Tellurnoid/25RoboCup/poster/138062.jpg

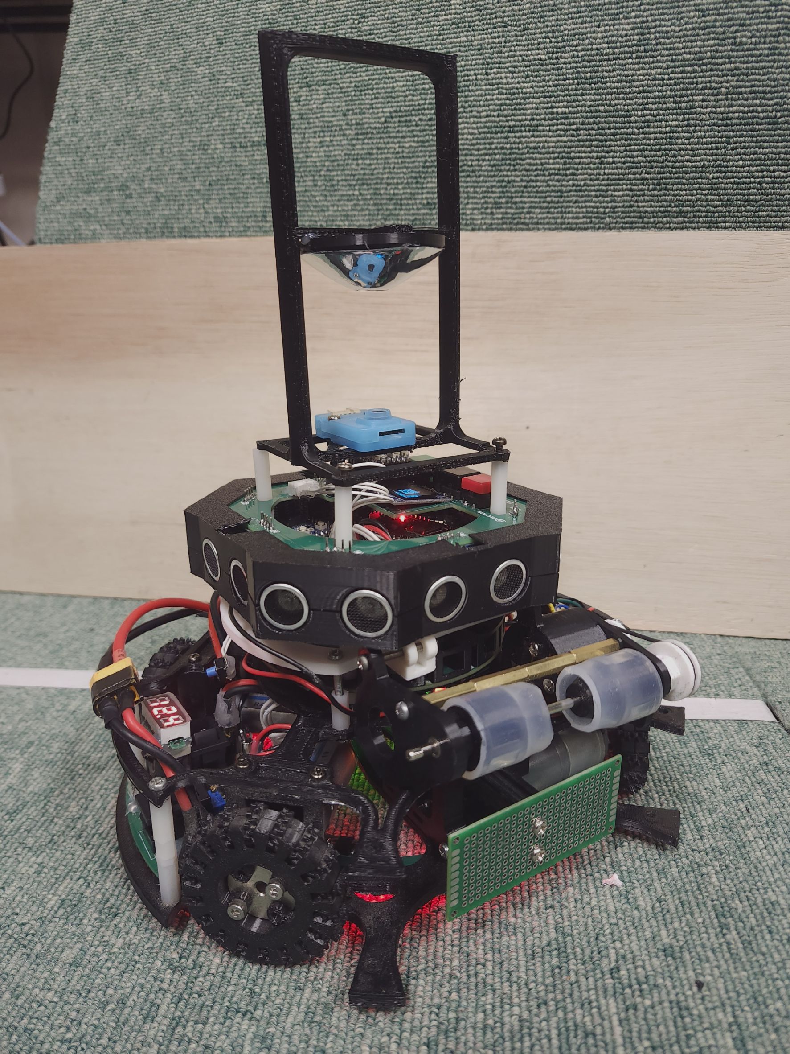
poster/138062.jpg
