Tellurnoid/25RoboCup/poster/56091_0.jpg

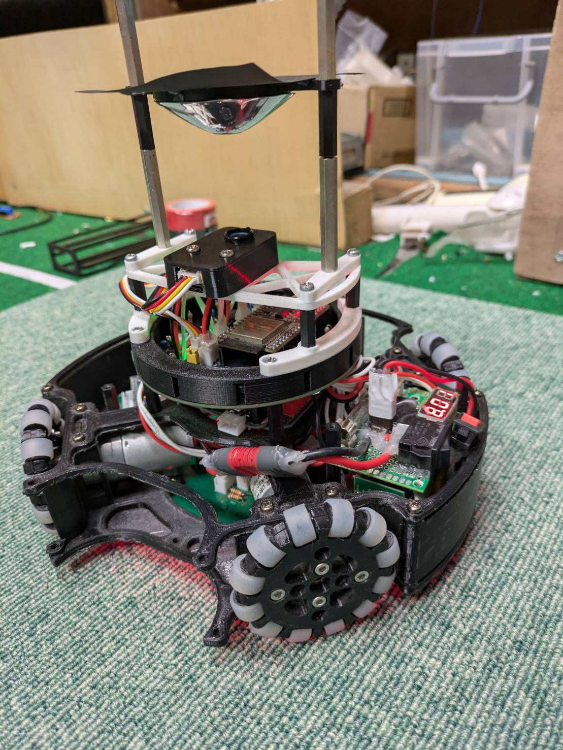
poster/56091_0.jpg
