Tellurnoid/25RoboCup/README.md

2025年度 ロボカップジュニア_ライトウェイト_サッカー競技に出場する、埼玉県立浦和高校物理部のチーム「URAWA BOLSAE(ボルセ)」の機体に関わる情報です。
