Tellurnoid/25RoboCup/北埼玉ノード/ポスターロボカップ/01.pdf

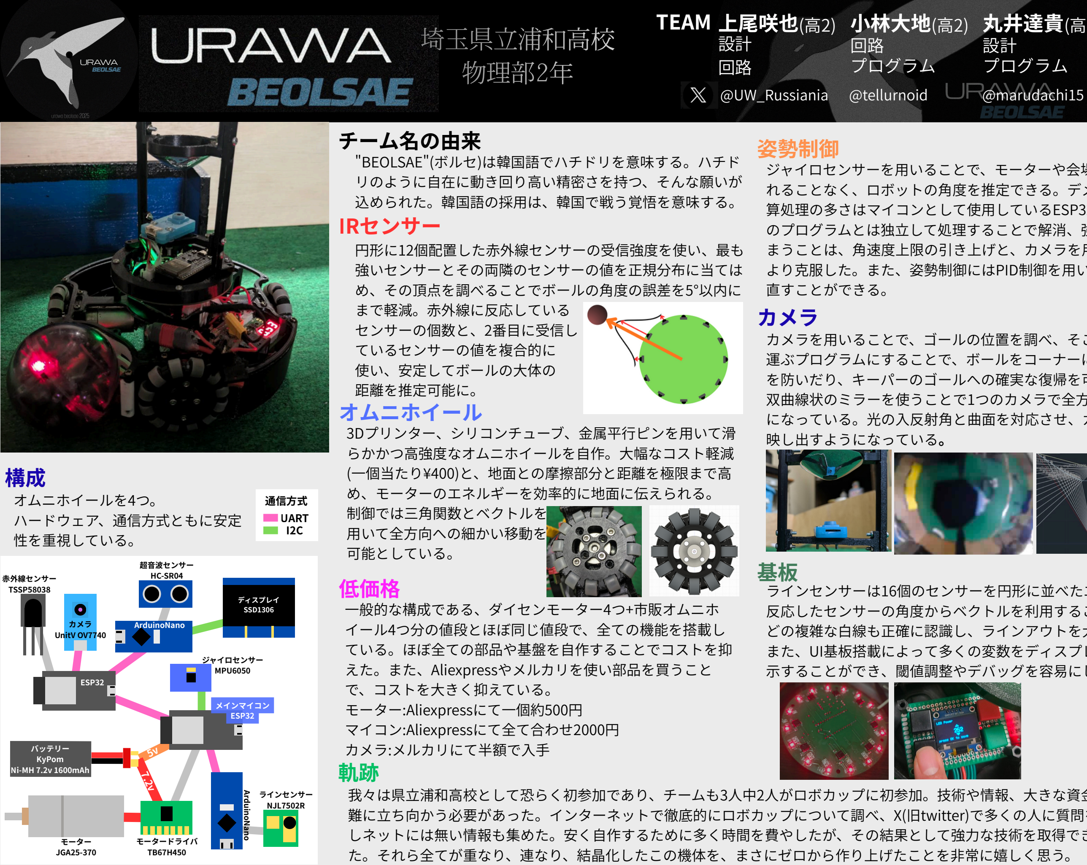
[picture p8: figure]
強いセンサーとその両隣のセンサーの値を正規分布に当ては; ているセンサーの値を複合的に; 距離を推定可能に。; IRセンサー; オムニホイール 3Dプリンター; 可能としている。; 姿勢制御; 直すことができる。 カメラ; 映し出すようになっている。; UART I2C; ディスプレイ SSD1306; カメラ UnitV OV7740; 赤外線センサー TSSP58038; ArduinoNano; ESP32; メインマイコン ESP32; 波センサー; モータードライバ TB67H450; モーター JGA25-370; ラインセンサー NJL7502R; バッテリー; KyPom Ni-MH 7.2v 1600mAh; ジャイロセンサー MPU6050; 通信方; 構成 オムニホイールを4つ。; 性を重視している。; 低価格; イール4つ分の値段とほぼ同じ値段で、全ての機能を搭載し; えた。また、Aliexpressやメルカリを使い部品を買うこと; マイコン:Aliexpressにて全て合わせ2000円; @UW_Russiania @tellurnoid; @marudachi15; チーム名の由来 "BEOLSAE"(ボルセ)は韓国語でハチドリを意味する。ハチド
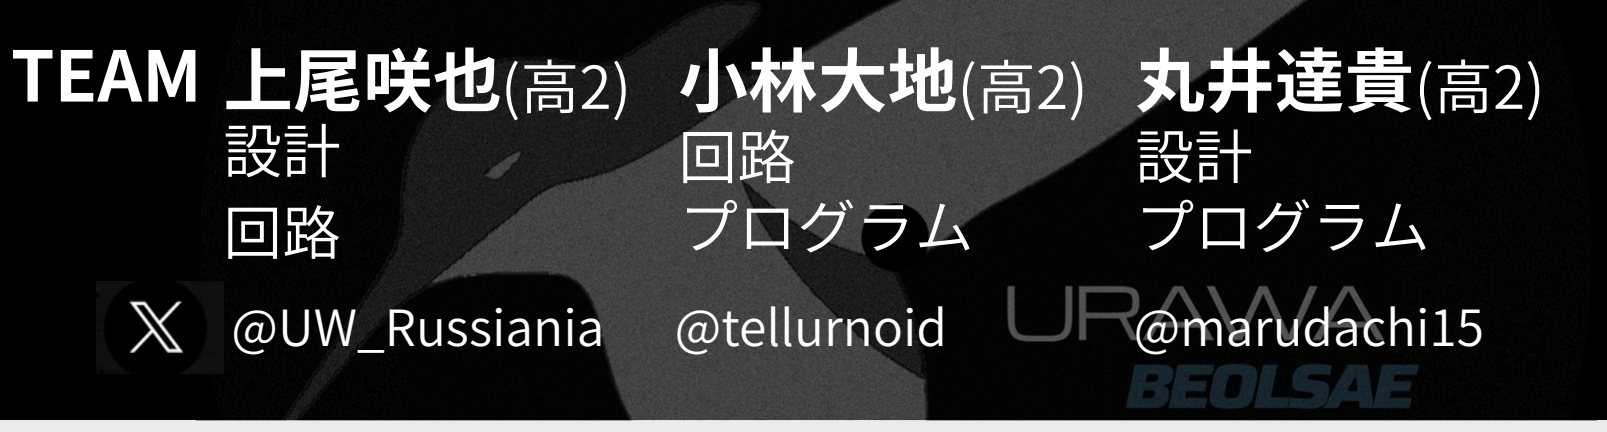
[picture p9: figure]
TEAM; 丸井達貴; 設計 プログラム; プログラム

小 | 林大 | 地 | (高 | 2) 回路
上尾咲也 | (高 | 2) 設計
円形に12個配置した | 赤外線センサーの受信強度を使い、最も
め、その頂点を調べることでボールの | 角度の誤差を5°以内に
まで軽減。 | 赤外線に反応している
センサーの個数と、2番 | 目に受信し
使い、安定してボールの | 大体の
、シリコンチューブ、 | 金属平 | 行ピンを | 用いて滑
らかかつ | 高強度なオムニホイールを | 自作。 | 大幅なコスト軽減
( | 一個当たり¥400)と、地 | 面との摩擦部分と距離を極限まで | 高
め、モーターのエネルギーを効率的に地 | 面に伝えられる。
制御では三 | 角関数とベクトルを
用いて全 | 方向への細かい移動を
ジャイロセンサーを | 用いることで、モーターや会場のノイズに影響さ
れることなく、ロボットの | 角度を推定できる。デメリットである、計
算処理の多さはマイコンとして使 | 用しているESP32の別コアでメイン
のプログラムとは独 | 立して処理することで解消、強い衝撃でズレてし
まうことは、 | 角速度上限の引き上げと、カメラを | 用いた | 角度の修正に
より克服した。また、姿勢制御にはPID制御を | 用いて、
一瞬で姿勢を
カメラを | 用いることで、ゴールの位置を調べ、そこに向けてボールを

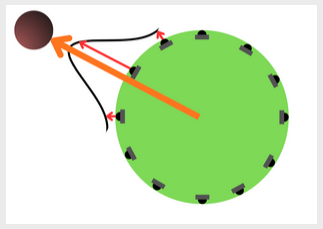
[picture p10: figure]

運ぶプログラムにすることで、ボールをコーナーに運んでしまうこと を防いだり、キーパーのゴールへの確実な復帰を可能にしている。

双曲線状のミラーを使うことで1つのカメラで全 | 方位が | 見渡せるよう
になっている。光の | 入反射 | 角と曲 | 面を対応させ、カメラに広い | 風景を
我々は県 | 立浦和 | 高校として恐らく初参加であり、チームも3 | 人中2 | 人がロボカップに初参加。技術や情報、 | 大きな資 | 金
難に | 立ち向かう必要があった。インターネットで徹底的にロボカップについて調べ、X(旧twitter)で多くの | 人に質問を
しネットには無い情報も集めた。安く | 自作するために多く時間を費やしたが、その結果として強 | 力な技術を取得でき
た。それら全てが重なり、連なり、結晶化したこの機体を、まさにゼロから作り上げたことを | 非常に嬉しく思う。

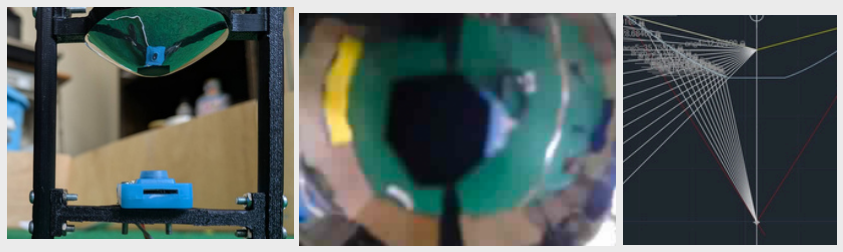
[picture p11: figure]
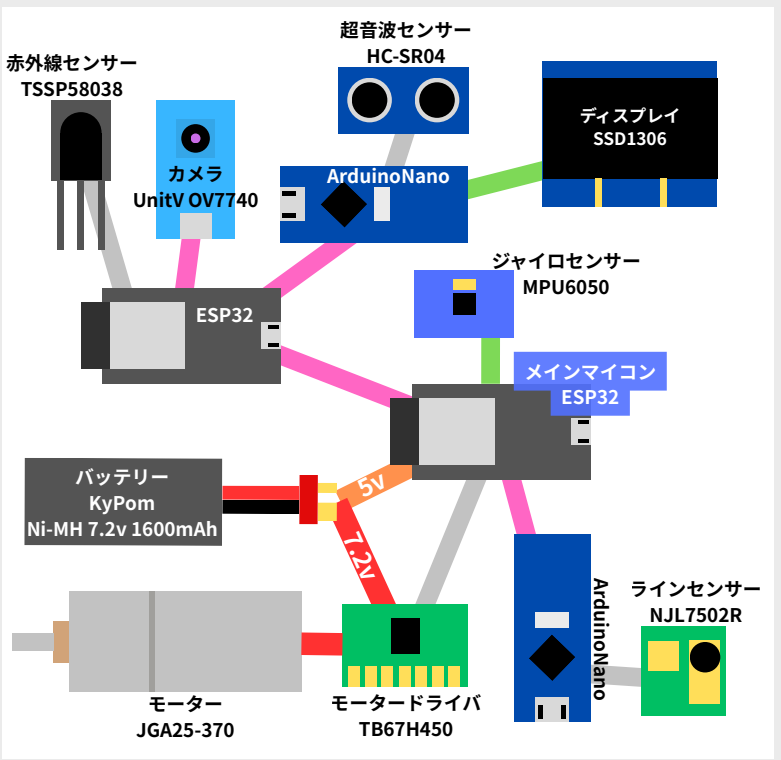
[picture p12: figure]

ラインセンサーは16個のセンサーを円形に並べたエンジェルリング。

反応したセンサーの | 角度からベクトルを利 | 用することで、コーナーな
どの複雑な | 白線も正確に認識し、ラインアウトを | 大きく減らした。

また、UI基板搭載によって多くの変数をディスプレイ(SSD1306)に表

示することができ、閾値調整やデバッグを容易にしている。

# ハードウェア、通信 方式ともに安定

# 一般的な構成である、ダイセンモーター4つ+市販オムニホ

ている。ほぼ全ての部品や基盤を | 自作することでコストを抑
で、コストを | 大きく抑えている。
モーター:Aliexpressにて | 一個約500円
カメラ:メルカリにて半額で | 入手

# WSLN-01

リのように | 自在に動き回り | 高い精密さを持つ、そんな願いが
込められた。韓国語の採 | 用は、韓国で戦う覚悟を意味する。
