Tellurnoid/25RoboCup/埼玉ブロック/名称未設定.pdf

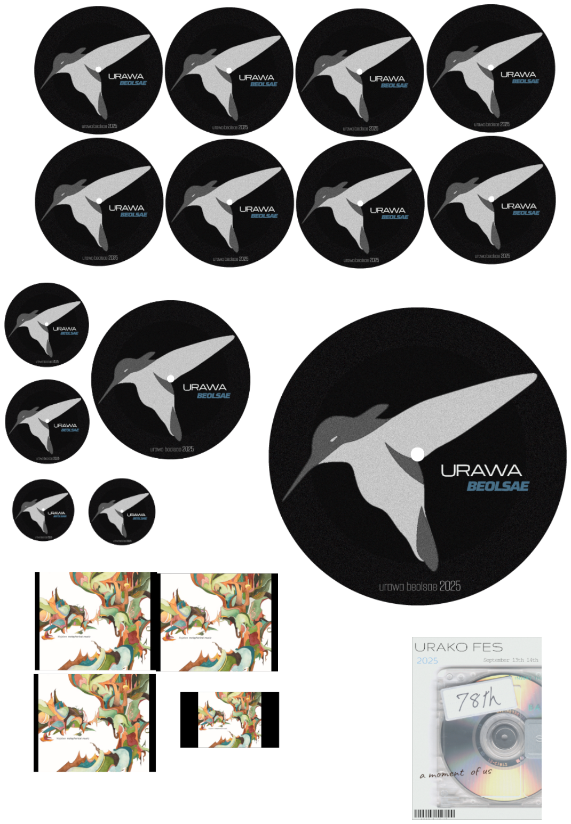
[picture p13: page 1]
