Tellurnoid/25RoboCup/KiCad/Main_RCJ_Japan_prot2_with_kickBoard/pl9823.pdf

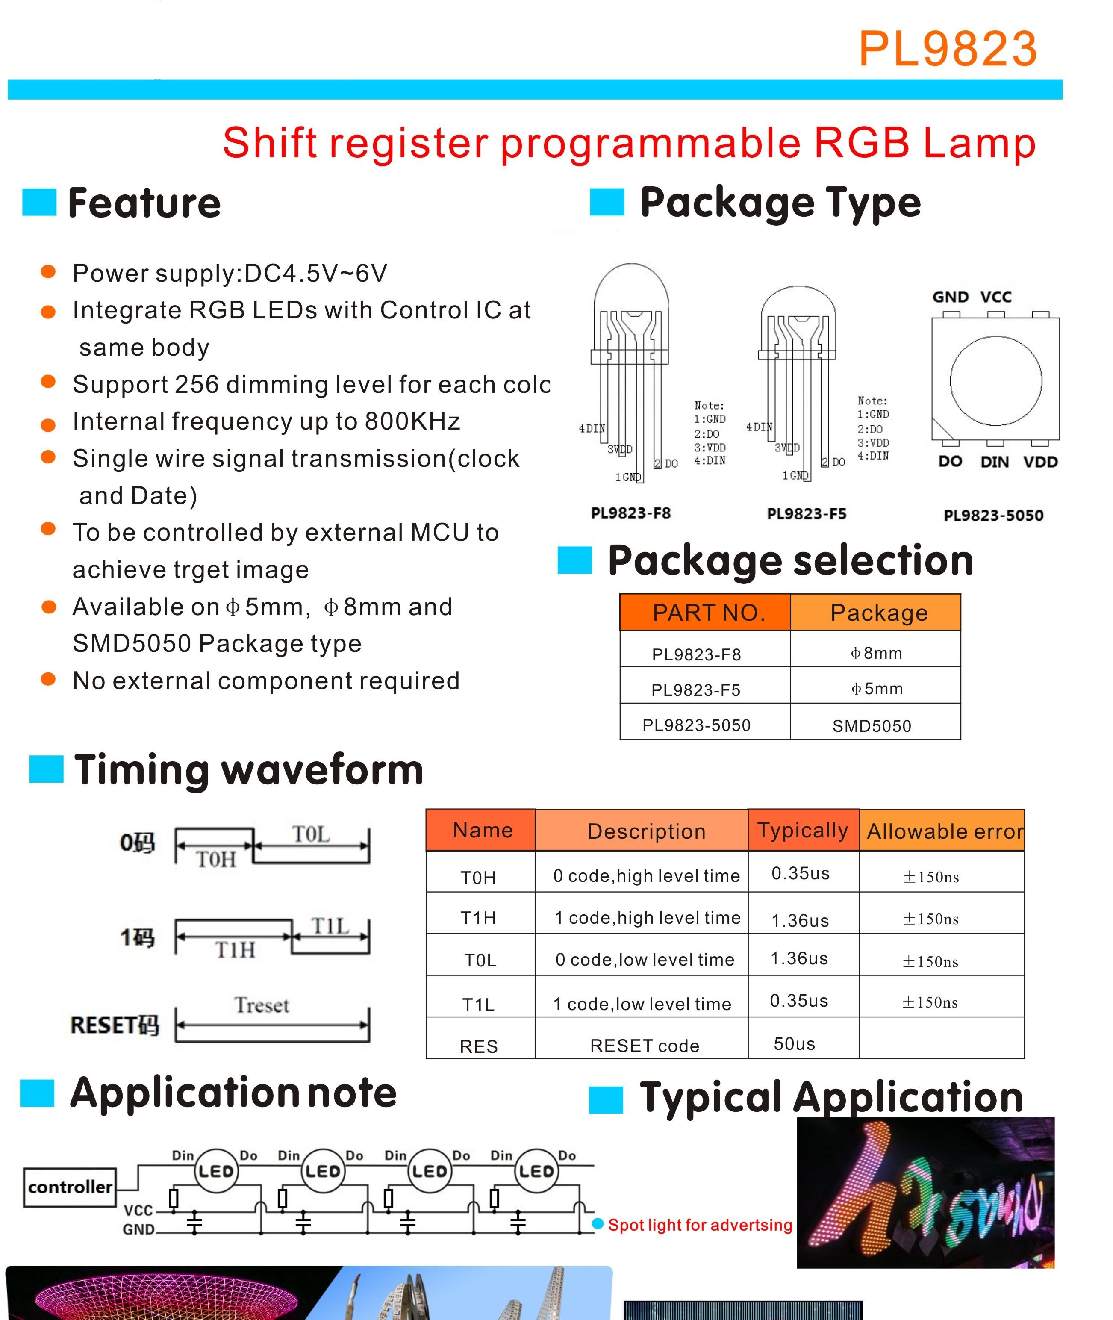
[picture p14: page 1]
