Tellurnoid/25RoboCup/北埼玉ノード/ポスターロボカップ/02.pdf

# ぼたもち浦和

## 🍡オムニホイール

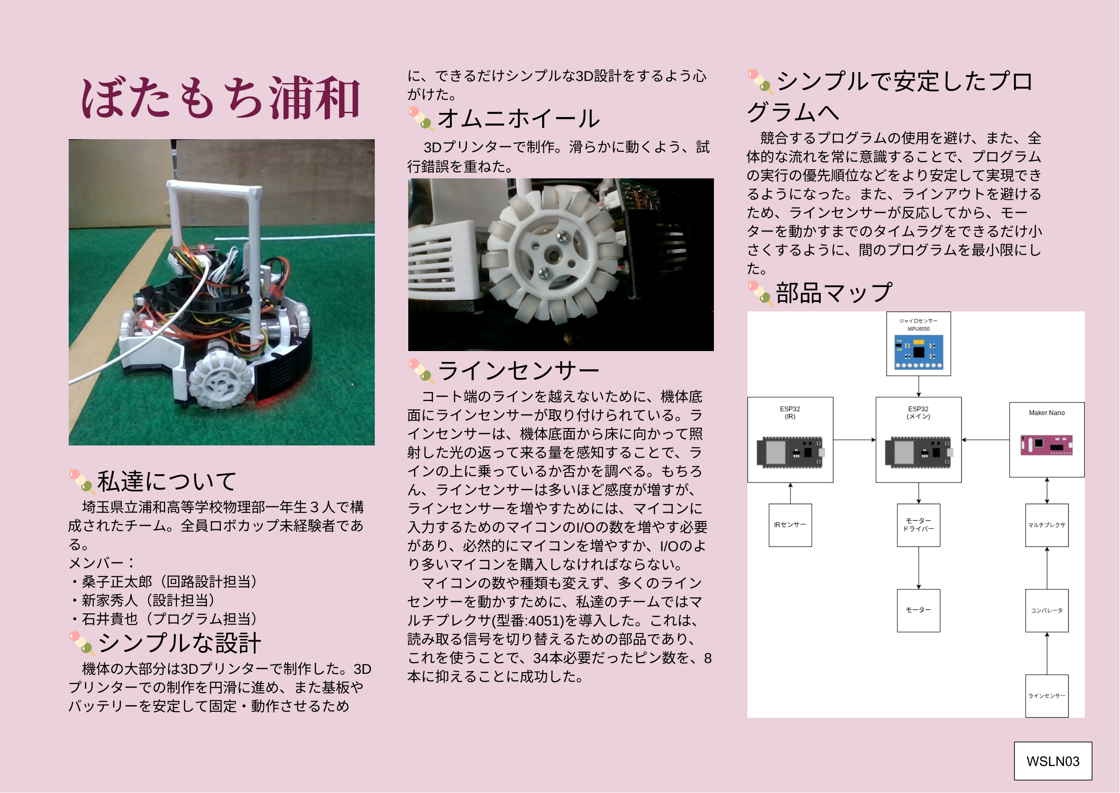
[picture p15: page 1]

## 🍡私達について

埼玉県立浦和高等学校物理部一年生３人で構
成されたチーム。全員ロボカップ未経験者であ
る。
メンバー：
・ | 桑子正太郎（回路設計担当）
・ | 新家秀人（設計担当）
・ | 石井貴也（プログラム担当）

## 🍡シンプルな設計

機体の大部分は3Dプリンターで制作した。3D
プリンターでの制作を円滑に進め、また基板や
バッテリーを安定して固定・ 動作させるため

に、できるだけシンプルな3D設計をするよう心
がけた。

3Dプリンターで制作。滑らかに動くよう、試
行錯誤を重ねた。

## 🍡ラインセンサー

コート端のラインを越えないために、機体底
面にラインセンサーが取り付けられている。ラ
インセンサーは、機体底面から床に向かって照
射した光の返って来る量を感知することで、ラ
インの上に乗っているか否かを調べる。もちろ
ん、ラインセンサーは多いほど感度が増すが、
ラインセンサーを増やすためには、マイコンに
入力するためのマイコンのI/Oの数を増やす必要
があり、必然的にマイコンを増やすか、I/Oのよ
り多いマイコンを購入しなければならない。
マイコンの数や種類も変えず、多くのライン
センサーを動かすために、私達のチームではマ
ルチプレクサ(型番:4051)を導入した。これは、
読み取る信号を切り替えるための部品であり、
これを使うことで、34本必要だったピン数を、8
本に抑えることに成功した。

## 🍡シンプルで安定したプロ グラムへ

競合するプログラムの使用を避け、また、全
体的な流れを常に意識することで、プログラム
の実行の優先順位などをより安定して実現でき
るようになった。また、ラインアウトを避ける
ため、ラインセンサーが反応してから、モー
ターを動かすまでのタイムラグをできるだけ小
さくするように、間のプログラムを最小限にし
た。

## 🍡部品マップ
