Tellurnoid/25RoboCup/北埼玉ノード/ポスターロボカップ/03.pdf

浦和Biginners | 機体について
～私たちが作りました～ | ～機体の特徴～
・齋藤也生海 | 機体名：第弐号機（仮）
今年の夏、物理部に入部した。 | ・四輪駆動 | ・ラインセンサー
何かと仕事に追われている。 | これにすることによって多方向に | 白線を検知して避ける仕組み。
つまり社畜。 | 動くことができる。オムニホイールを | ラインを検知するとちゃんと音が
担当：本体とプログラミング | 追加することにより、これを増強できる。なるようにプログラミングしている。
・外裏晴也 | ・赤外線センサー | ・本体
彼がこのチームの神である。 | もちろんこれなしにはボールが追えない。 ３Dプリンターを使って作った。
仕事がとても速い。彼の基板設計 | センサーには今夏に入手した、 | 強度と重さを調整するのが大変だった。
には毎度助けられている... | ３Dプリンタで作ったカバーが被されて | 密度なども考えた。
担当：基板など | 誤作動が低減されている。
・住田真明 | 機体名：第参号機（仮）
英語部と兼部しているため、 | ・二輪駆動 | ・キーパー
そんなに作業ができてないが、 | 比較的制御しやすい。そして速い。 白線の上を上手く動くようにそして、ボールの
いざというときに頼りになる。 | 位置を補足し、動くようになっている。
担当：臨機応変

## ～意気込み～

私はまだ始めたばかりですが真心と気合と気合と気合をこめて作りました。私たちの作品を
製作場所 | ぜひご覧ください! 齋藤 也生海

## 埼玉県立浦和高校 文化棟2階物理部室
