Tellurnoid/25RoboCup/IR基板/40487.png

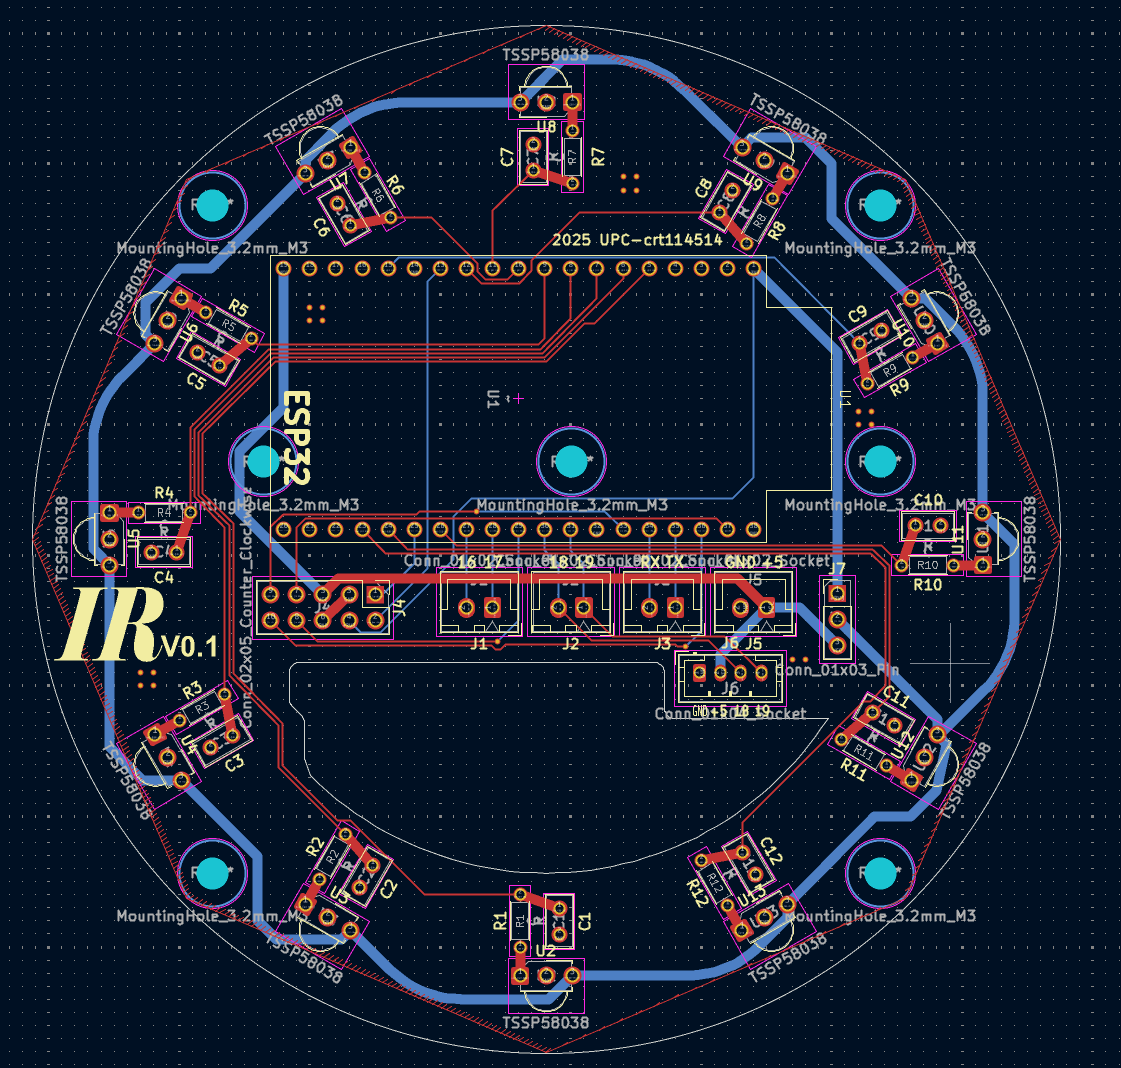
IR基板/40487.png
