Tellurnoid/25RoboCup/KiCad/fet104-300wri.png

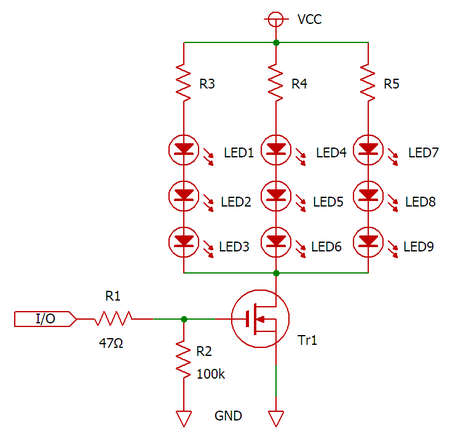
KiCad/fet104-300wri.png
