Tellurnoid/25RoboCup/KiCad/IR_Japan_prot3/40488.png

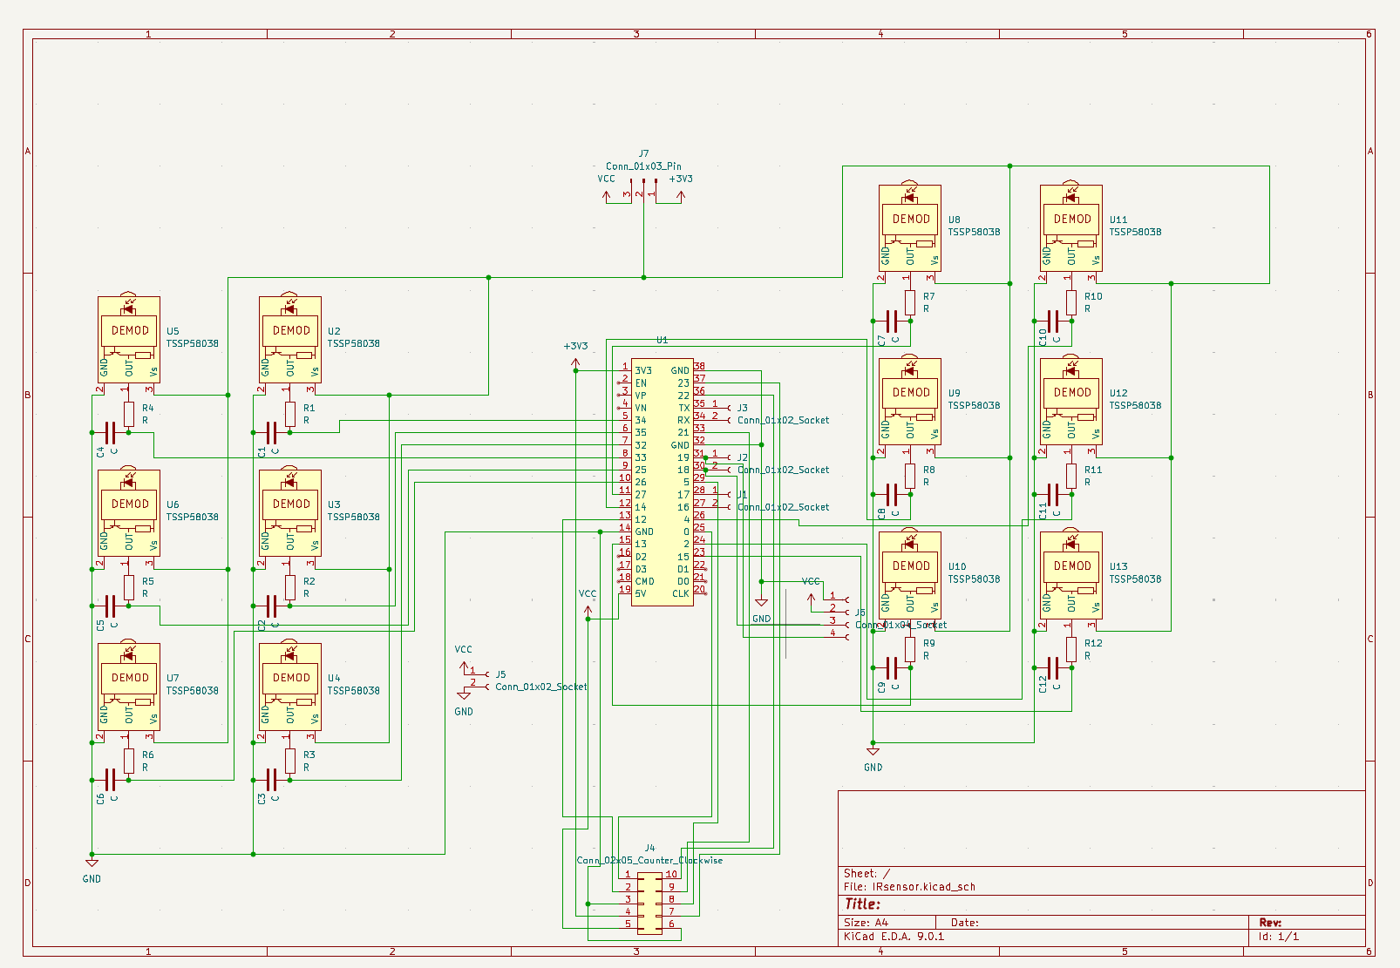
KiCad/IR_Japan_prot3/40488.png
