Tellurnoid/25RoboCup/KiCad/KickBoard/urawa_beolsae1_背景黒あり.png

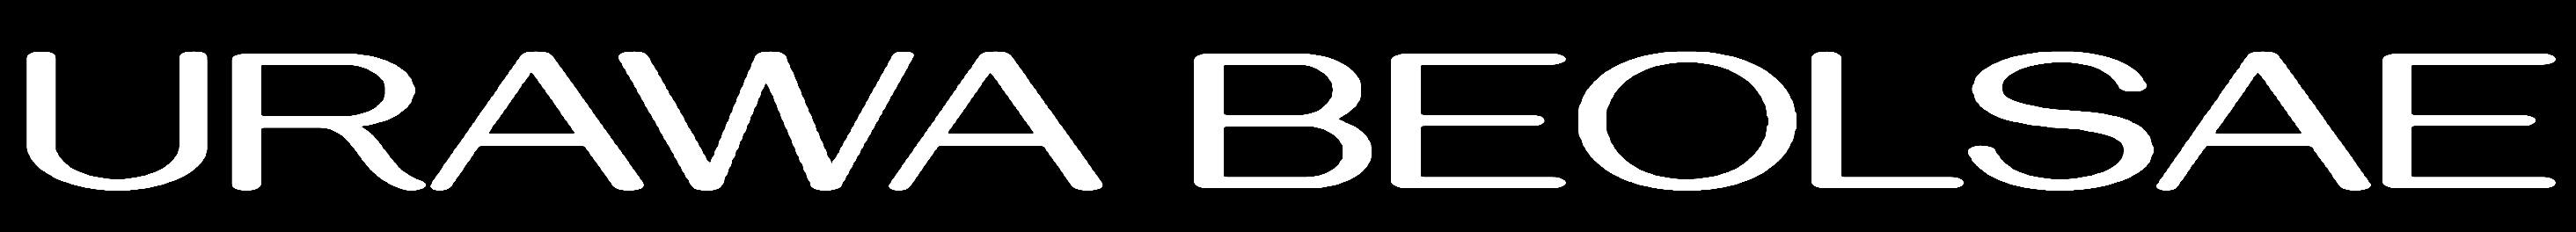
KiCad/KickBoard/urawa_beolsae1_背景黒あり.png
