Tellurnoid/25RoboCup/KiCad/Main_RCJ_Japan_prot2_with_kickBoard/58697.jpg

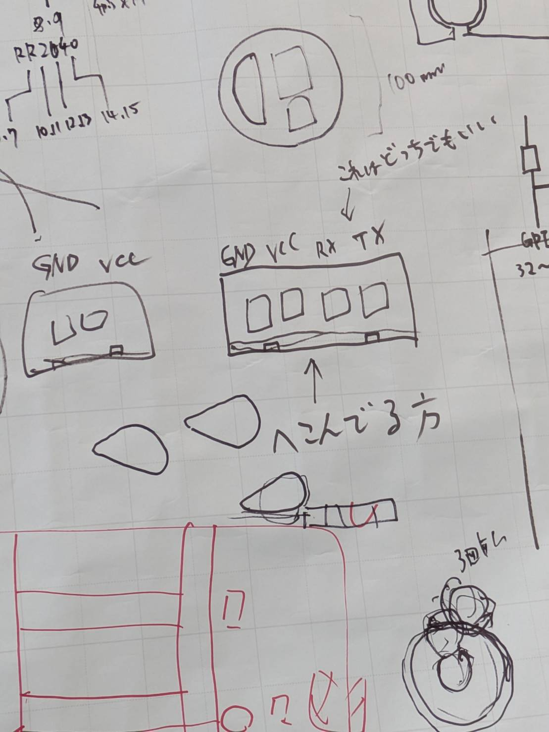
KiCad/Main_RCJ_Japan_prot2_with_kickBoard/58697.jpg
