Tellurnoid/25RoboCup/KiCad/Screenshot from 2026-02-24 19-36-52.png

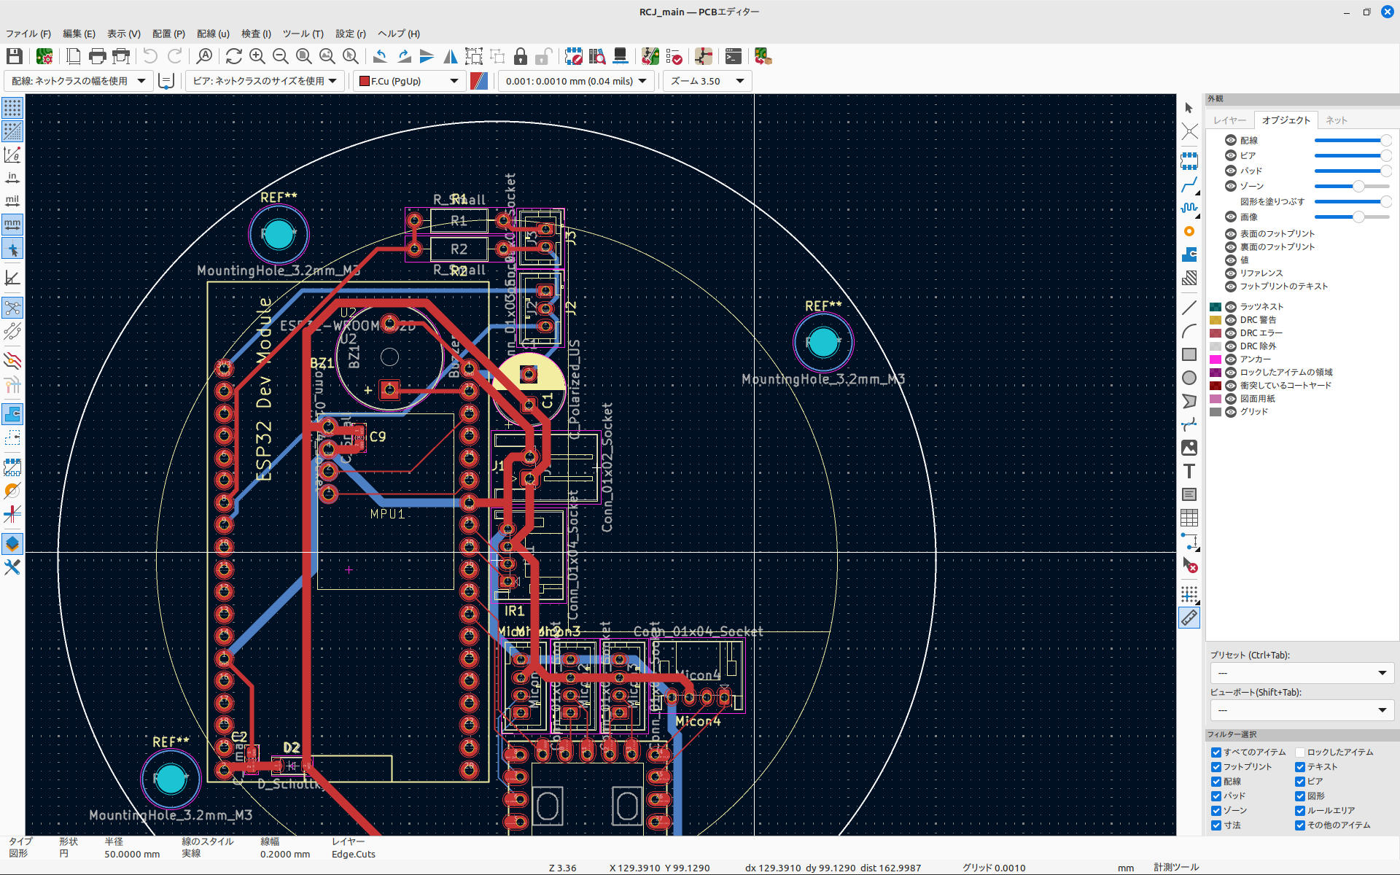
KiCad/Screenshot from 2026-02-24 19-36-52.png
