Tellurnoid/25RoboCup/KiCad/Screenshot from 2026-02-24 19-39-12.png

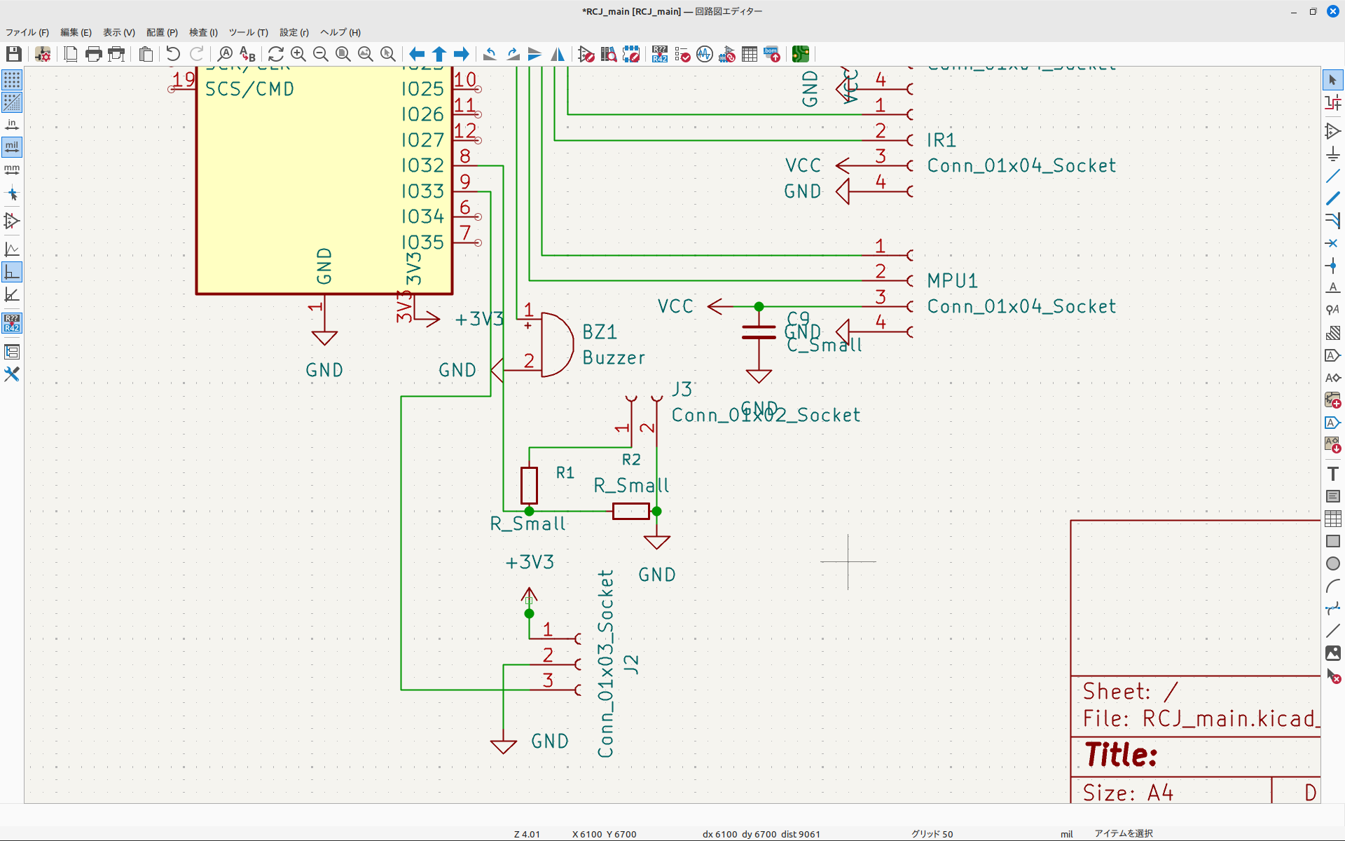
KiCad/Screenshot from 2026-02-24 19-39-12.png
