Tellurnoid/25RoboCup/poster/138026.jpg

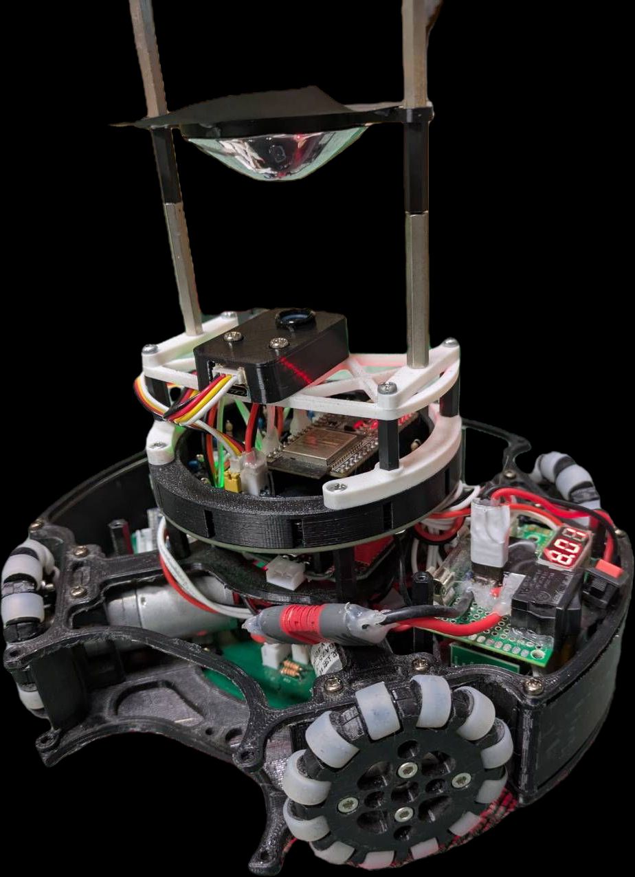
poster/138026.jpg
