Tellurnoid/25RoboCup/poster/jlcpcb.png

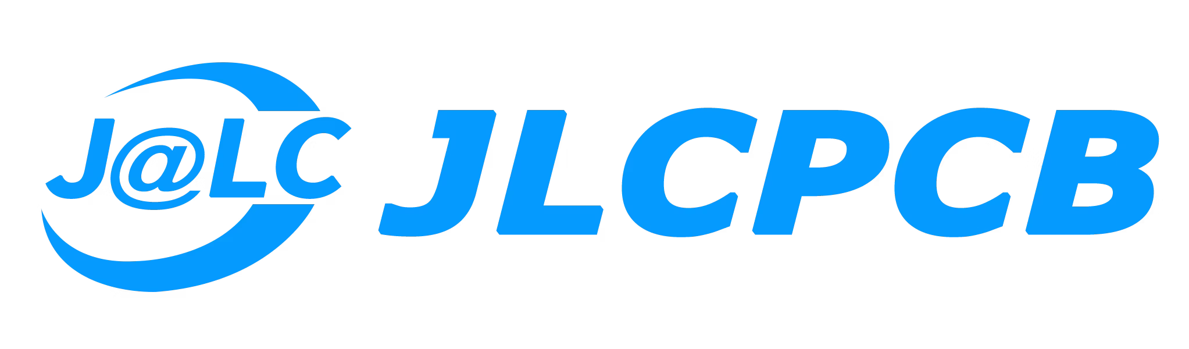
poster/jlcpcb.png
