Tellurnoid/25RoboCup/poster/QR_421440.png

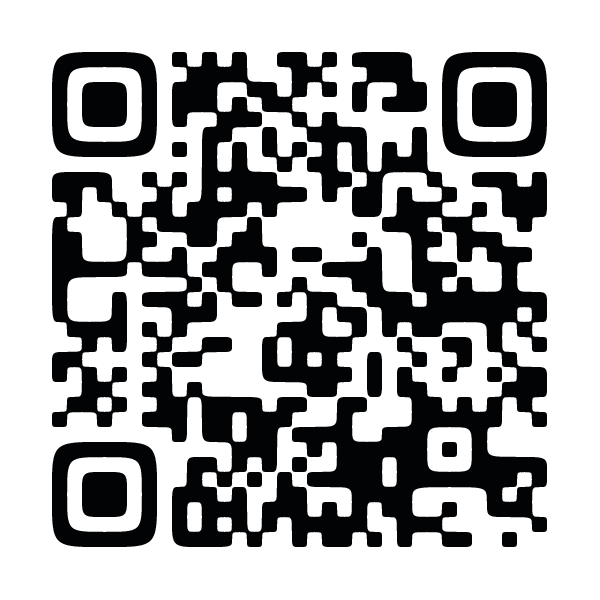
poster/QR_421440.png
