Tellurnoid/25RoboCup/poster/Screenshot from 2026-03-02 20-02-42.png

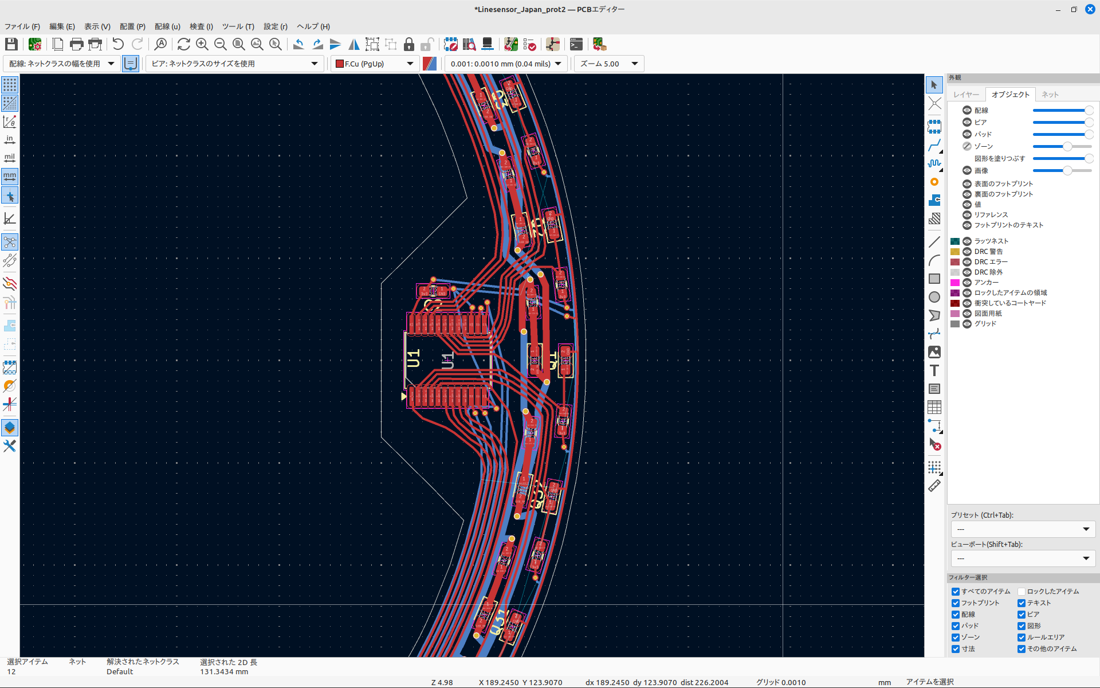
poster/Screenshot from 2026-03-02 20-02-42.png
