Tellurnoid/25RoboCup/poster/Screenshot from 2026-03-02 20-15-40.png

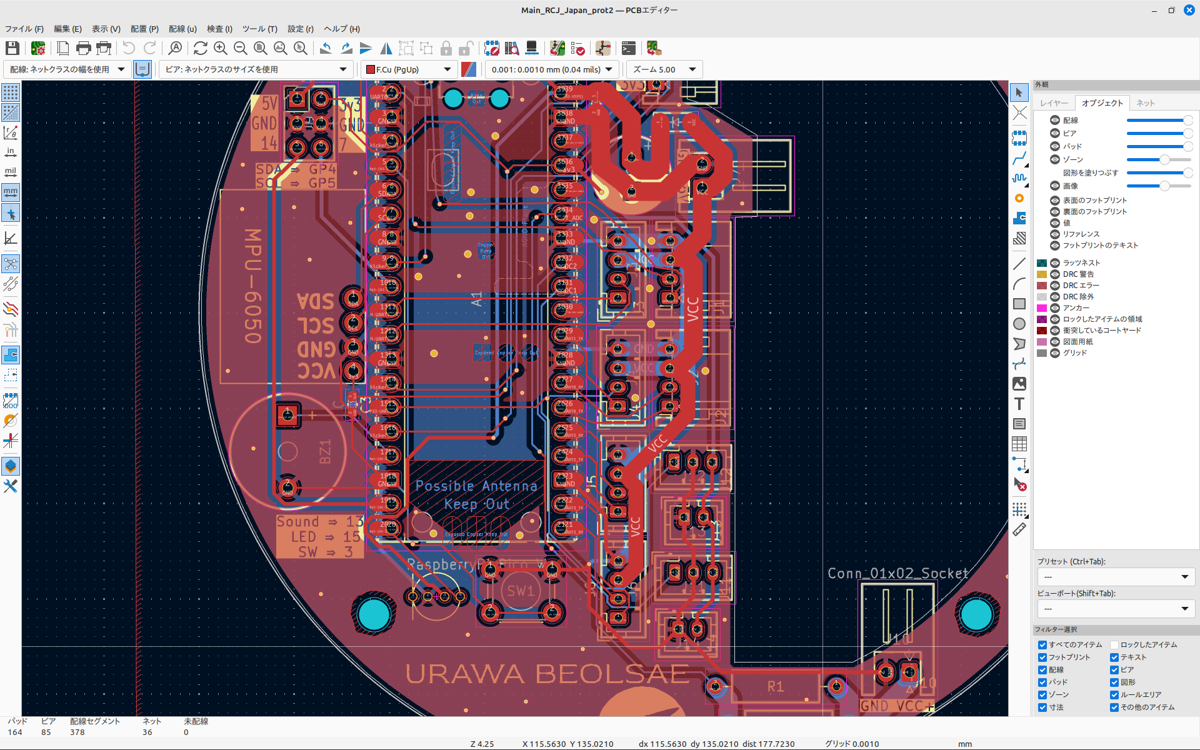
poster/Screenshot from 2026-03-02 20-15-40.png
