Tellurnoid/25RoboCup/poster/unnamed.jpg

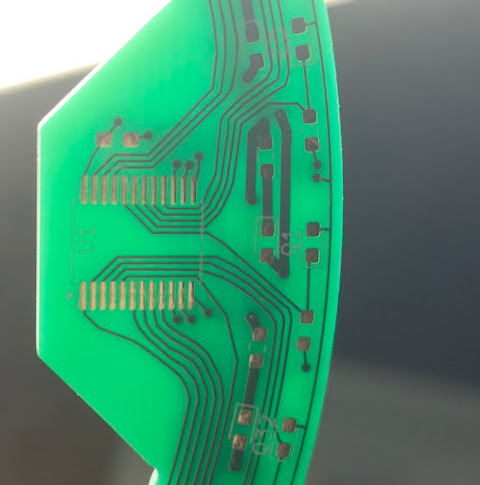
poster/unnamed.jpg
