Tellurnoid/25RoboCup/poster/urawa-300x295.jpg

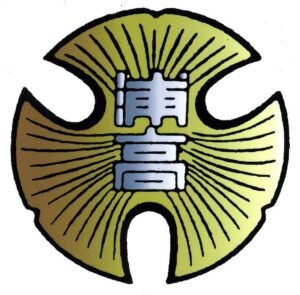
poster/urawa-300x295.jpg
