Tellurnoid/25RoboCup/poster/ロゴ透過 (コピー).png

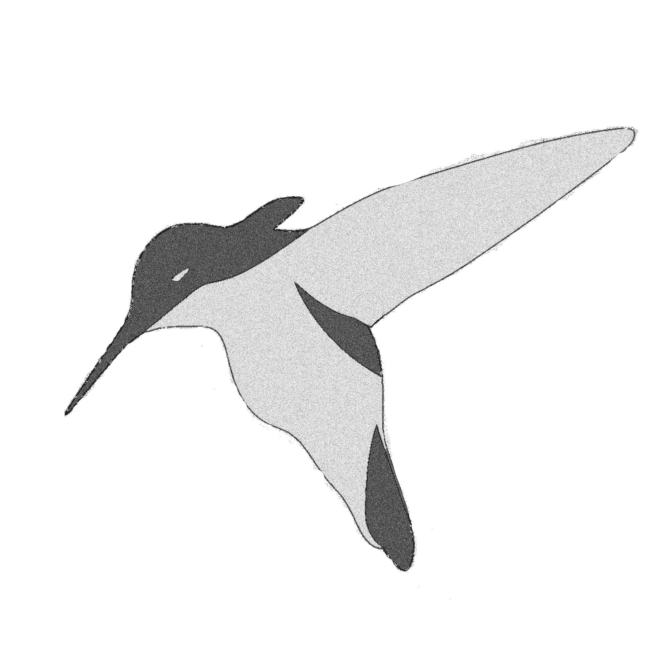
poster/ロゴ透過 (コピー).png
