Tellurnoid/25RoboCup/パーカー/prot3.png

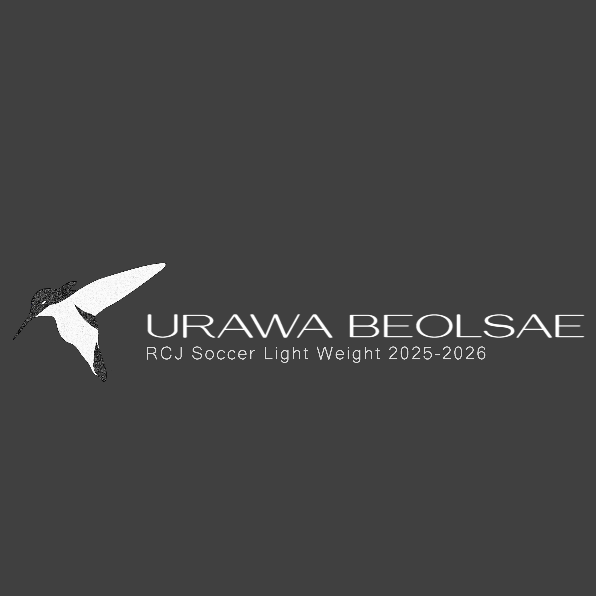
パーカー/prot3.png
