Tellurnoid/25RoboCup/写真とメモ/RaspberryPiPico_pwm.jpg

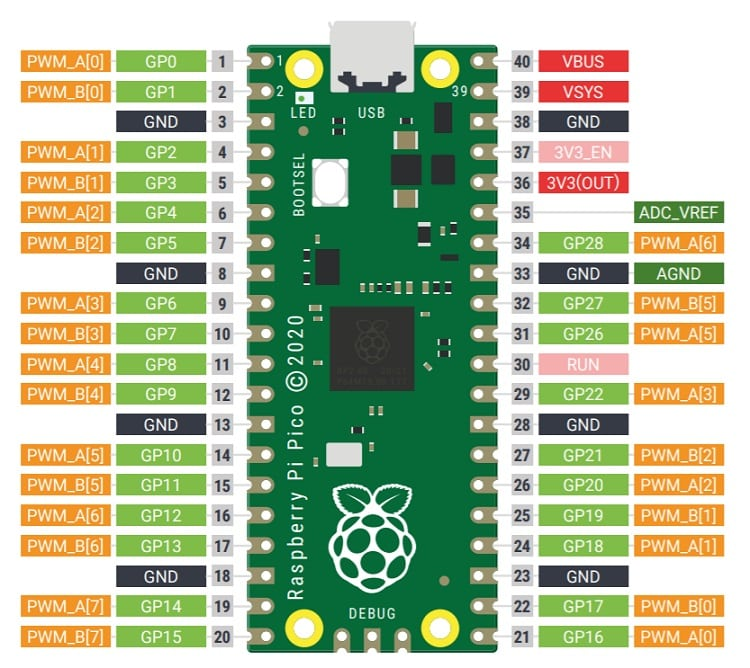
写真とメモ/RaspberryPiPico_pwm.jpg
