Tellurnoid/25RoboCup/写真とメモ/rp2040_PIO図.png

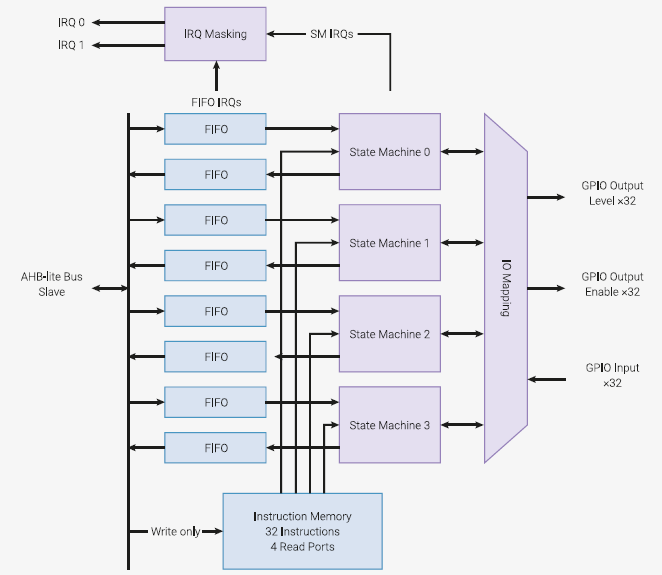
写真とメモ/rp2040_PIO図.png
