Tellurnoid/25RoboCup/写真とメモ/Screenshot from 2025-12-26 17-23-52.png

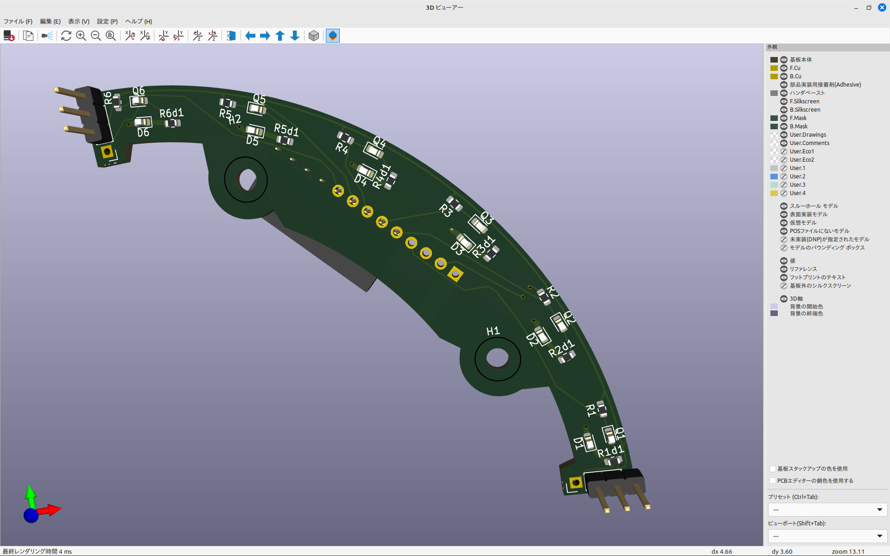
写真とメモ/Screenshot from 2025-12-26 17-23-52.png
