Tellurnoid/25RoboCup/写真とメモ/Screenshot from 2025-12-26 22-50-56.png

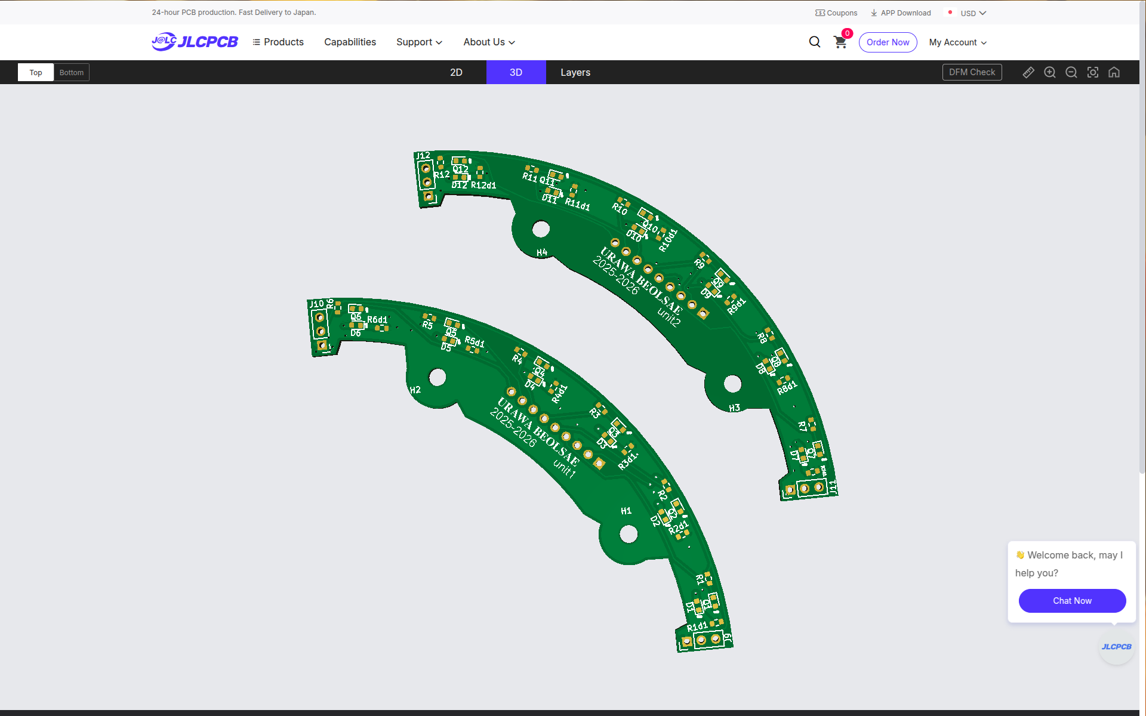
写真とメモ/Screenshot from 2025-12-26 22-50-56.png
