Tellurnoid/25RoboCup/写真とメモ/Screenshot from 2025-12-26 22-57-54.png

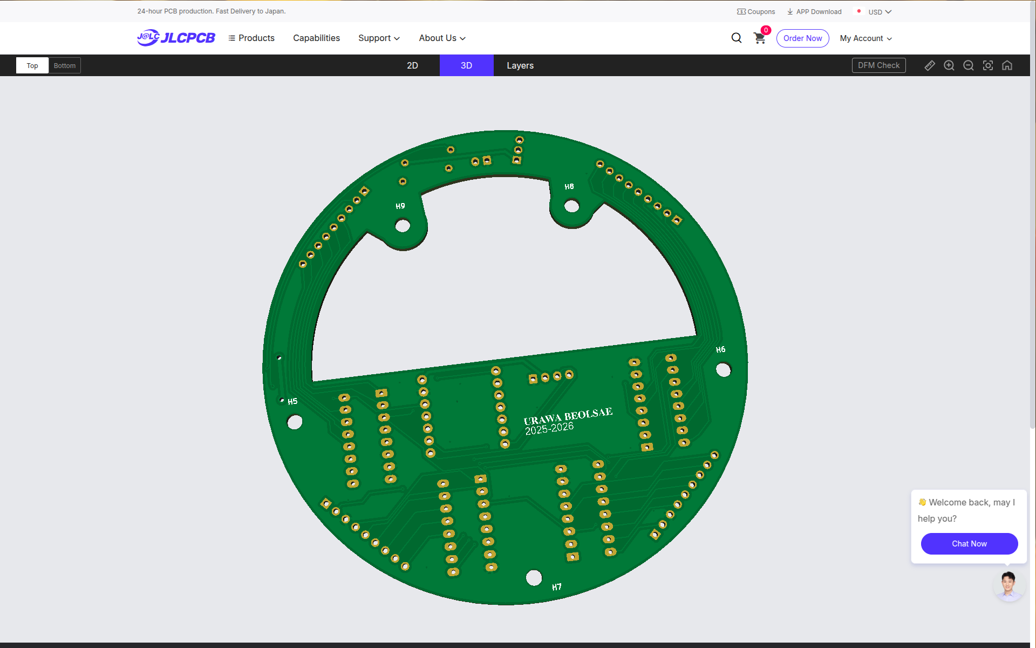
写真とメモ/Screenshot from 2025-12-26 22-57-54.png
