Tellurnoid/25RoboCup/写真とメモ/Screenshot from 2026-01-02 15-50-28.png

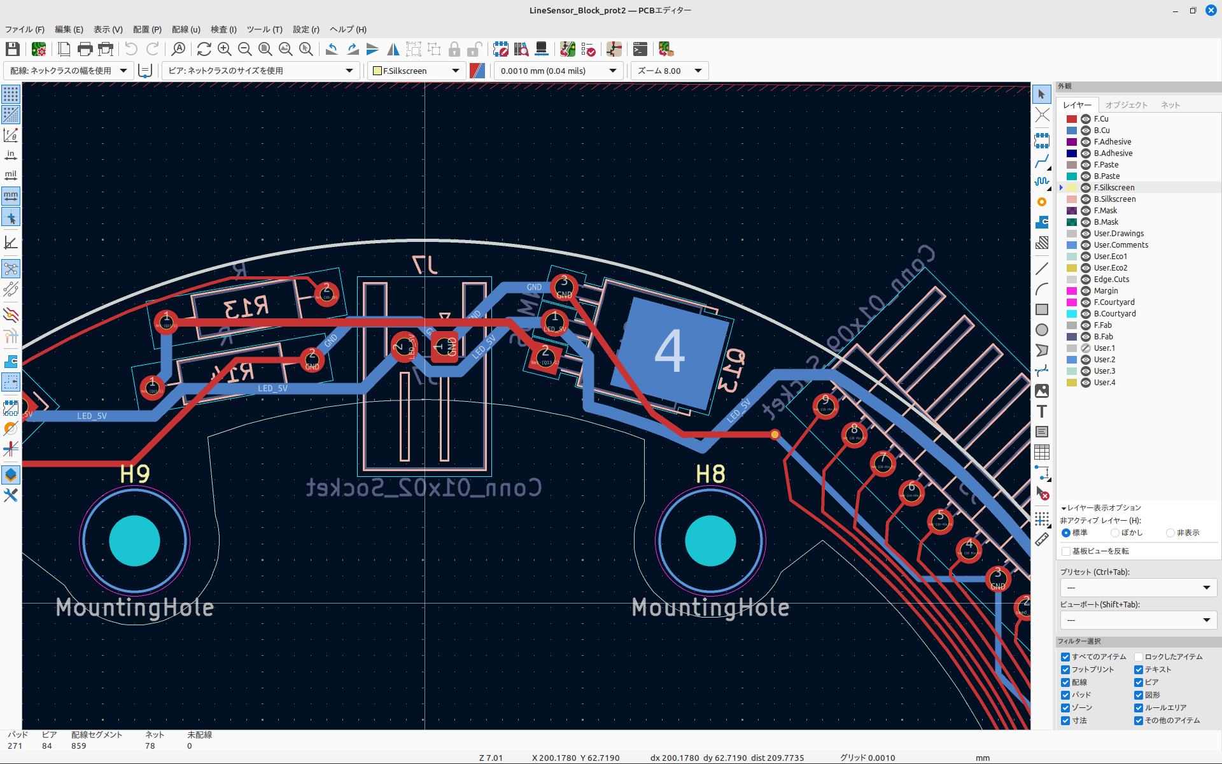
写真とメモ/Screenshot from 2026-01-02 15-50-28.png
