Tellurnoid/25RoboCup/写真とメモ/Screenshot from 2026-02-01 20-54-09.png

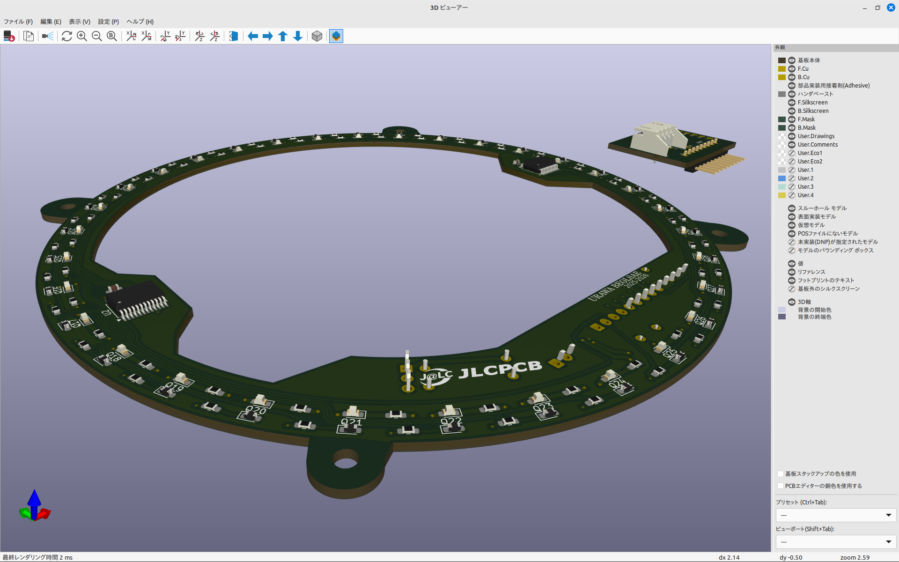
写真とメモ/Screenshot from 2026-02-01 20-54-09.png
