Tellurnoid/25RoboCup/写真とメモ/unnamed.jpg

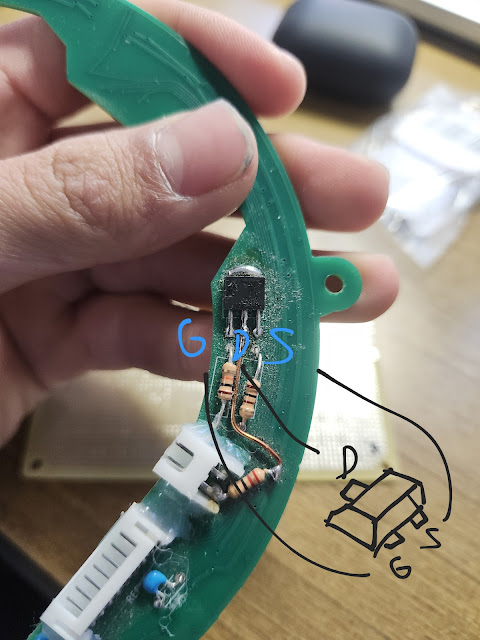
写真とメモ/unnamed.jpg
