Tellurnoid/25RoboCup/北埼玉ノード/kiCad/TBTMOTOR/Screenshot from 2025-11-28 18-42-37.png

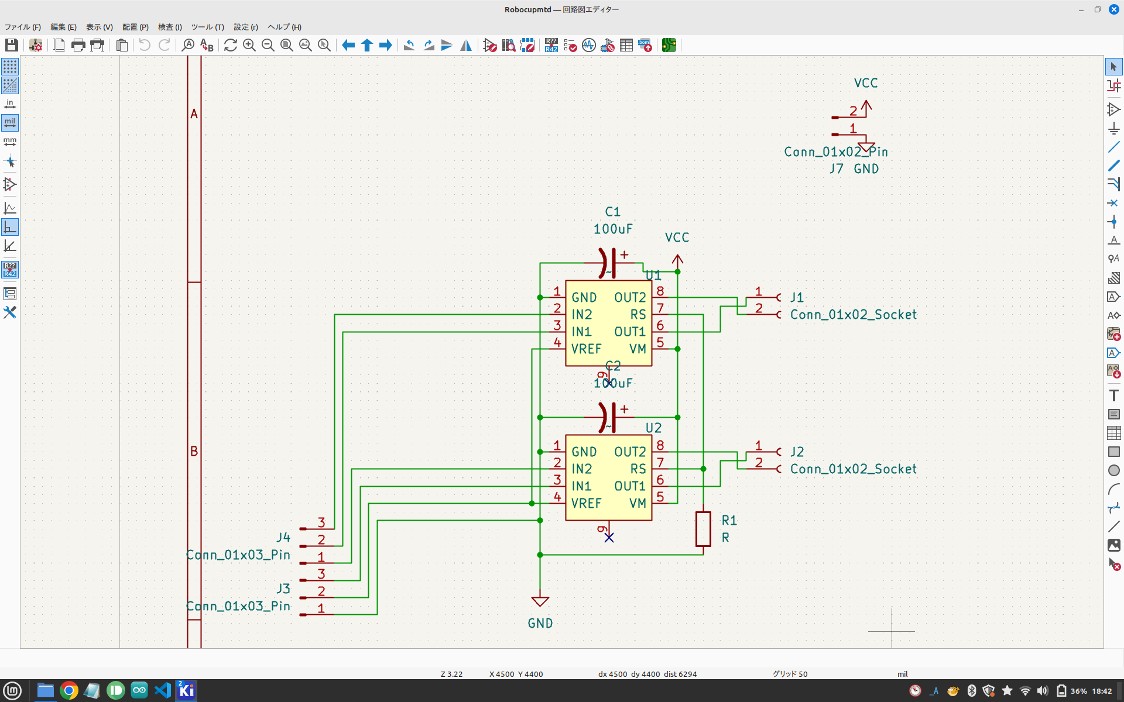
北埼玉ノード/kiCad/TBTMOTOR/Screenshot from 2025-11-28 18-42-37.png
