Tellurnoid/25RoboCup/北埼玉ノード/ssdUI/tests/フォント/lcds___displays_specimens.png

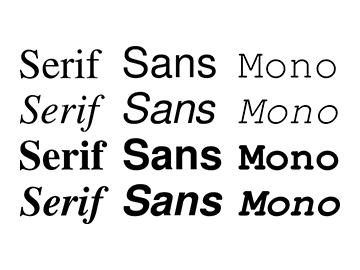
北埼玉ノード/ssdUI/tests/フォント/lcds___displays_specimens.png
