Tellurnoid/25RoboCup/北埼玉ノード/ポスターロボカップ/01.png

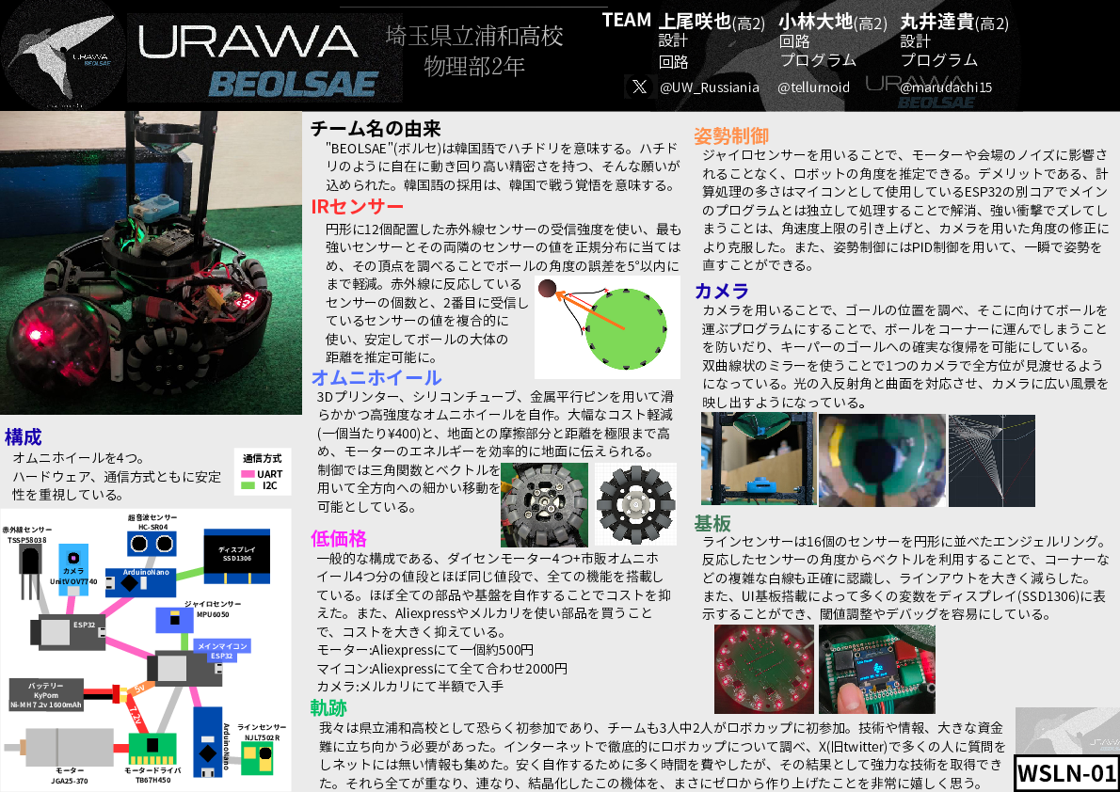
北埼玉ノード/ポスターロボカップ/01.png
