Tellurnoid/25RoboCup/北埼玉ノード/ポスターロボカップ/03.png

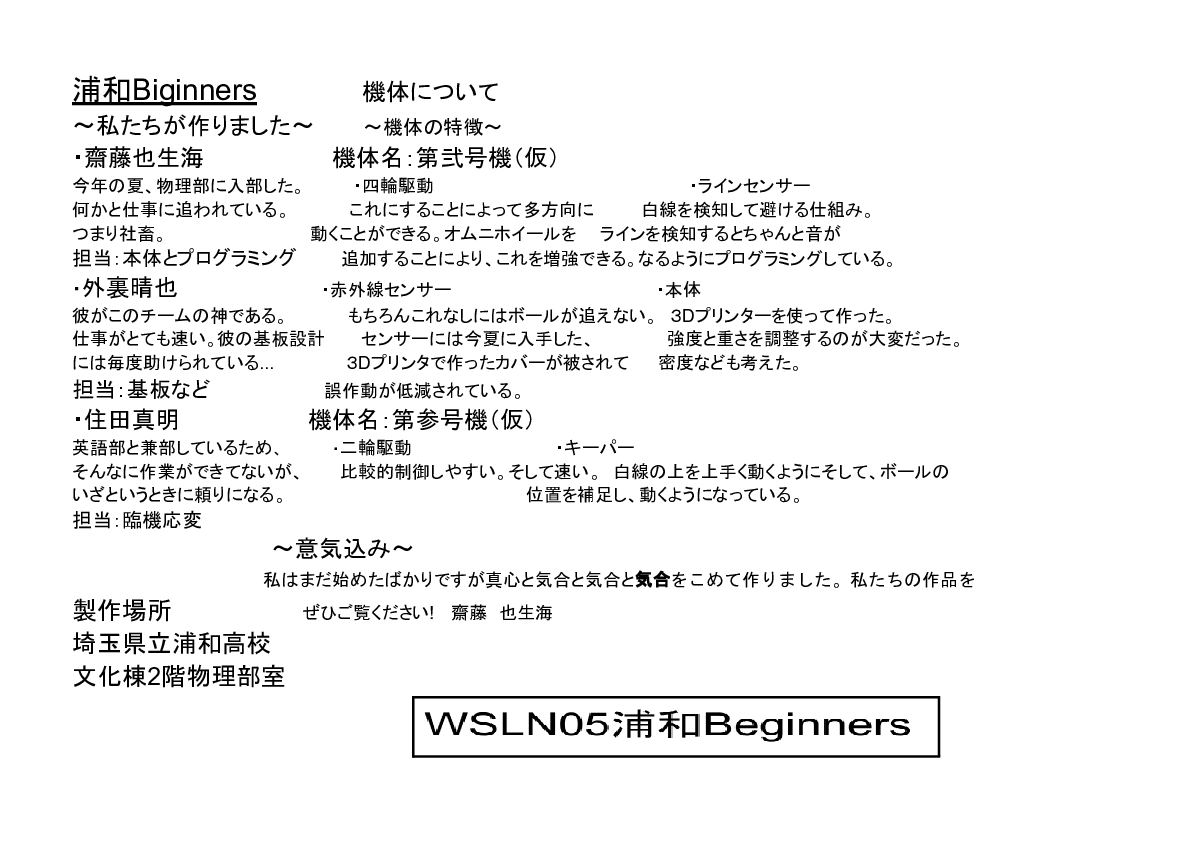
北埼玉ノード/ポスターロボカップ/03.png
