Tellurnoid/25RoboCup/埼玉ブロック/51494.jpg

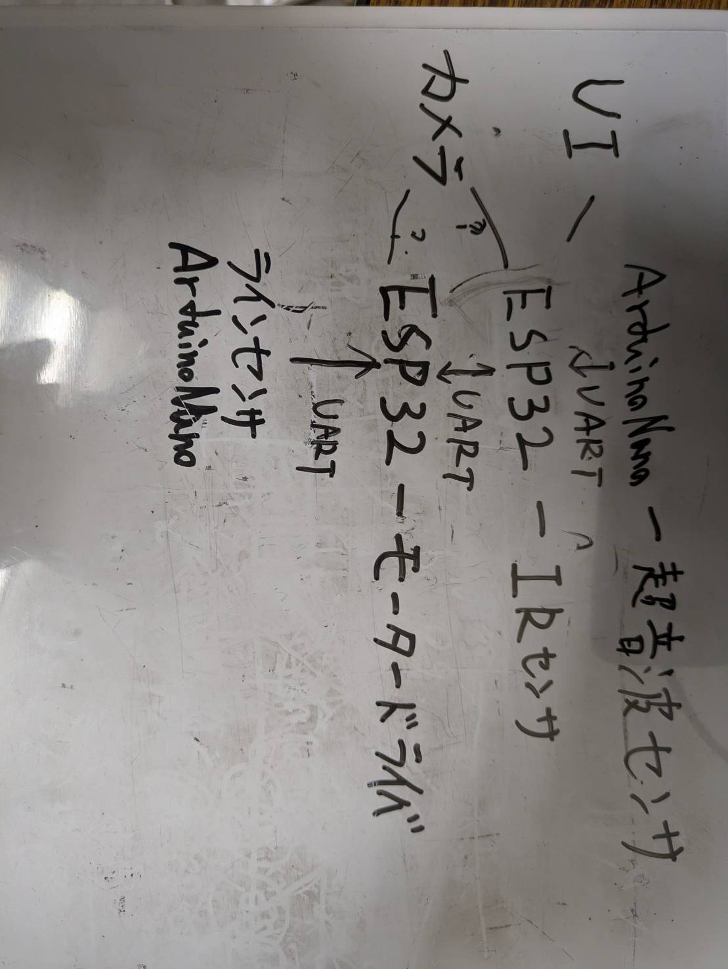
埼玉ブロック/51494.jpg
