Tellurnoid/25RoboCup/埼玉ブロック/51495.jpg

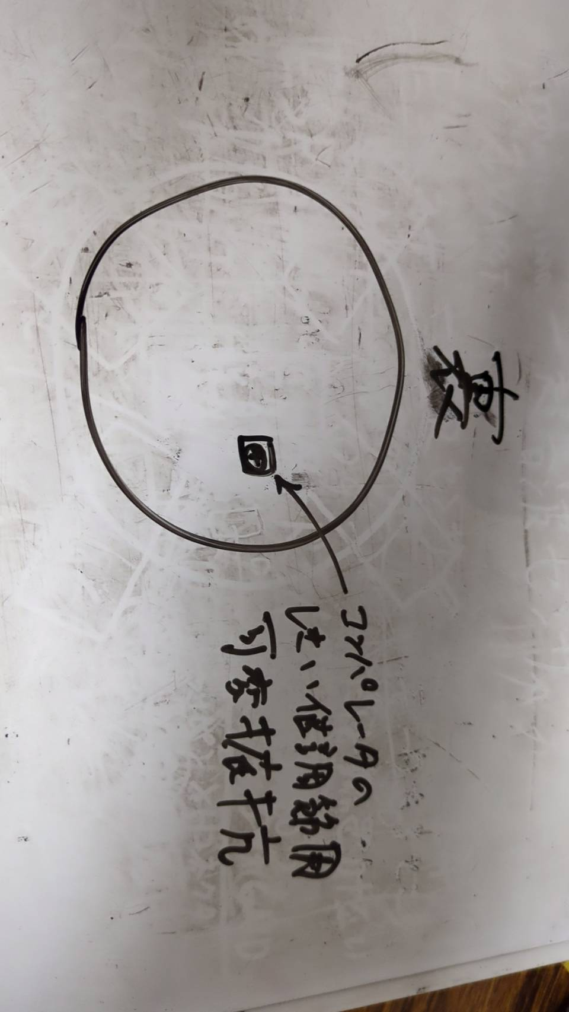
埼玉ブロック/51495.jpg
