Tellurnoid/25RoboCup/埼玉ブロック/51514 (1).jpg

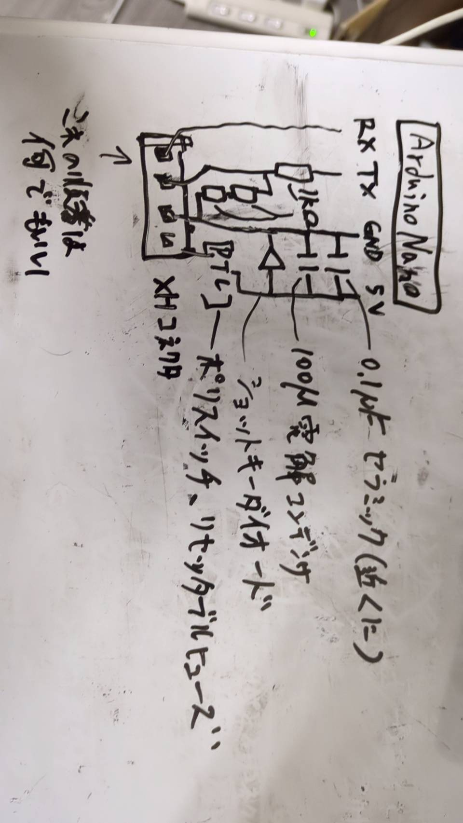
埼玉ブロック/51514 (1).jpg
