Tellurnoid/25RoboCup/埼玉ブロック/ssdUI/2018-10-22_001a.min_.png

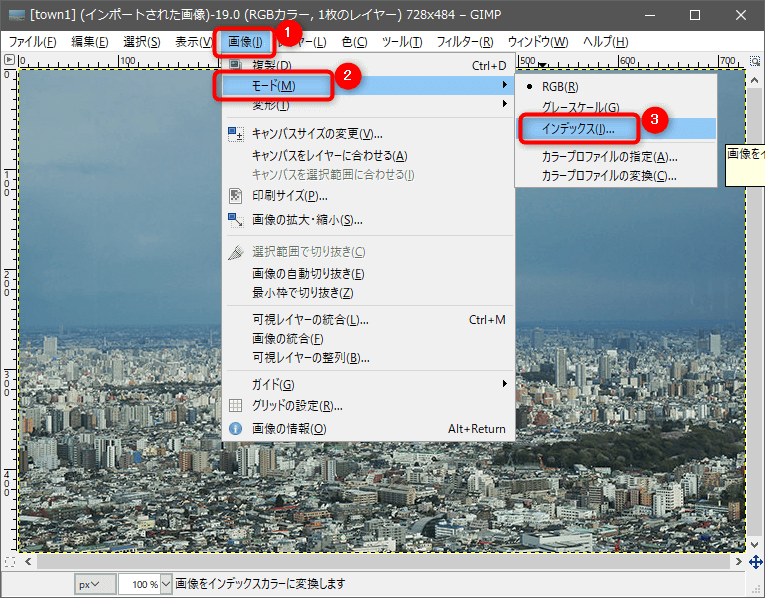
埼玉ブロック/ssdUI/2018-10-22_001a.min_.png
