Tellurnoid/25RoboCup/埼玉ブロック/TC4051制御/Screenshot from 2025-12-24 15-21-51.png

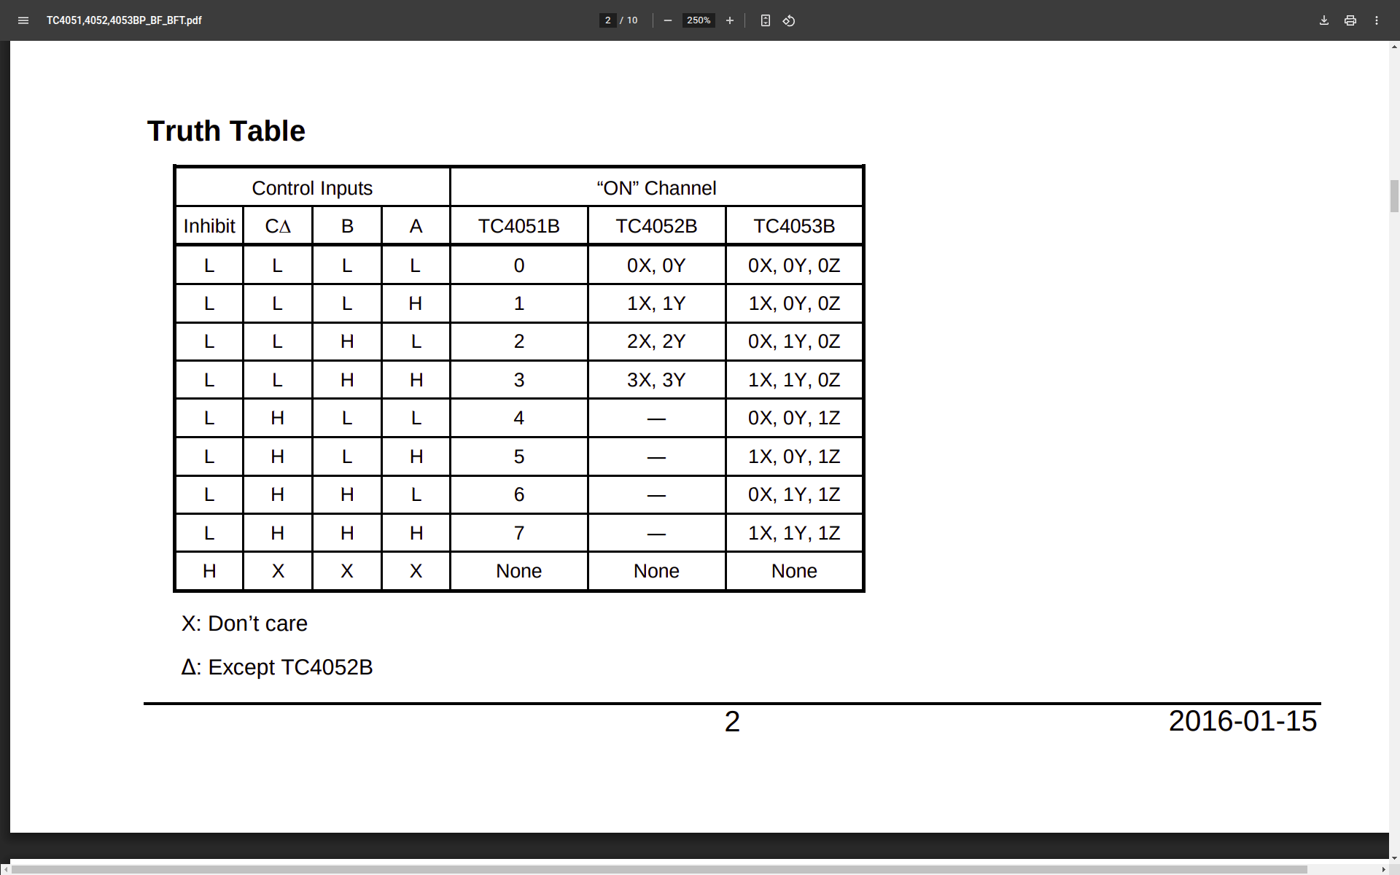
埼玉ブロック/TC4051制御/Screenshot from 2025-12-24 15-21-51.png
