Tellurnoid/25RoboCup/埼玉ブロック/キーパー/しおから氏の記事/Edgeのディフェンス機のソフト紹介｜しおから_files/1734176118-1iTkpXj6fzymtcW5qbYR7Mdu.png

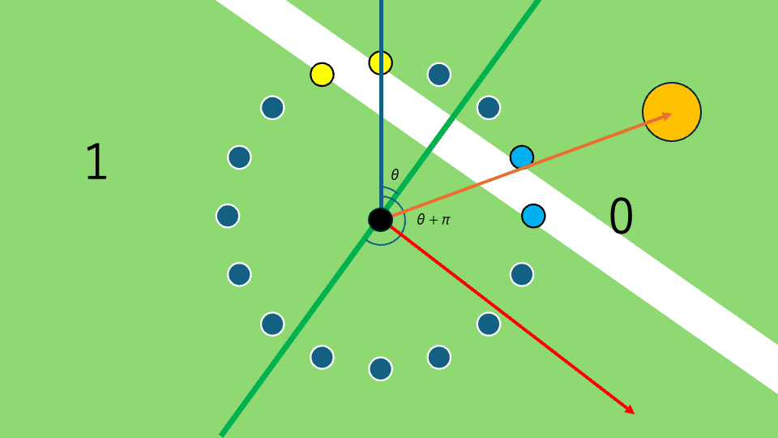
埼玉ブロック/キーパー/しおから氏の記事/Edgeのディフェンス機のソフト紹介｜しおから_files/1734176118-1iTkpXj6fzymtcW5qbYR7Mdu.png
