Tellurnoid/25RoboCup/埼玉ブロック/キーパー/しおから氏の記事/Edgeのディフェンス機のソフト紹介｜しおから_files/1734176568-2QbK7f3JnV8OCP05moUHDSvw.png

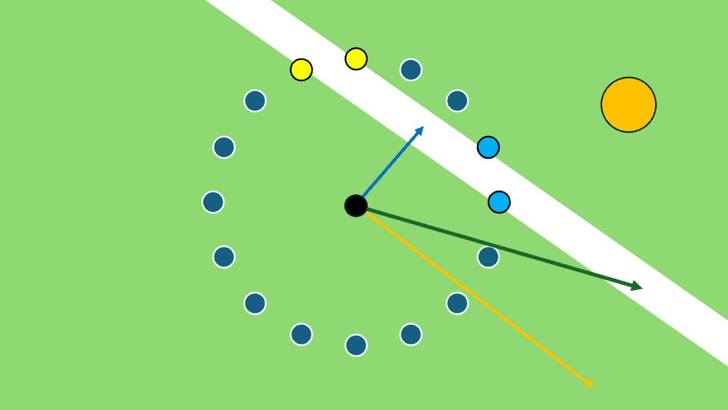
埼玉ブロック/キーパー/しおから氏の記事/Edgeのディフェンス機のソフト紹介｜しおから_files/1734176568-2QbK7f3JnV8OCP05moUHDSvw.png
