Tellurnoid/25RoboCup/埼玉ブロック/キーパー/しおから氏の記事/Edgeのディフェンス機のソフト紹介｜しおから_files/profile_7ff0f9a1336d27115153f0905f6051db(1).png

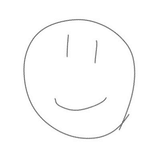
埼玉ブロック/キーパー/しおから氏の記事/Edgeのディフェンス機のソフト紹介｜しおから_files/profile_7ff0f9a1336d27115153f0905f6051db(1).png
