Tellurnoid/25RoboCup/埼玉ブロック/キーパー/しおから氏の記事/Edgeのディフェンス機のソフト紹介｜しおから_files/rectangle_large_type_2_fc4babe797c32c335dc2e4a10a33fd3a.jpeg

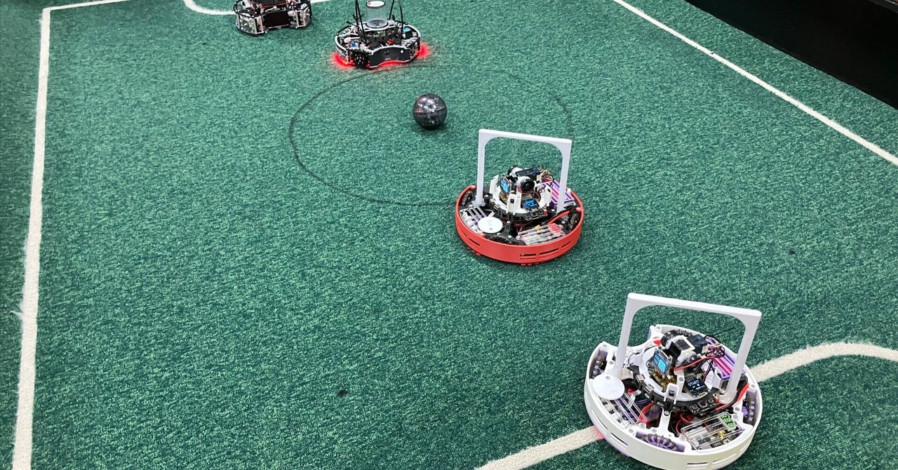
埼玉ブロック/キーパー/しおから氏の記事/Edgeのディフェンス機のソフト紹介｜しおから_files/rectangle_large_type_2_fc4babe797c32c335dc2e4a10a33fd3a.jpeg
