Tellurnoid/25RoboCup/埼玉ブロック/スクショ/Screenshot from 2025-12-18 15-38-29.png

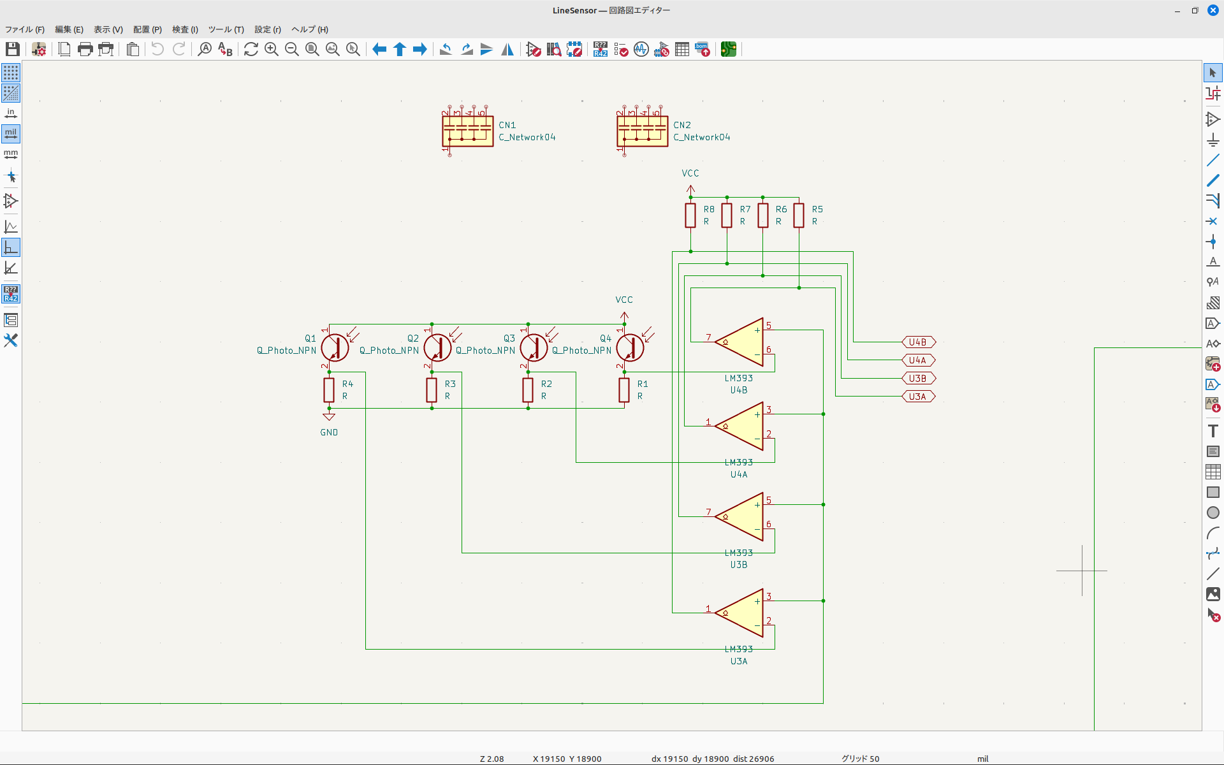
埼玉ブロック/スクショ/Screenshot from 2025-12-18 15-38-29.png
