Tellurnoid/25RoboCup/埼玉ブロック/スクショ/Screenshot from 2025-12-18 18-56-48.png

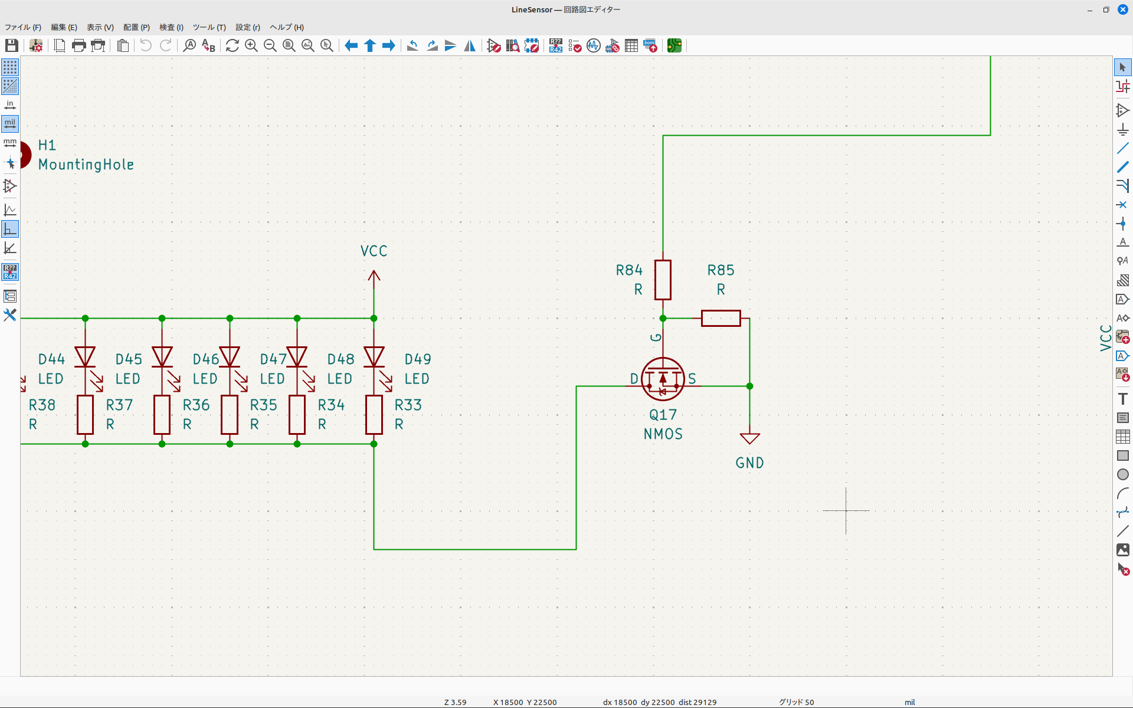
埼玉ブロック/スクショ/Screenshot from 2025-12-18 18-56-48.png
