Tellurnoid/25RoboCup/埼玉ブロック/スクショ/Screenshot from 2025-12-18 19-45-21.png

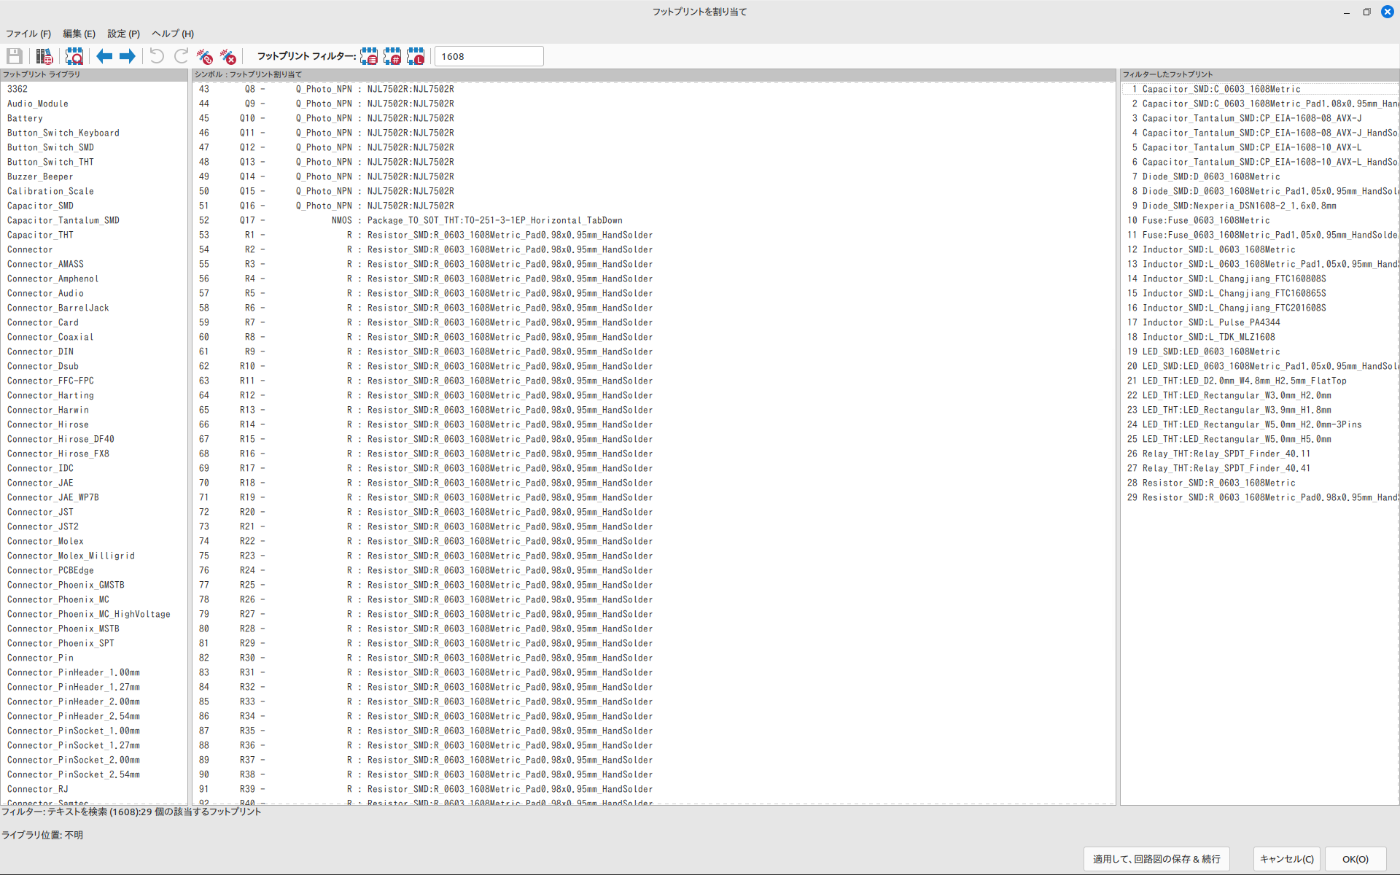
埼玉ブロック/スクショ/Screenshot from 2025-12-18 19-45-21.png
