Tellurnoid/25RoboCup/埼玉ブロック/スクショ/Screenshot from 2025-12-19 16-30-56.png

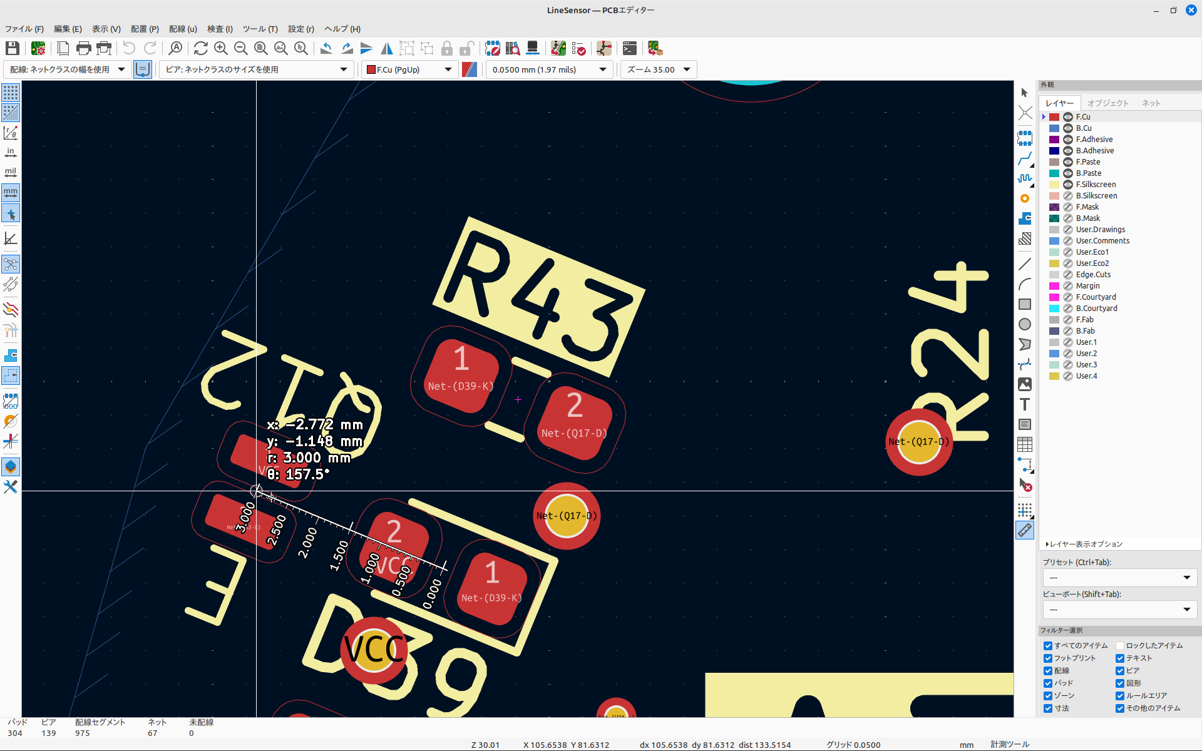
埼玉ブロック/スクショ/Screenshot from 2025-12-19 16-30-56.png
