Tellurnoid/25RoboCup/埼玉ブロック/スクショ/Screenshot from 2025-12-24 12-10-15.png

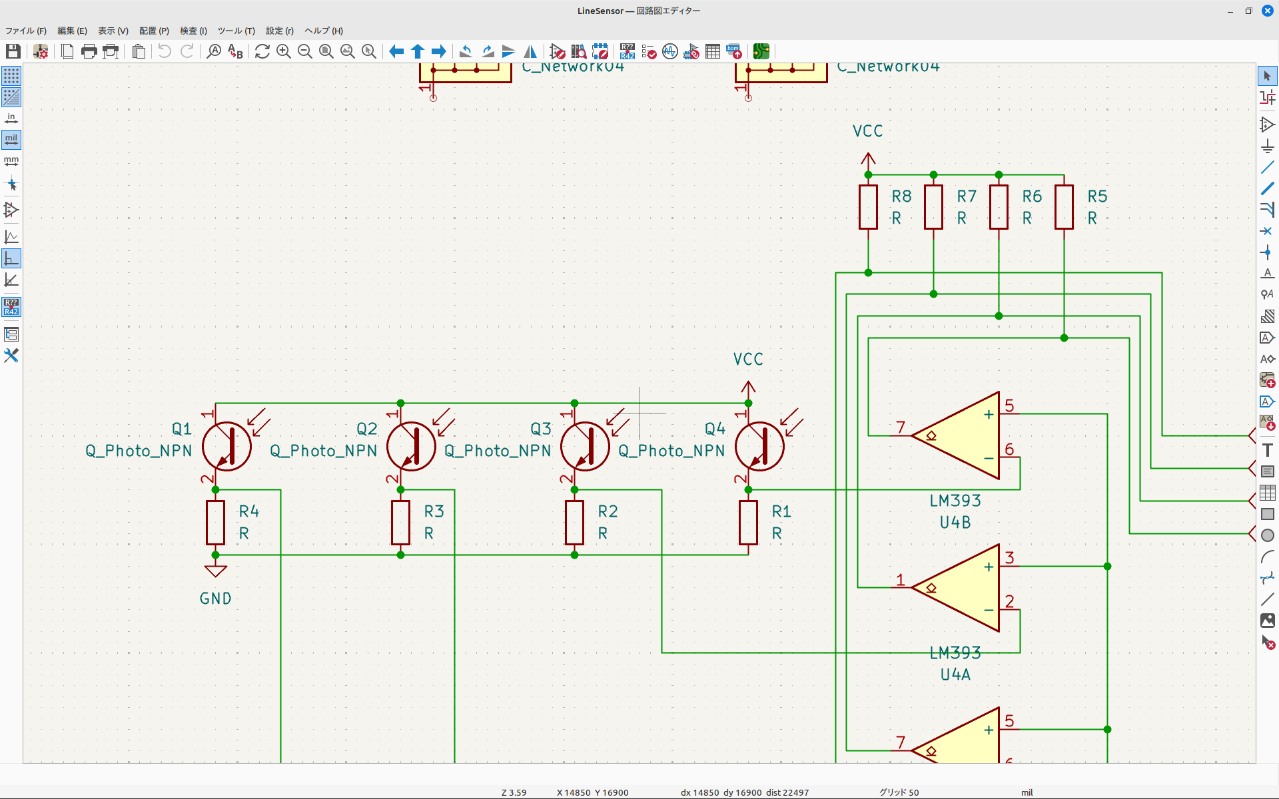
埼玉ブロック/スクショ/Screenshot from 2025-12-24 12-10-15.png
