Tellurnoid/25RoboCup/埼玉ブロック/スクショ/Screenshot from 2025-12-25 21-30-08.png

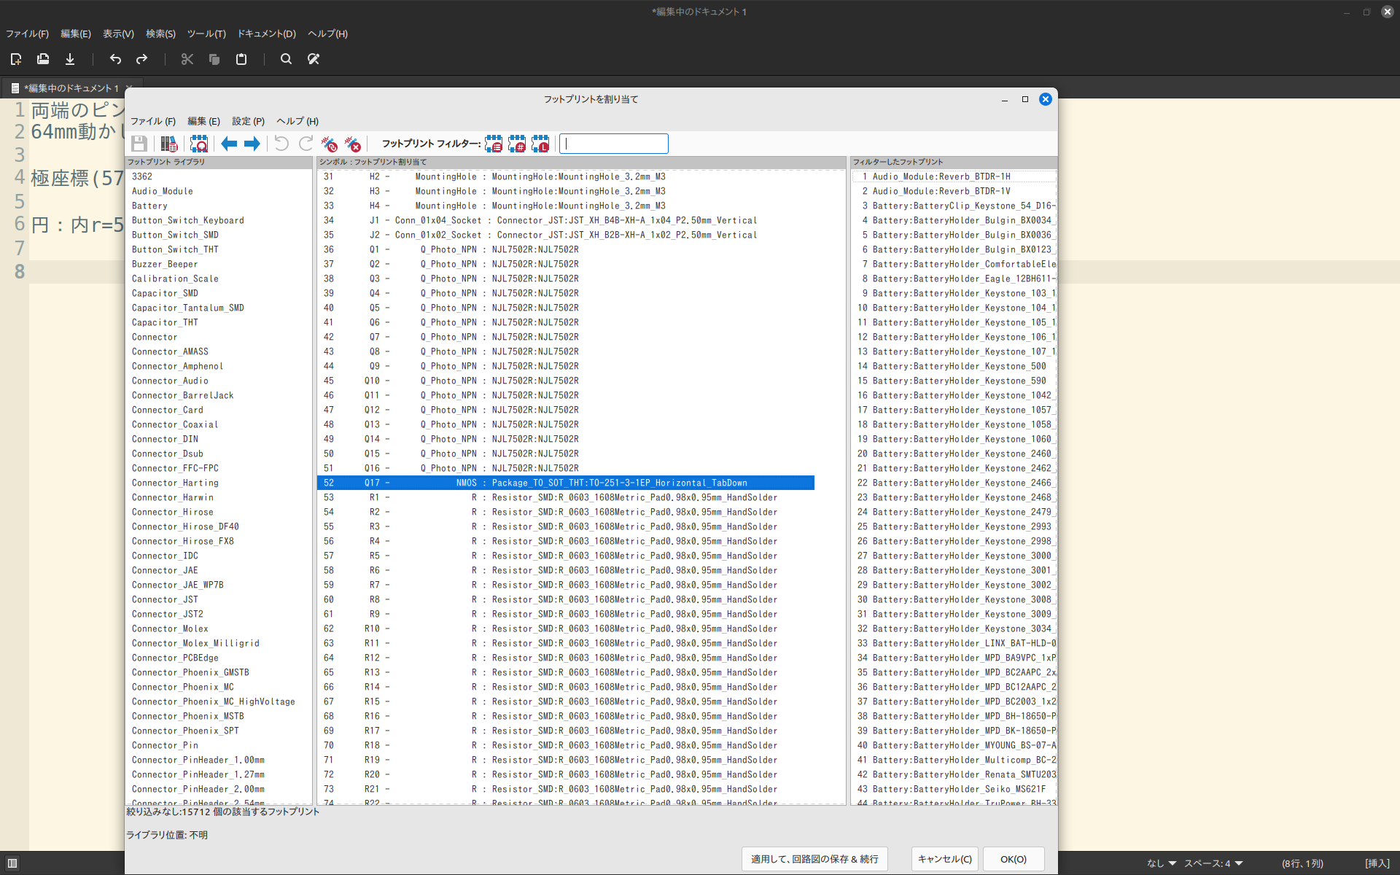
埼玉ブロック/スクショ/Screenshot from 2025-12-25 21-30-08.png
