Tellurnoid/25RoboCup/KiCad/Main_RCJ_Japan_prot2_with_kickBoard/KickBoard.dxf

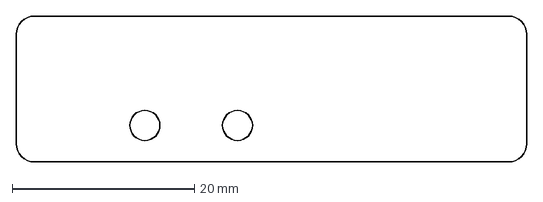
[picture p69: CAD file, 2026-03-05]
KiCad/Main_RCJ_Japan_prot2_with_kickBoard/KickBoard.dxf
56.0 x 16.0 mm
