Tellurnoid/25RoboCup/KiCad/NOT USED/matudachi_motor_prot1/v2_MotorDriver/v2_MotorDriver/Kiban_deka_right.dxf

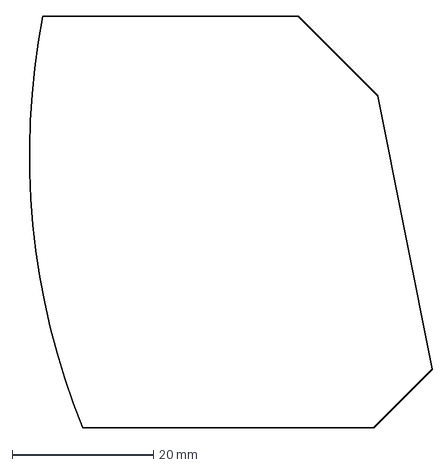
[picture p70: CAD file, 2026-01-30]
KiCad/NOT USED/matudachi_motor_prot1/v2_MotorDriver/v2_MotorDriver/Kiban_deka_right.dxf
59.0 x 58.3 mm
