Tellurnoid/25RoboCup/埼玉ブロック/kiCad/MotorDriver_Marudachi/MotorDriver/MotorDriver/MotorDriver.step

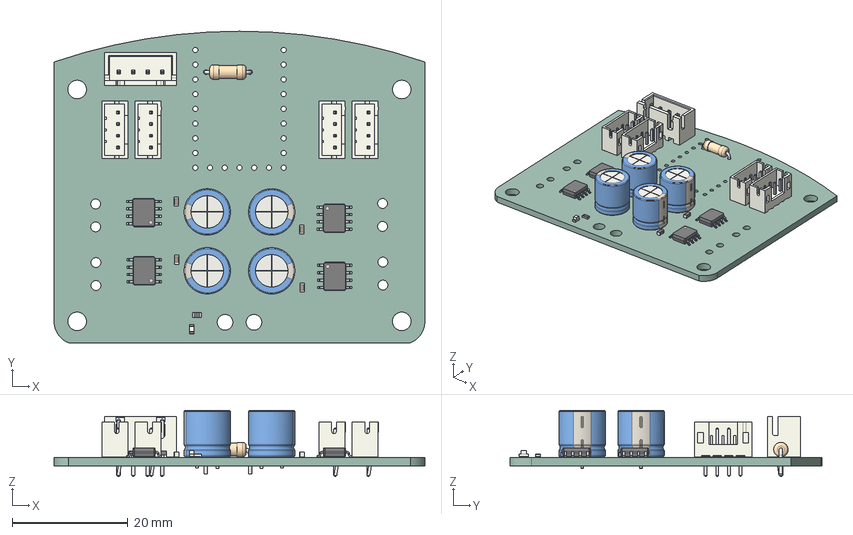
[picture p71: CAD file, 2025-12-26]
埼玉ブロック/kiCad/MotorDriver_Marudachi/MotorDriver/MotorDriver/MotorDriver.step
64.0 x 53.8 x 11.4 mm
CP_Radial_D8.0mm_P3.50mm x 4
C_0603_1608Metric x 4
JST_XH_B4B-XH-A_1x04_P2.50mm_Vertical
SOIC-8-1EP_3.9x4.9mm_P1.27mm_EP2.29x3mm x 4
R_0603_1608Metric
JST_PH_B4B-PH-K_1x04_P2.00mm_Vertical x 4
LED_0603_1608Metric
R_Axial_DIN0207_L6.3mm_D2.5mm_P7.62mm_Horizontal
MotorDriver_PCB
