Tellurnoid/25RoboCup/埼玉ブロック/RP2040_UART_TESTS/withPIO/UART_RP2040/build/picotool/tmp/picotoolBuild-cfgcmd.txt

cmd='/usr/bin/cmake;--no-warn-unused-cli;-DCMAKE_MAKE_PROGRAM:FILEPATH=/usr/bin/gmake;-DPICO_SDK_PATH:FILEPATH=/home/carbonoid/25RoboCup/RP2040_UART_TESTS/withPIO/pico-sdk/pico-sdk;-DPICOTOOL_NO_LIBUSB=1;-DPICOTOOL_FLAT_INSTALL=1;-DCMAKE_INSTALL_PREFIX=/home/carbonoid/25RoboCup/RP2040_UART_TESTS/withPIO/UART_RP2040/build/_deps;-DCMAKE_RULE_MESSAGES=OFF;-DCMAKE_INSTALL_MESSAGE=NEVER;-GUnix Makefiles;<SOURCE_DIR><SOURCE_SUBDIR>'
