Tellurnoid/25RoboCup/埼玉ブロック/RP2040_UART_TESTS/withPIO/UART_RP2040/build/picotool/src/picotoolBuild-stamp/picotoolBuild-source_dirinfo.txt

# This is a generated file and its contents are an internal implementation detail.
# The download step will be re-executed if anything in this file changes.
# No other meaning or use of this file is supported.

method=source_dir
command=
source_dir=/home/carbonoid/25RoboCup/RP2040_UART_TESTS/withPIO/UART_RP2040/build/_deps/picotool-src
work_dir=
