Tellurnoid/25RoboCup/埼玉ブロック/RP2040_UART_TESTS/withPIO/UART_RP2040/build/_deps/picotool-subbuild/picotool-populate-prefix/src/picotool-populate-stamp/picotool-populate-gitinfo.txt

# This is a generated file and its contents are an internal implementation detail.
# The download step will be re-executed if anything in this file changes.
# No other meaning or use of this file is supported.

method=git
command=/usr/bin/cmake;-P;/home/carbonoid/25RoboCup/RP2040_UART_TESTS/withPIO/UART_RP2040/build/_deps/picotool-subbuild/picotool-populate-prefix/tmp/picotool-populate-gitclone.cmake
source_dir=/home/carbonoid/25RoboCup/RP2040_UART_TESTS/withPIO/UART_RP2040/build/_deps/picotool-src
work_dir=/home/carbonoid/25RoboCup/RP2040_UART_TESTS/withPIO/UART_RP2040/build/_deps
repository=https://github.com/raspberrypi/picotool.git
remote=origin
init_submodules=TRUE
recurse_submodules=--recursive
submodules=
CMP0097=NEW
