Tellurnoid/25RoboCup/埼玉ブロック/RP2040_UART_TESTS/withPIO/UART_RP2040/build/pico-sdk/src/rp2_common/pico_cyw43_driver/pioasm/tmp/pioasmBuild-cfgcmd.txt

cmd='/usr/bin/cmake;--no-warn-unused-cli;-DCMAKE_MAKE_PROGRAM:FILEPATH=/usr/bin/gmake;-DPIOASM_FLAT_INSTALL=1;-DCMAKE_INSTALL_PREFIX=/home/carbonoid/25RoboCup/RP2040_UART_TESTS/withPIO/UART_RP2040/build/pioasm-install;-DCMAKE_RULE_MESSAGES=OFF;-DCMAKE_INSTALL_MESSAGE=NEVER;-GUnix Makefiles;-C<TMP_DIR>/pioasmBuild-cache-$<CONFIG>.cmake;<SOURCE_DIR><SOURCE_SUBDIR>'
