Tellurnoid/25RoboCup/北埼玉ノード/kiCad/回路9.28-1.pdf

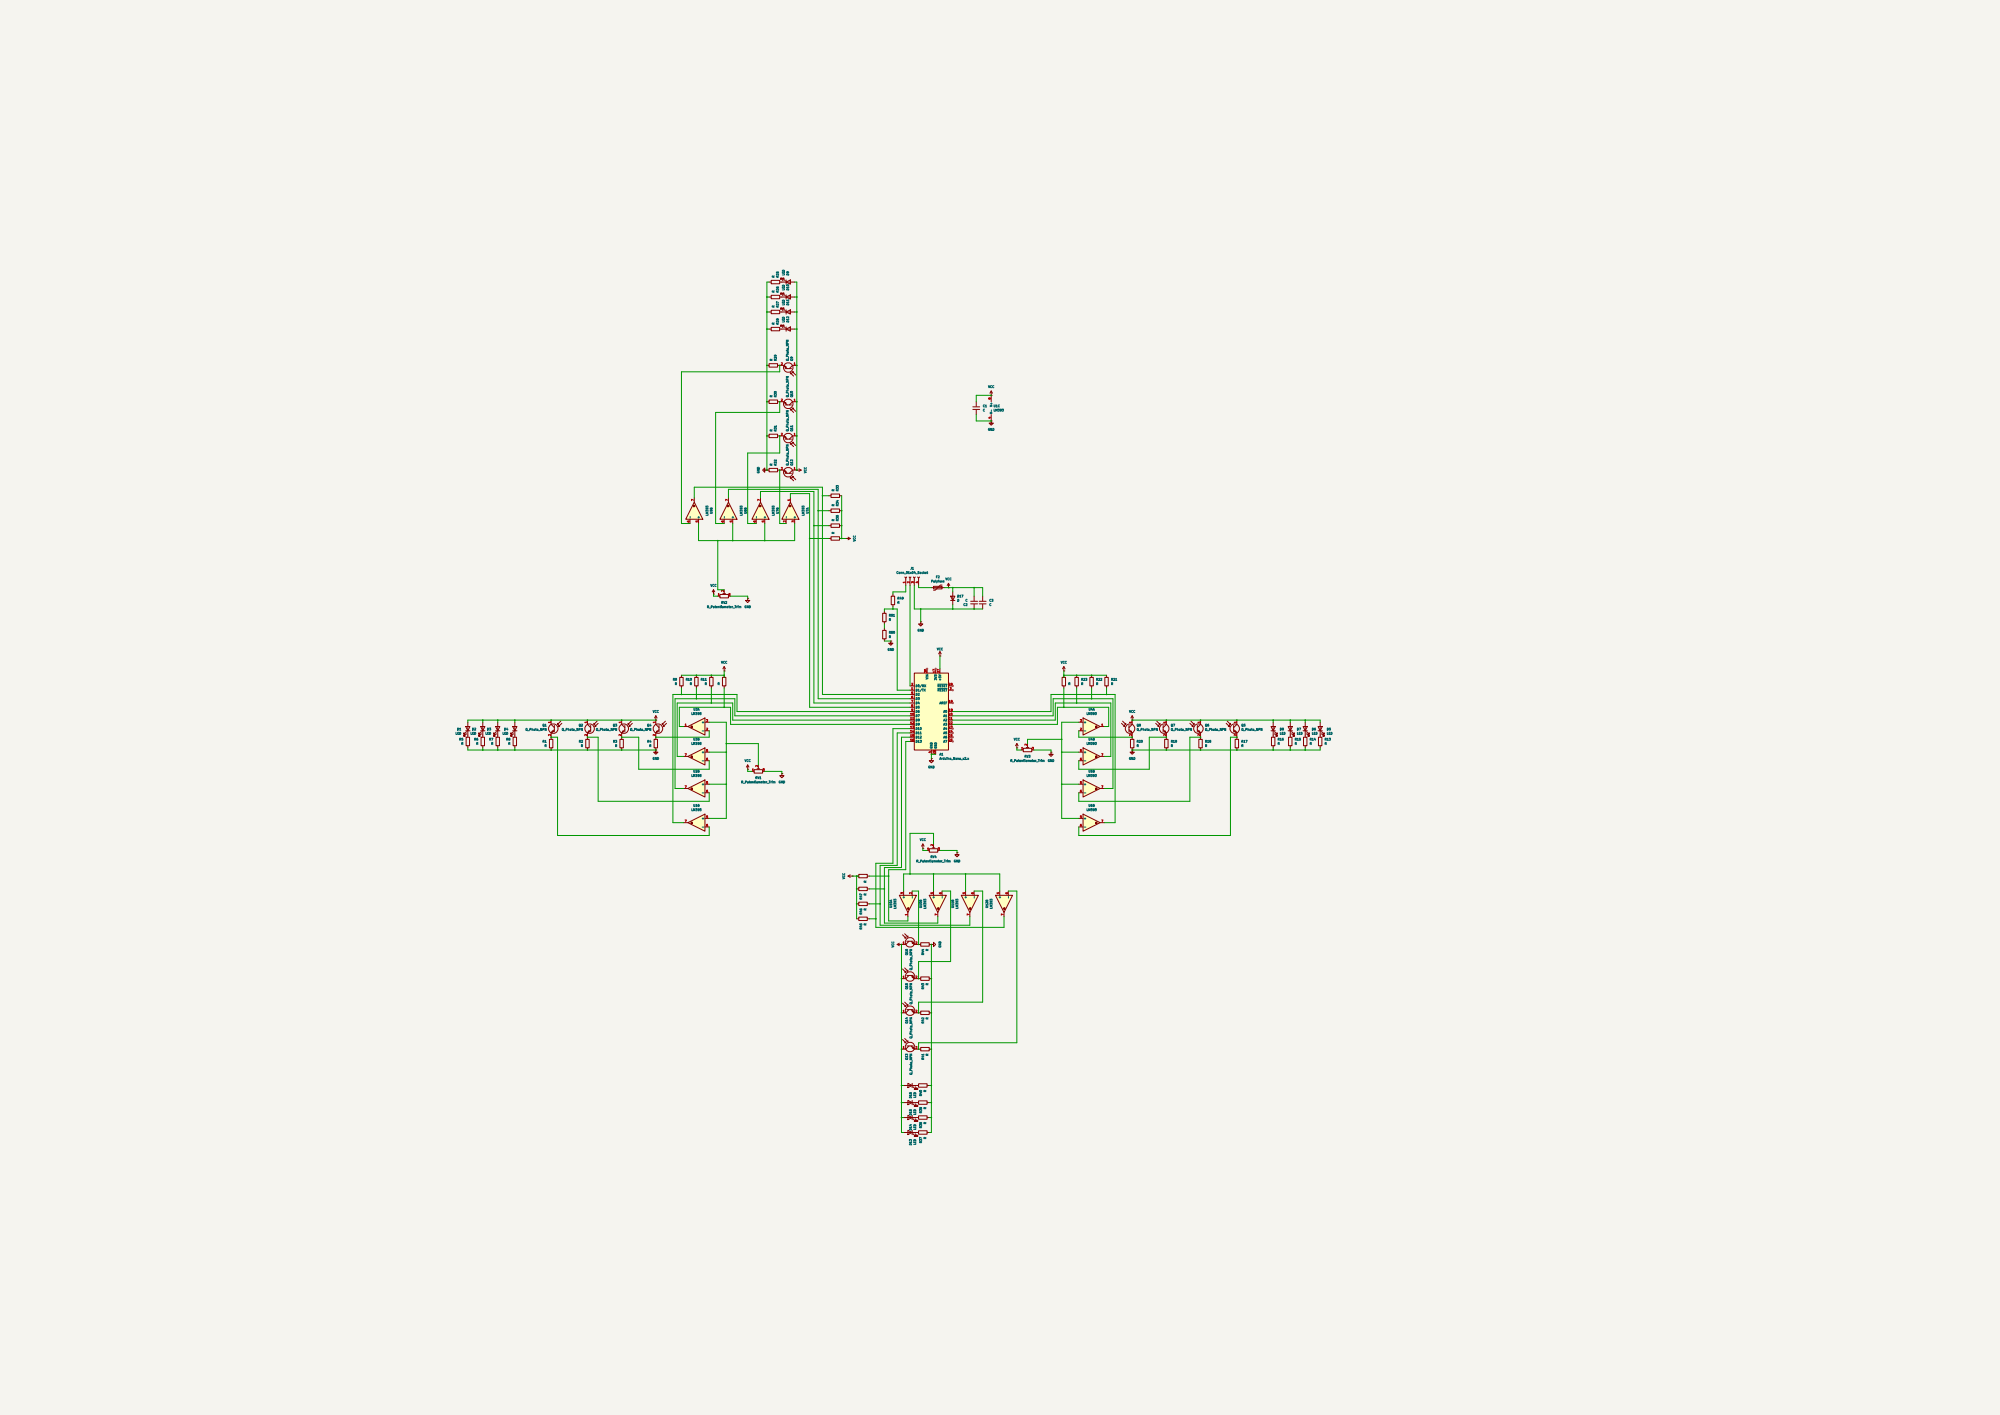
[picture p72: page 1]
