Tellurnoid/25RoboCup/KiCad/tachanka_Power_prot1/RCJ_Power_ai/RCJ_Power-B_Cu.pdf

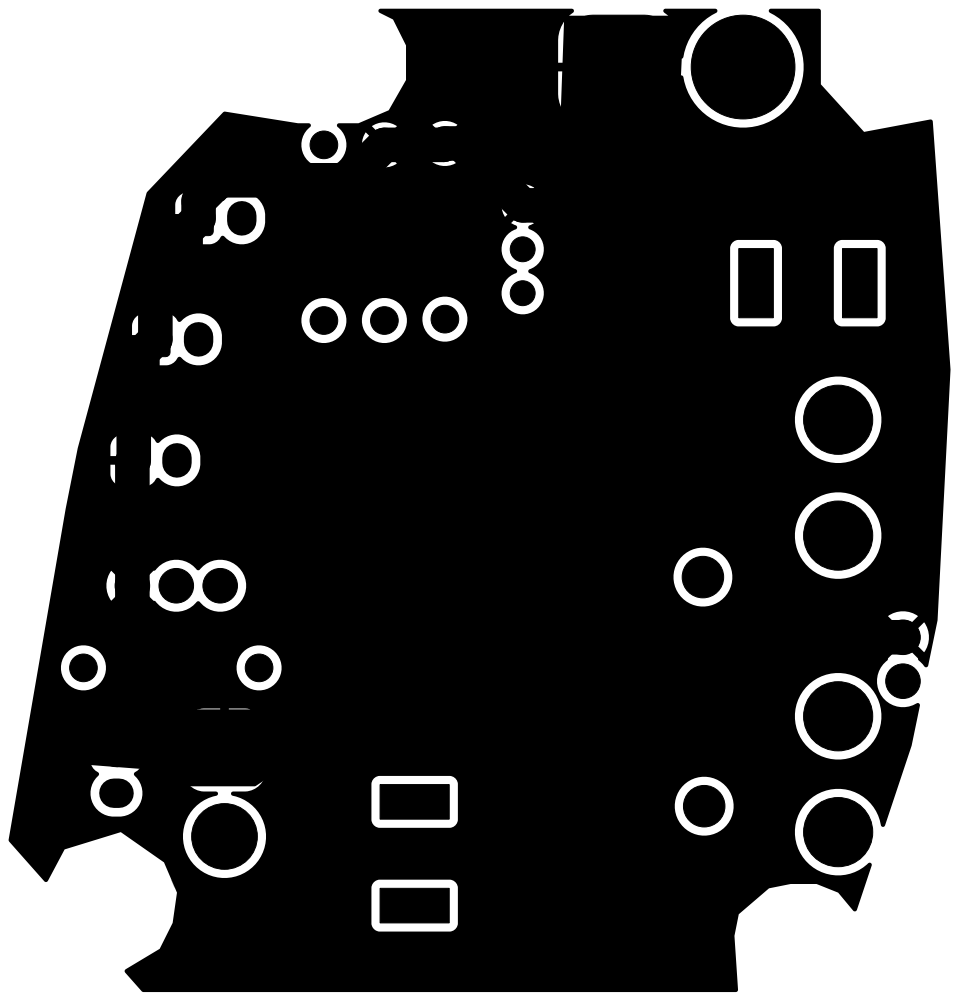
[picture p73: page 1]
