Tellurnoid/25RoboCup/KiCad/tachanka_Power_prot1/RCJ_Power_ai/RCJ_Power-B_Mask.pdf

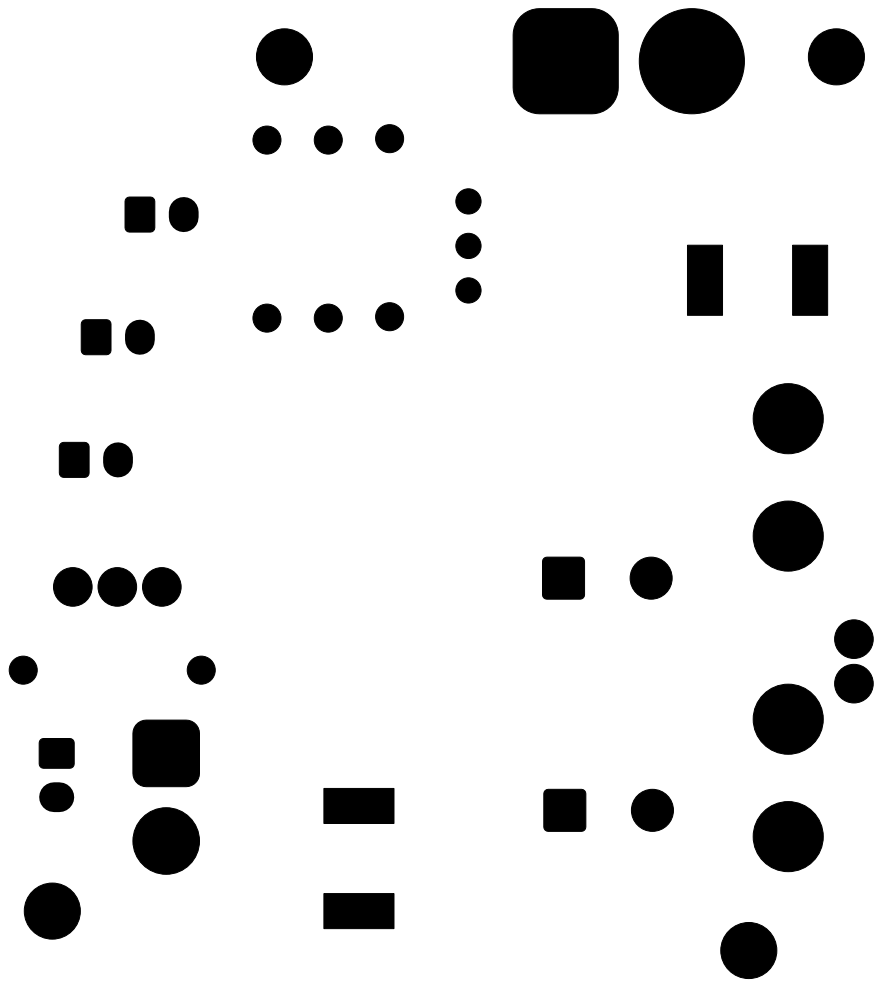
[picture p74: page 1]
