Tellurnoid/25RoboCup/KiCad/tachanka_Power_prot1/RCJ_Power_ai/RCJ_Power-F_Cu.pdf

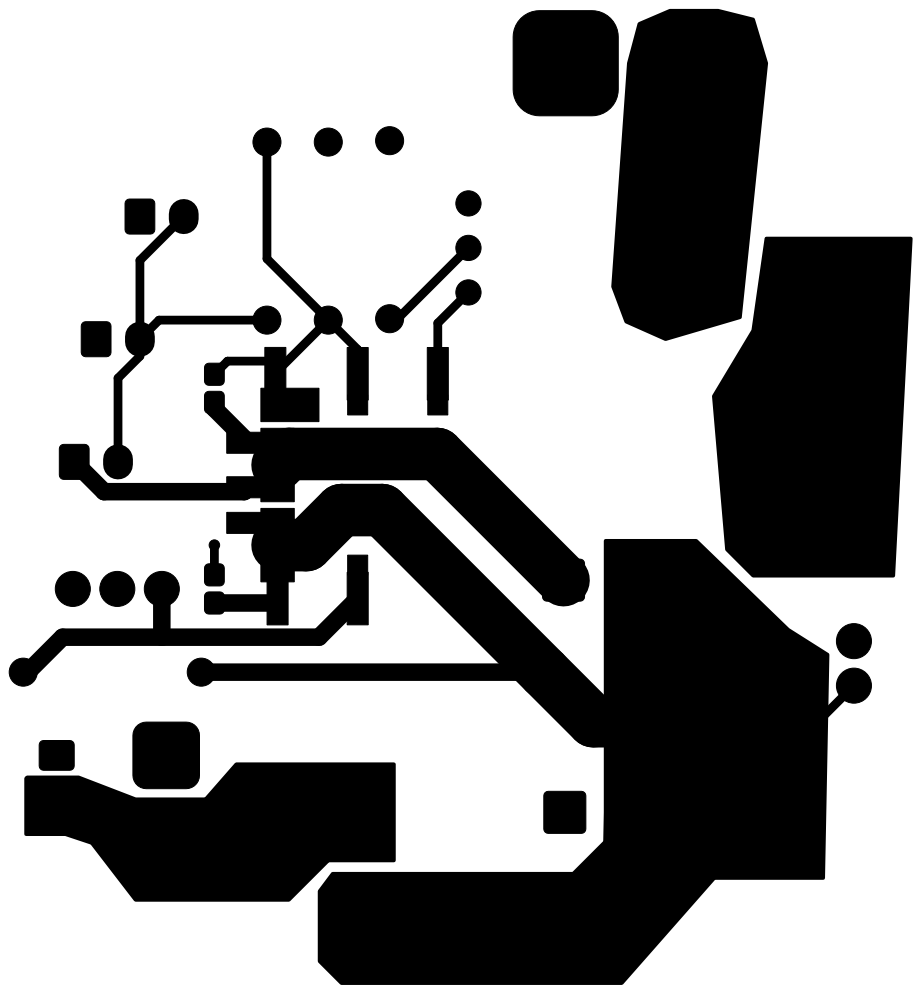
[picture p75: page 1]
