Tellurnoid/25RoboCup/KiCad/tachanka_Power_prot1/RCJ_Power_ai/RCJ_Power-F_Mask.pdf

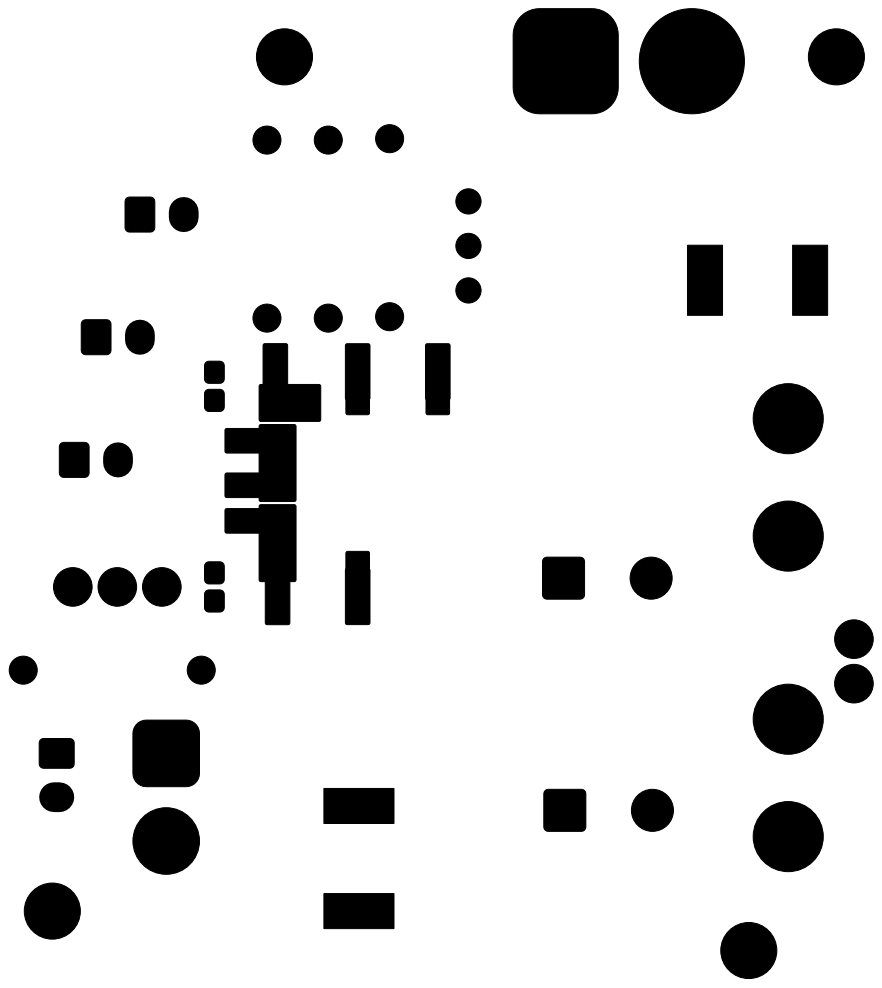
[picture p76: page 1]
