Tellurnoid/25RoboCup/KiCad/tachanka_Power_prot1/RCJ_Power_ai/RCJ_Power-F_Paste.pdf

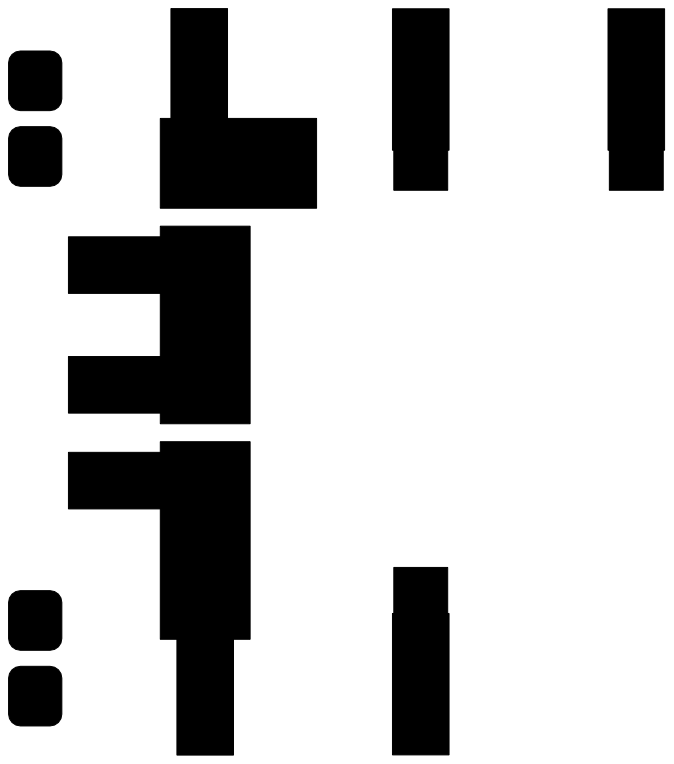
[picture p77: page 1]
