Tellurnoid/25RoboCup/KiCad/tachanka_Power_prot1/RCJ_Power_ai/RCJ_Power-F_Silkscreen.pdf

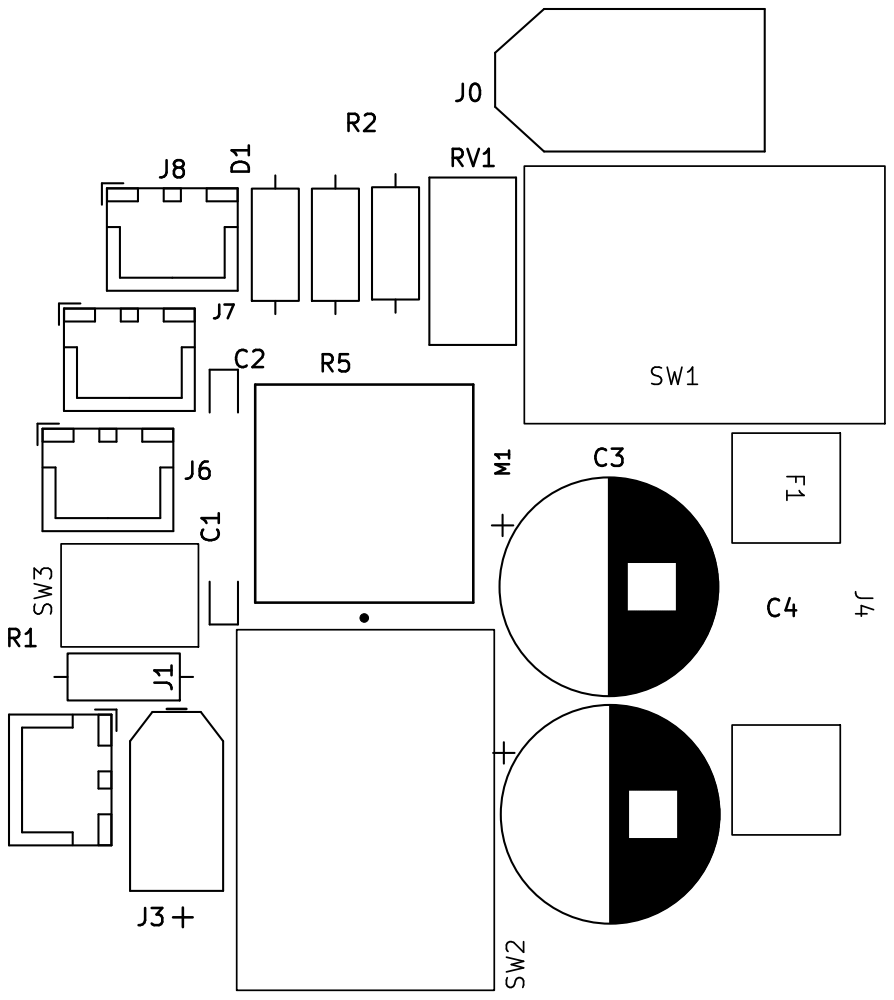
[picture p78: page 1]
