Tellurnoid/25RoboCup/KiCad/Main_RCJ_Japan_prot2_with_kickBoard/Main_RCJ_Japan_prot2_with_kickBoard.kicad_pcb

## KiCad design KiCad/Main_RCJ_Japan_prot2_with_kickBoard/Main_RCJ_Japan_prot2_with_kickBoard.kicad_pcb (2026-03-05)

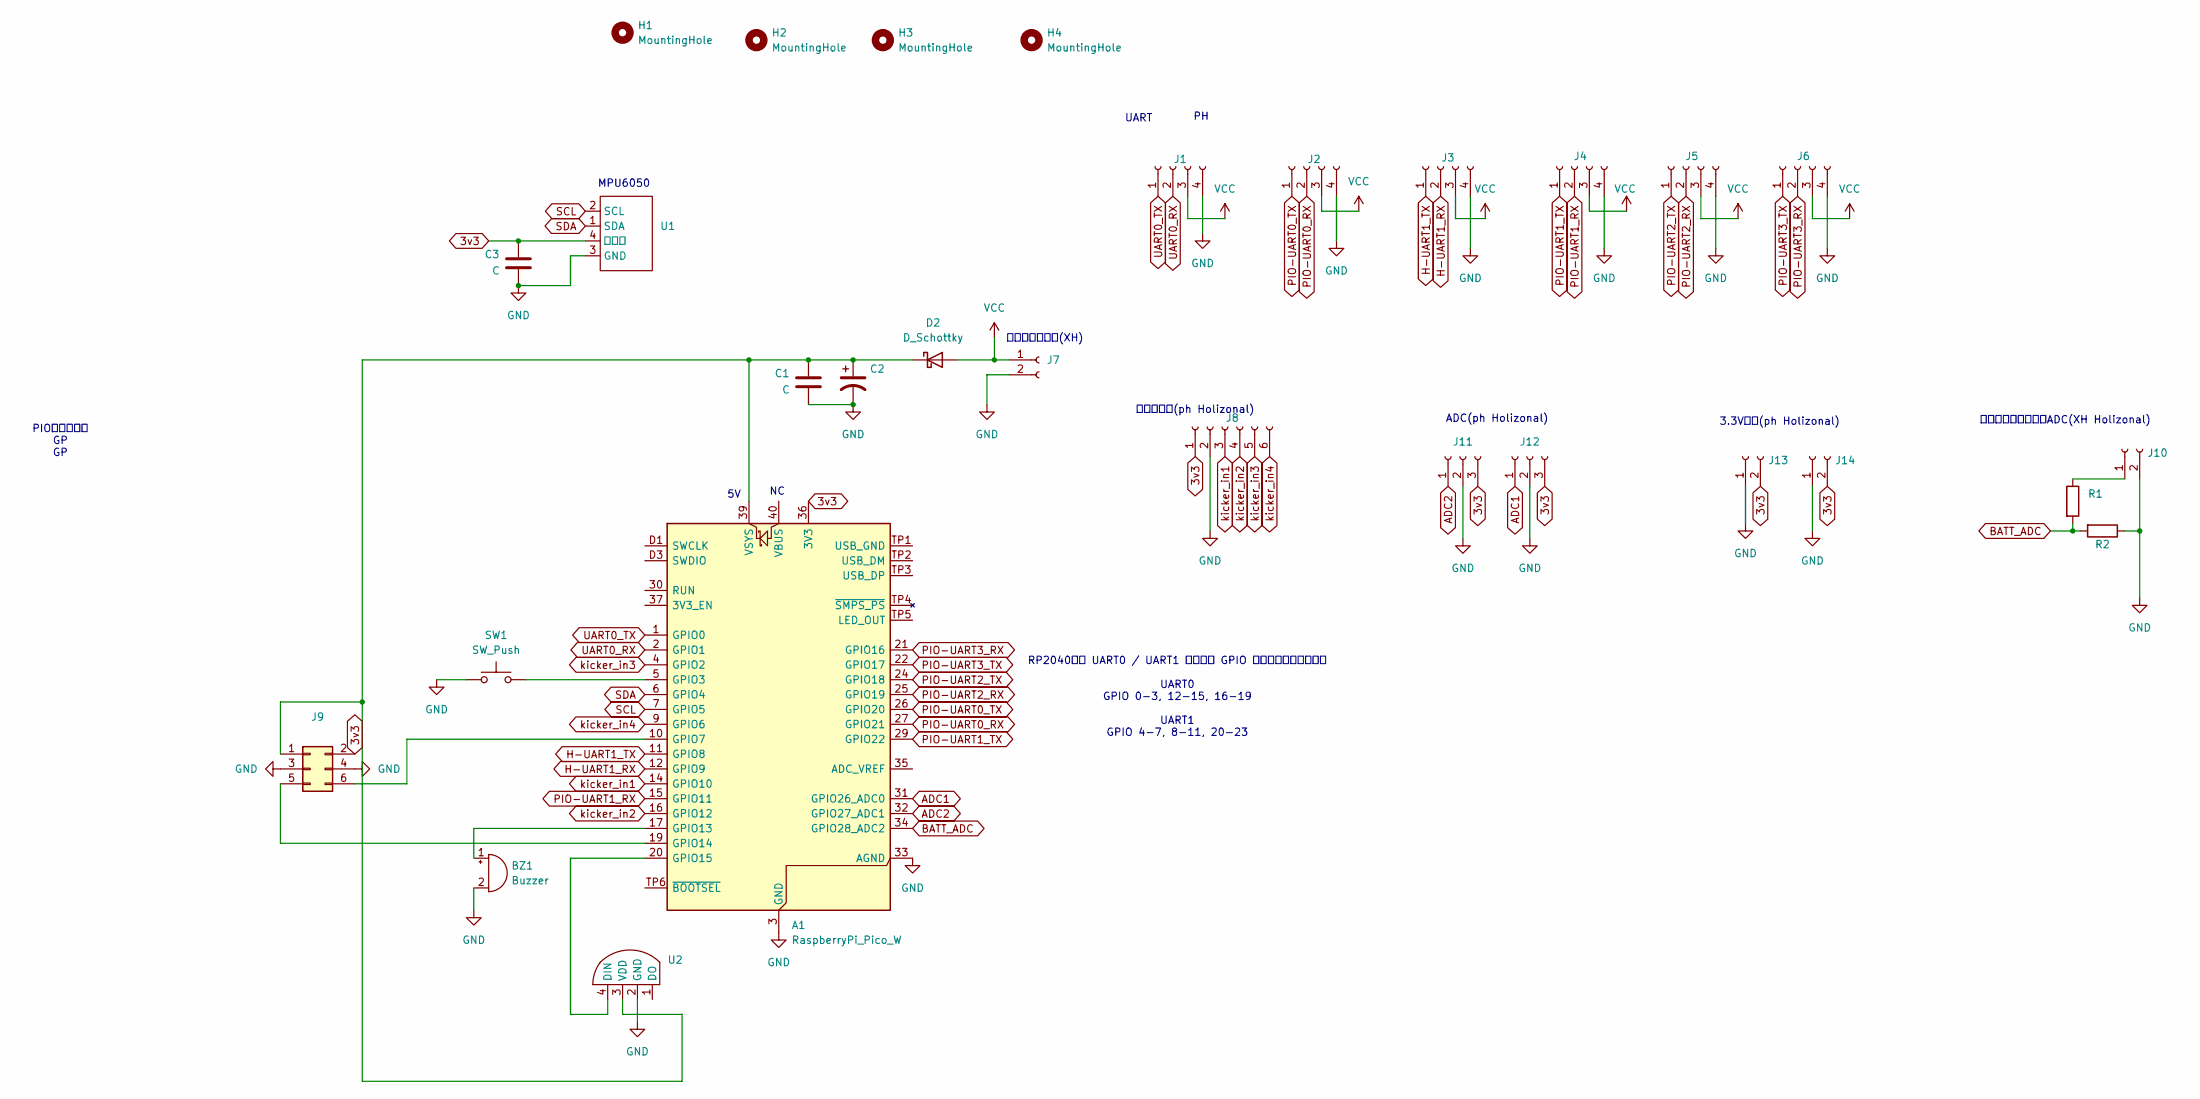
[picture p79: schematic Main_RCJ_Japan_prot2_with_kickBoard.kicad_sch]

Parts:
A1: RaspberryPi_Pico_W; RaspberryPi_Pico_Common_Unspecified
BZ1: Buzzer; Buzzer_12x9.5RM7.6
C1, C3: C; C_0603_1608Metric_Pad1.08x0.95mm_HandSolder
C2: C_Polarized_US; CP_Radial_D8.0mm_P3.50mm
D2: D_Schottky; D_SOD-123
H1, H2, H3, H4: MountingHole; MountingHole_3.2mm_M3
J1, J2: Conn_01x04_Socket; JST_PH_S4B-PH-K_1x04_P2.00mm_Horizontal
J3, J4, J5, J6: Conn_01x04_Socket; JST_PH_B4B-PH-K_1x04_P2.00mm_Vertical
J7, J10: Conn_01x02_Socket; JST_XH_S2B-XH-A_1x02_P2.50mm_Horizontal
J8: Conn_01x06_Socket; JST_PH_S6B-PH-K_1x06_P2.00mm_Horizontal
J9: Conn_02x03_Odd_Even; PinHeader_2x03_P2.54mm_Vertical
J11, J12: Conn_01x03_Socket; JST_PH_B3B-PH-K_1x03_P2.00mm_Vertical
J13, J14: Conn_01x02_Socket; JST_PH_B2B-PH-K_1x02_P2.00mm_Vertical
R1, R2: R; R_Axial_DIN0309_L9.0mm_D3.2mm_P12.70mm_Horizontal
SW1: SW_Push; SW_PUSH_6mm
U1, U2: 名称未設定

Connections:
3v3: A1.36 (3V3), C3.1, J8.1, J9.2, J11.3, J12.3, J13.2, J14.2, U1.4 (３ｖ３)
ADC1: A1.31 (GPIO26_ADC0), J12.1
ADC2: A1.32 (GPIO27_ADC1), J11.1
BATT_ADC: A1.34 (GPIO28_ADC2), R1.2, R2.2
GND: A1.3 (GND), A1.8 (GND), A1.13 (GND), A1.18 (GND), A1.23 (GND), A1.28 (GND), A1.33 (AGND), A1.38 (GND), A1.D2 (GND), BZ1.2 (-), C1.2, C2.2, C3.2, J1.4, J2.4, J3.4, J4.4, J5.4, J6.4, J7.2, J8.2, J9.3, J9.4, J10.2, J11.2, J12.2, J13.1, J14.1, R2.1, SW1.1, U1.3 (GND), U2.2 (GND)
H-UART1_RX: A1.12 (GPIO9), J3.2
H-UART1_TX: A1.11 (GPIO8), J3.1
unnamed: A1.5 (GPIO3), SW1.2
unnamed: A1.10 (GPIO7), J9.6
unnamed: A1.17 (GPIO13), BZ1.1 (+)
unnamed: A1.19 (GPIO14), J9.5
unnamed: A1.20 (GPIO15), U2.4 (DIN)
unnamed: A1.39 (VSYS), C1.1, C2.1, D2.1 (K), J9.1, U2.3 (VDD)
unnamed: J10.1, R1.1
PIO-UART0_RX: A1.27 (GPIO21), J2.2
PIO-UART0_TX: A1.26 (GPIO20), J2.1
PIO-UART1_RX: A1.15 (GPIO11), J4.2
PIO-UART1_TX: A1.29 (GPIO22), J4.1
PIO-UART2_RX: A1.25 (GPIO19), J5.2
PIO-UART2_TX: A1.24 (GPIO18), J5.1
PIO-UART3_RX: A1.21 (GPIO16), J6.2
PIO-UART3_TX: A1.22 (GPIO17), J6.1
SCL: A1.7 (GPIO5), U1.2 (SCL)
SDA: A1.6 (GPIO4), U1.1 (SDA)
UART0_RX: A1.2 (GPIO1), J1.2
UART0_TX: A1.1 (GPIO0), J1.1
VCC: D2.2 (A), J1.3, J2.3, J3.3, J4.3, J5.3, J6.3, J7.1
kicker_in1: A1.14 (GPIO10), J8.3
kicker_in2: A1.16 (GPIO12), J8.4
kicker_in3: A1.4 (GPIO2), J8.5
kicker_in4: A1.9 (GPIO6), J8.6

Notes on the sheet:
メイン電源入力(XH)
キッカー用(ph Holizonal)
PIO避けるべき GP GP
3.3V供給(ph Holizonal)
ADC(ph Holizonal)
UART
バッテリー電圧測定ADC(XH Holizonal)
RP2040では UART0 / UART1 を以下の GPIO に割り当て可能です： UART0 GPIO 0-3, 12-15, 16-19 UART1 GPIO 4-7, 8-11, 20-23
MPU6050

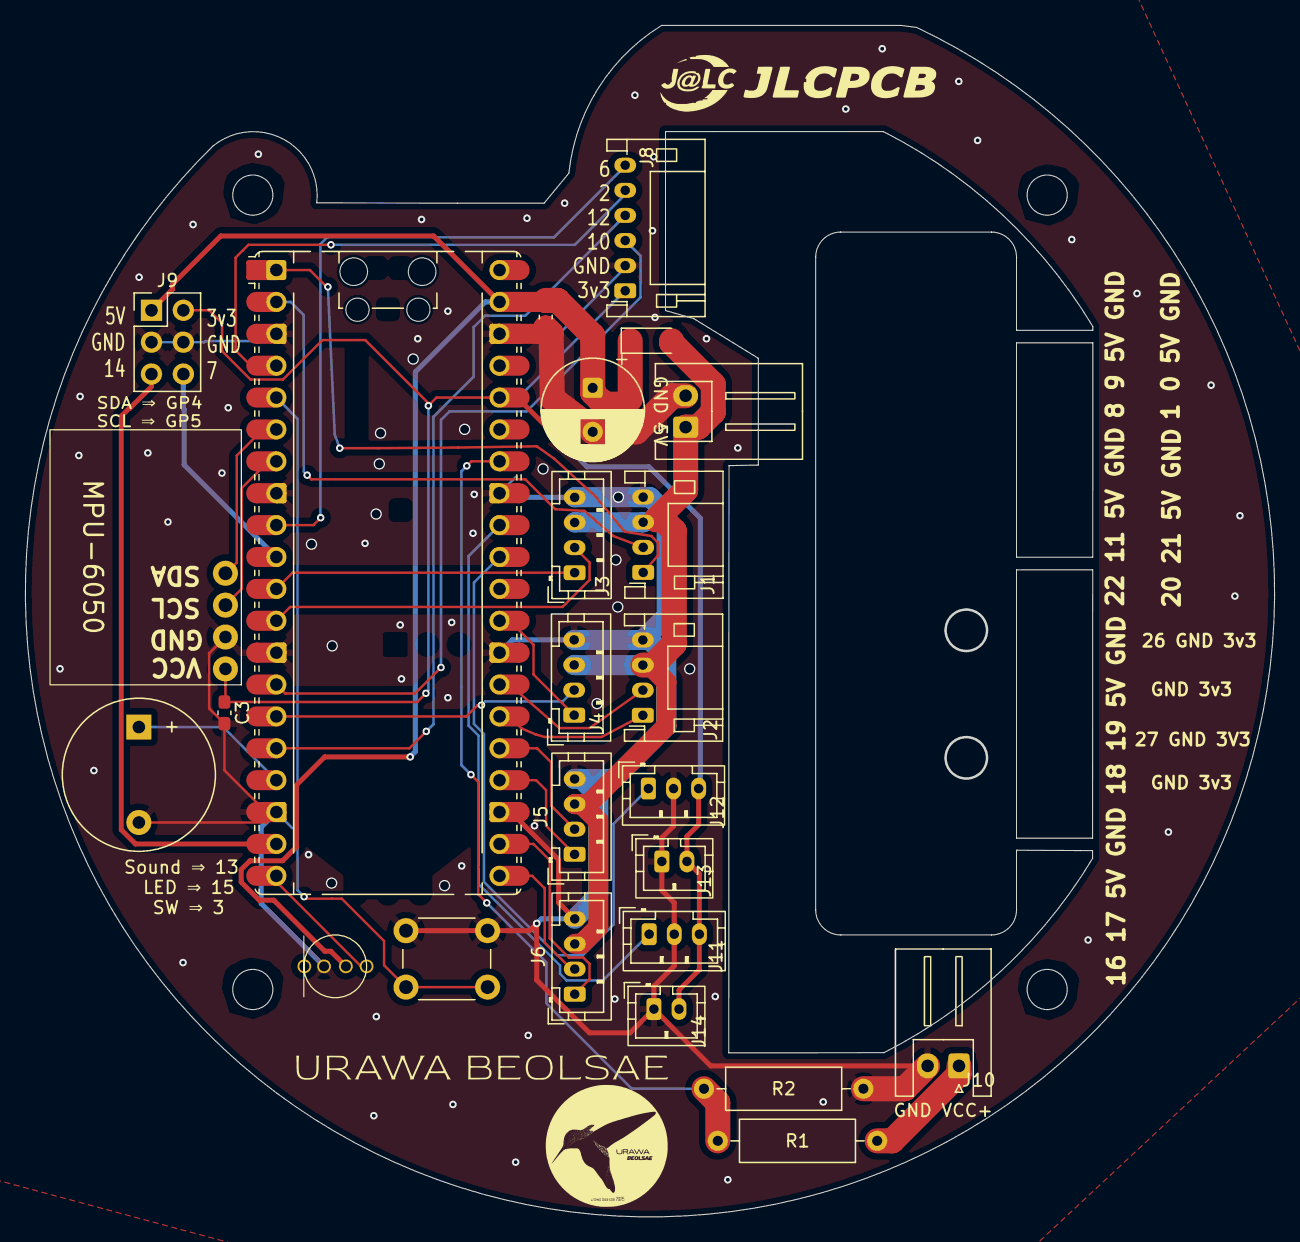
[picture p80: board Main_RCJ_Japan_prot2_with_kickBoard.kicad_pcb from above]

Board: 2 copper layers, 99.5 x 94.9 mm, 29 parts (0 on the bottom side), 31 nets.
