Tellurnoid/25RoboCup/KiCad/IR_Japan_prot3/IR_Japan_prot3.kicad_pcb

## KiCad design KiCad/IR_Japan_prot3/IR_Japan_prot3.kicad_pcb (2026-03-04)

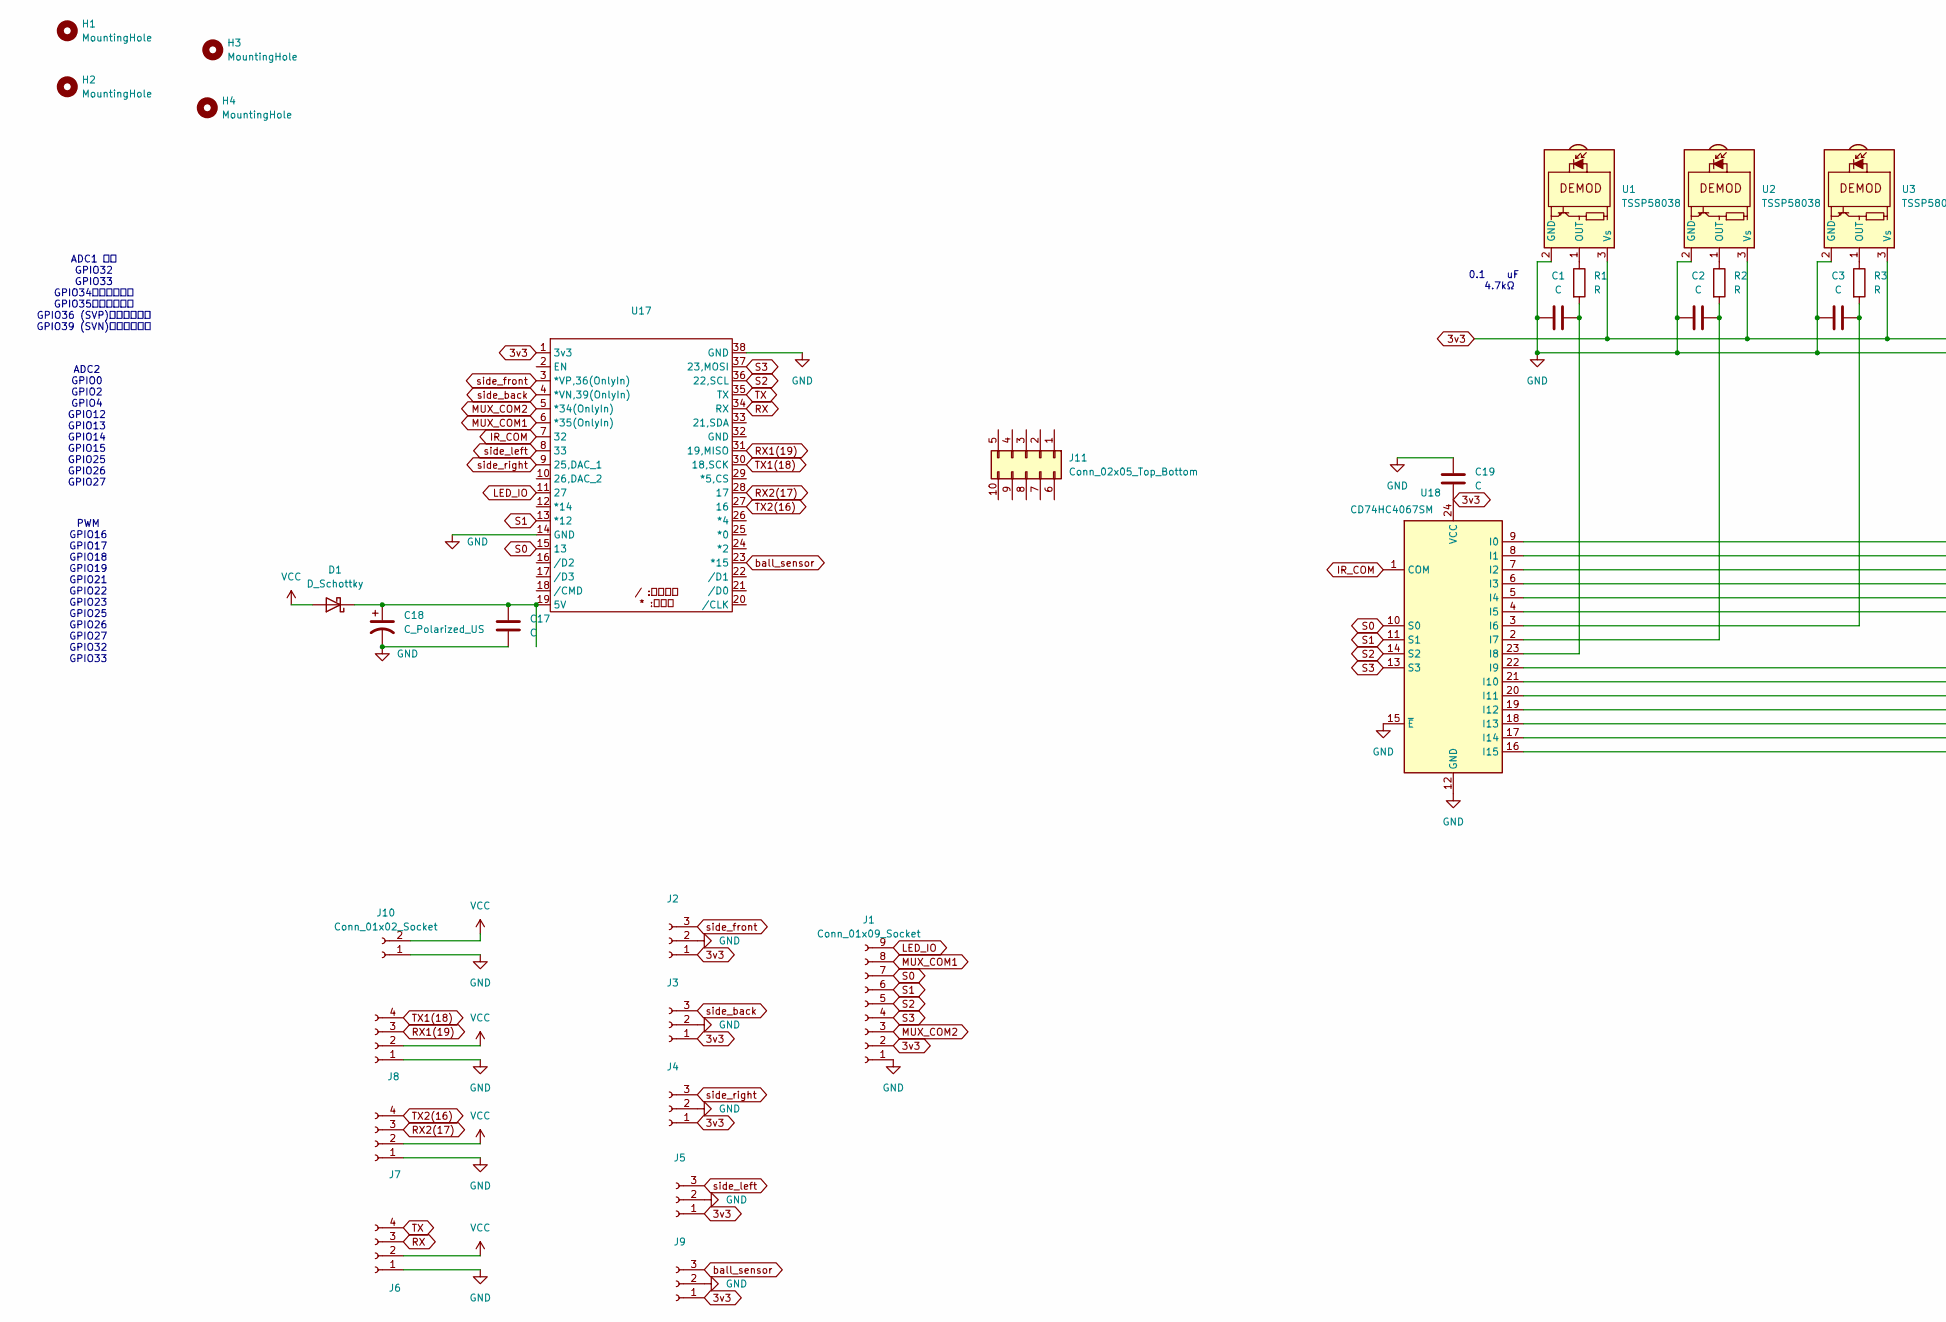
[picture p81: schematic IR_Japan_prot3.kicad_sch, part in row 1, column 1]

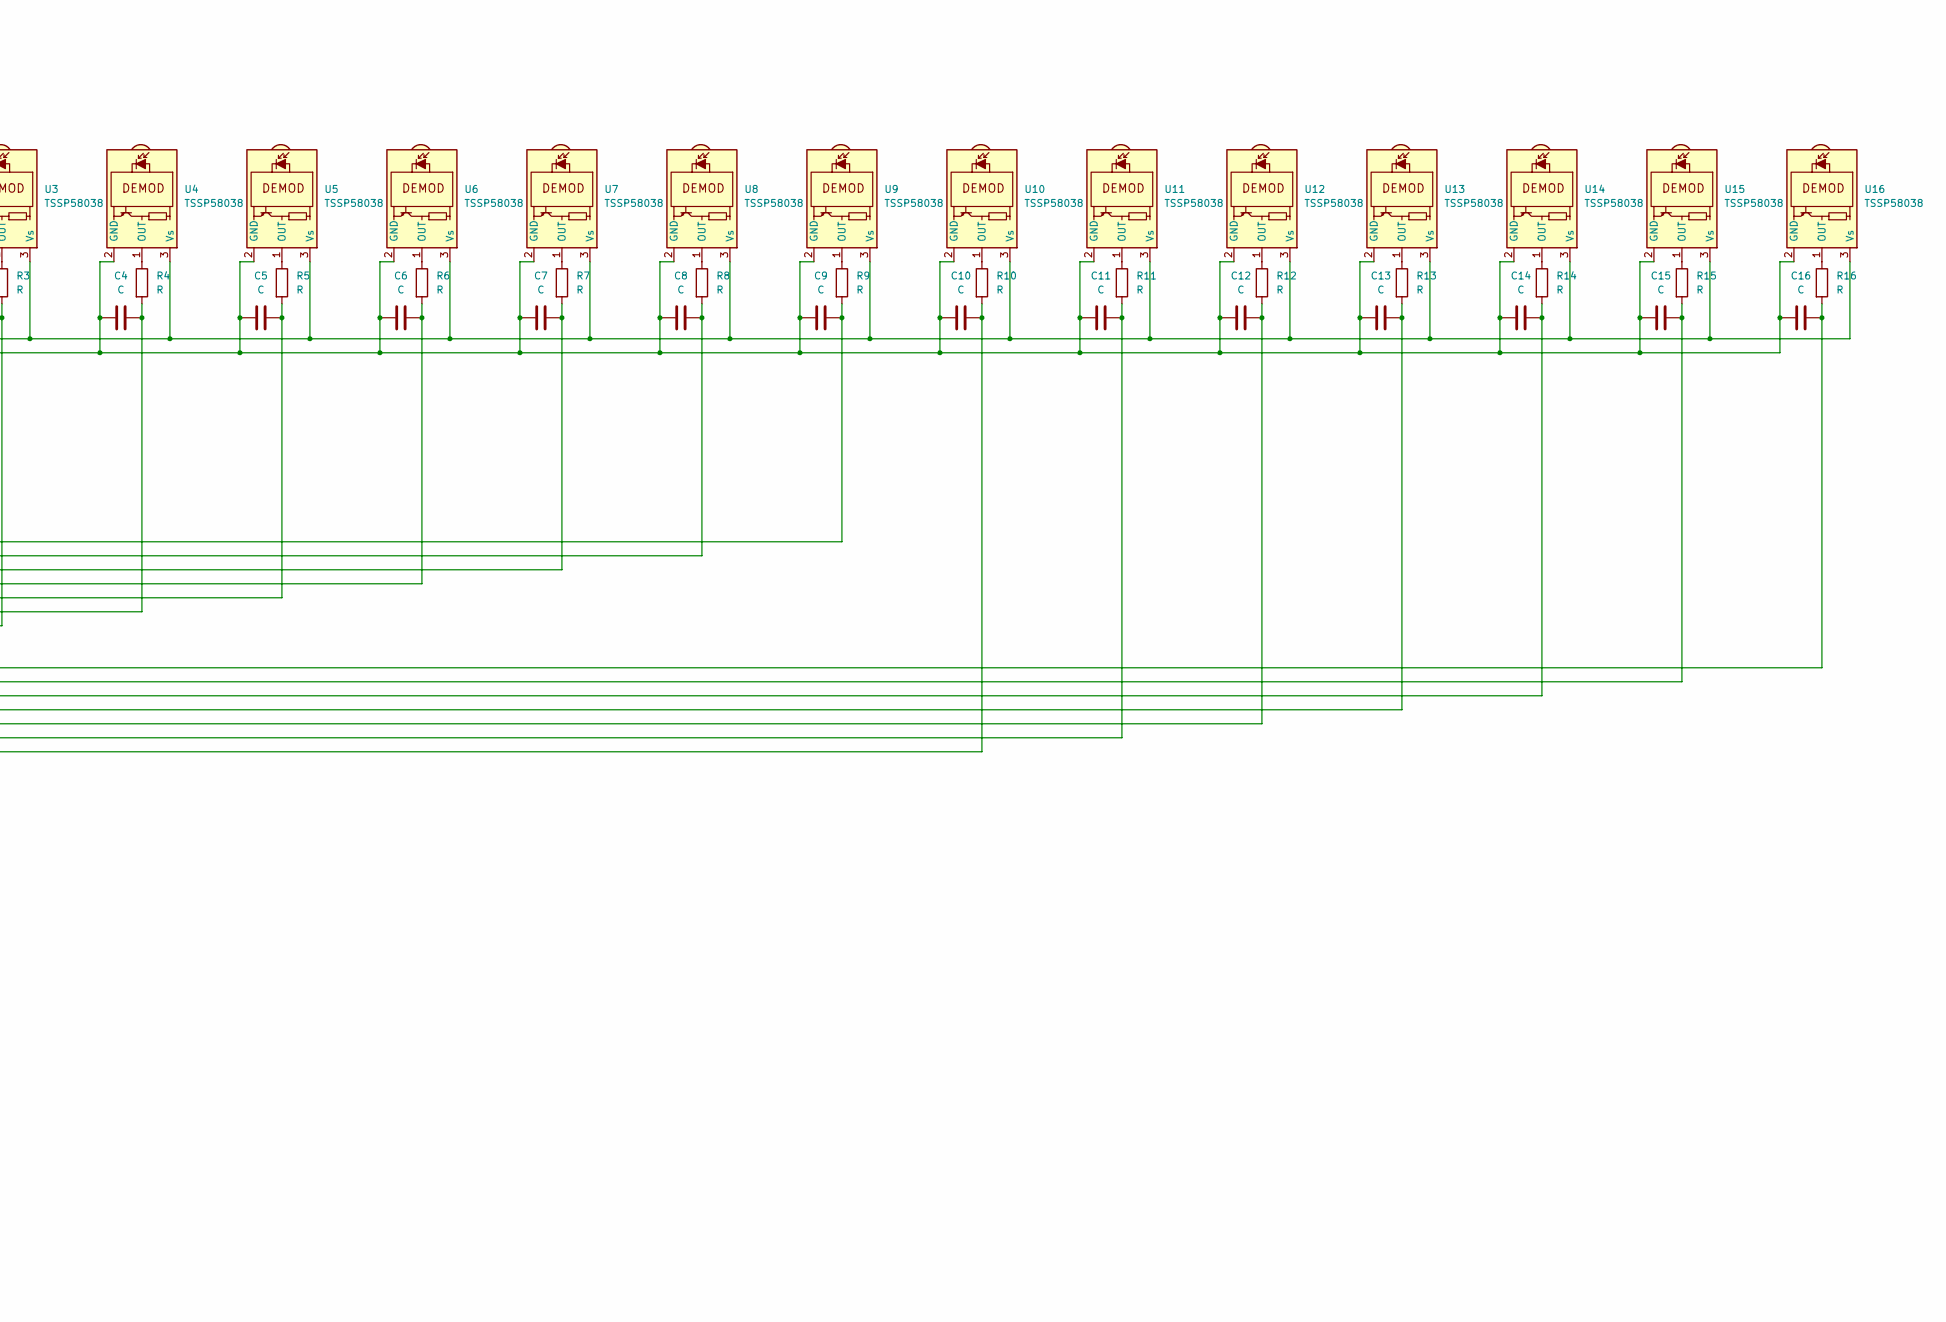
[picture p82: schematic IR_Japan_prot3.kicad_sch, part in row 1, column 2]

Parts:
C1, C2, C3, C4, C5, C6, C7, C8, C9, C10, C11, C12, C13, C14, C15, C16, C17, C19: C; C_0603_1608Metric_Pad1.08x0.95mm_HandSolder
C18: C_Polarized_US; C_Radial_D8.0mm_H11.5mm_P3.50mm
D1: D_Schottky; D_SOD-323_HandSoldering
H1, H2, H3, H4: MountingHole; MountingHole_3.2mm_M3
J1: Conn_01x09_Socket; JST_PH_S9B-PH-K_1x09_P2.00mm_Horizontal
J2, J3, J4, J5, J9: Conn_01x03_Socket; JST_PH_B3B-PH-K_1x03_P2.00mm_Vertical
J6, J7, J8: Conn_01x04_Socket; JST_PH_B4B-PH-K_1x04_P2.00mm_Vertical
J10: Conn_01x02_Socket; PinHeader_1x02_P2.54mm_Vertical
J11: Conn_02x05_Top_Bottom; PinHeader_2x05_P2.54mm_Vertical
R1, R2, R3, R4, R5, R6, R7, R8, R9, R10, R11, R12, R13, R14, R15, R16: R; R_0603_1608Metric_Pad0.98x0.95mm_HandSolder
U1, U2, U3, U4, U5, U6, U7, U8, U9, U10, U11, U12, U13, U14, U15, U16: TSSP58038; TSSP_EDITED
U17: ESP32_devModule
U18: CD74HC4067SM; SSOP-24_5.3x8.2mm_P0.65mm

Connections:
3v3: C19.2, J1.2, J2.1, J3.1, J4.1, J5.1, J9.1, U1.3 (Vs), U2.3 (Vs), U3.3 (Vs), U4.3 (Vs), U5.3 (Vs), U6.3 (Vs), U7.3 (Vs), U8.3 (Vs), U9.3 (Vs), U10.3 (Vs), U11.3 (Vs), U12.3 (Vs), U13.3 (Vs), U14.3 (Vs), U15.3 (Vs), U16.3 (Vs), U17.1 (3v3), U18.24 (VCC)
GND: C1.2, C2.2, C3.2, C4.2, C5.2, C6.2, C7.2, C8.2, C9.2, C10.2, C11.2, C12.2, C13.2, C14.2, C15.2, C16.2, C17.2, C18.2, C19.1, J1.1, J2.2, J3.2, J4.2, J5.2, J6.1, J7.1, J8.1, J9.2, J10.1, U1.2 (GND), U2.2 (GND), U3.2 (GND), U4.2 (GND), U5.2 (GND), U6.2 (GND), U7.2 (GND), U8.2 (GND), U9.2 (GND), U10.2 (GND), U11.2 (GND), U12.2 (GND), U13.2 (GND), U14.2 (GND), U15.2 (GND), U16.2 (GND), U17.14 (GND), U17.38 (GND), U18.12 (GND), U18.15 (~E)
IR_COM: U17.7 (32), U18.1 (COM)
LED_IO: J1.9, U17.11 (27)
MUX_COM1: J1.8, U17.6 (*35(OnlyIn))
MUX_COM2: J1.3, U17.5 (*34(OnlyIn))
unnamed: C17.1, C18.1, D1.1 (K), U17.19 (5V)
unnamed: R1.1, U1.1 (OUT)
unnamed: R2.1, U2.1 (OUT)
unnamed: R3.1, U3.1 (OUT)
unnamed: R4.1, U4.1 (OUT)
unnamed: R5.1, U5.1 (OUT)
unnamed: R6.1, U6.1 (OUT)
unnamed: R7.1, U7.1 (OUT)
unnamed: R8.1, U8.1 (OUT)
unnamed: R9.1, U9.1 (OUT)
unnamed: R10.1, U10.1 (OUT)
unnamed: R11.1, U11.1 (OUT)
unnamed: R12.1, U12.1 (OUT)
unnamed: R13.1, U13.1 (OUT)
unnamed: R14.1, U14.1 (OUT)
unnamed: R15.1, U15.1 (OUT)
unnamed: R16.1, U16.1 (OUT)
unnamed: C9.1, R9.2, U18.9 (I0)
unnamed: C8.1, R8.2, U18.8 (I1)
unnamed: C7.1, R7.2, U18.7 (I2)
unnamed: C6.1, R6.2, U18.6 (I3)
unnamed: C5.1, R5.2, U18.5 (I4)
unnamed: C4.1, R4.2, U18.4 (I5)
unnamed: C3.1, R3.2, U18.3 (I6)
unnamed: C2.1, R2.2, U18.2 (I7)
unnamed: C1.1, R1.2, U18.23 (I8)
unnamed: C16.1, R16.2, U18.22 (I9)
unnamed: C15.1, R15.2, U18.21 (I10)
unnamed: C14.1, R14.2, U18.20 (I11)
unnamed: C13.1, R13.2, U18.19 (I12)
unnamed: C12.1, R12.2, U18.18 (I13)
unnamed: C11.1, R11.2, U18.17 (I14)
unnamed: C10.1, R10.2, U18.16 (I15)
RX: J6.3, U17.34 (RX)
RX1(19): J8.3, U17.31 (19,MISO)
RX2(17): J7.3, U17.28 (17)
S0: J1.7, U17.15 (13), U18.10 (S0)
S1: J1.6, U17.13 (*12), U18.11 (S1)
S2: J1.5, U17.36 (22,SCL), U18.14 (S2)
S3: J1.4, U17.37 (23,MOSI), U18.13 (S3)
TX: J6.4, U17.35 (TX)
TX1(18): J8.4, U17.30 (18,SCK)
TX2(16): J7.4, U17.27 (16)
VCC: D1.2 (A), J6.2, J7.2, J8.2, J10.2
ball_sensor: J9.3, U17.23 (*15)
side_back: J3.3, U17.4 (*VN,39(OnlyIn))
side_front: J2.3, U17.3 (*VP,36(OnlyIn))
side_left: J5.3, U17.8 (33)
side_right: J4.3, U17.9 (25,DAC_1)

Notes on the sheet:
ADC1 系列 GPIO32 GPIO33 GPIO34（入力専用） GPIO35（入力専用） GPIO36 (SVP)（入力専用） GPIO39 (SVN)（入力専用）
0.1 uF
ADC2 GPIO0 GPIO2 GPIO4 GPIO12 GPIO13 GPIO14 GPIO15 GPIO25 GPIO26 GPIO27
4.7kΩ
PWM GPIO16 GPIO17 GPIO18 GPIO19 GPIO21 GPIO22 GPIO23 GPIO25 GPIO26 GPIO27 GPIO32 GPIO33

Board: 2 copper layers, 69 parts (0 on the bottom side), 55 nets, no tracks yet.
