Tellurnoid/25RoboCup/KiCad/tachanka_Main_prot1/RCJ_main/RCJ_main.kicad_pcb

## KiCad design KiCad/tachanka_Main_prot1/RCJ_main/RCJ_main.kicad_pcb (2026-02-05)

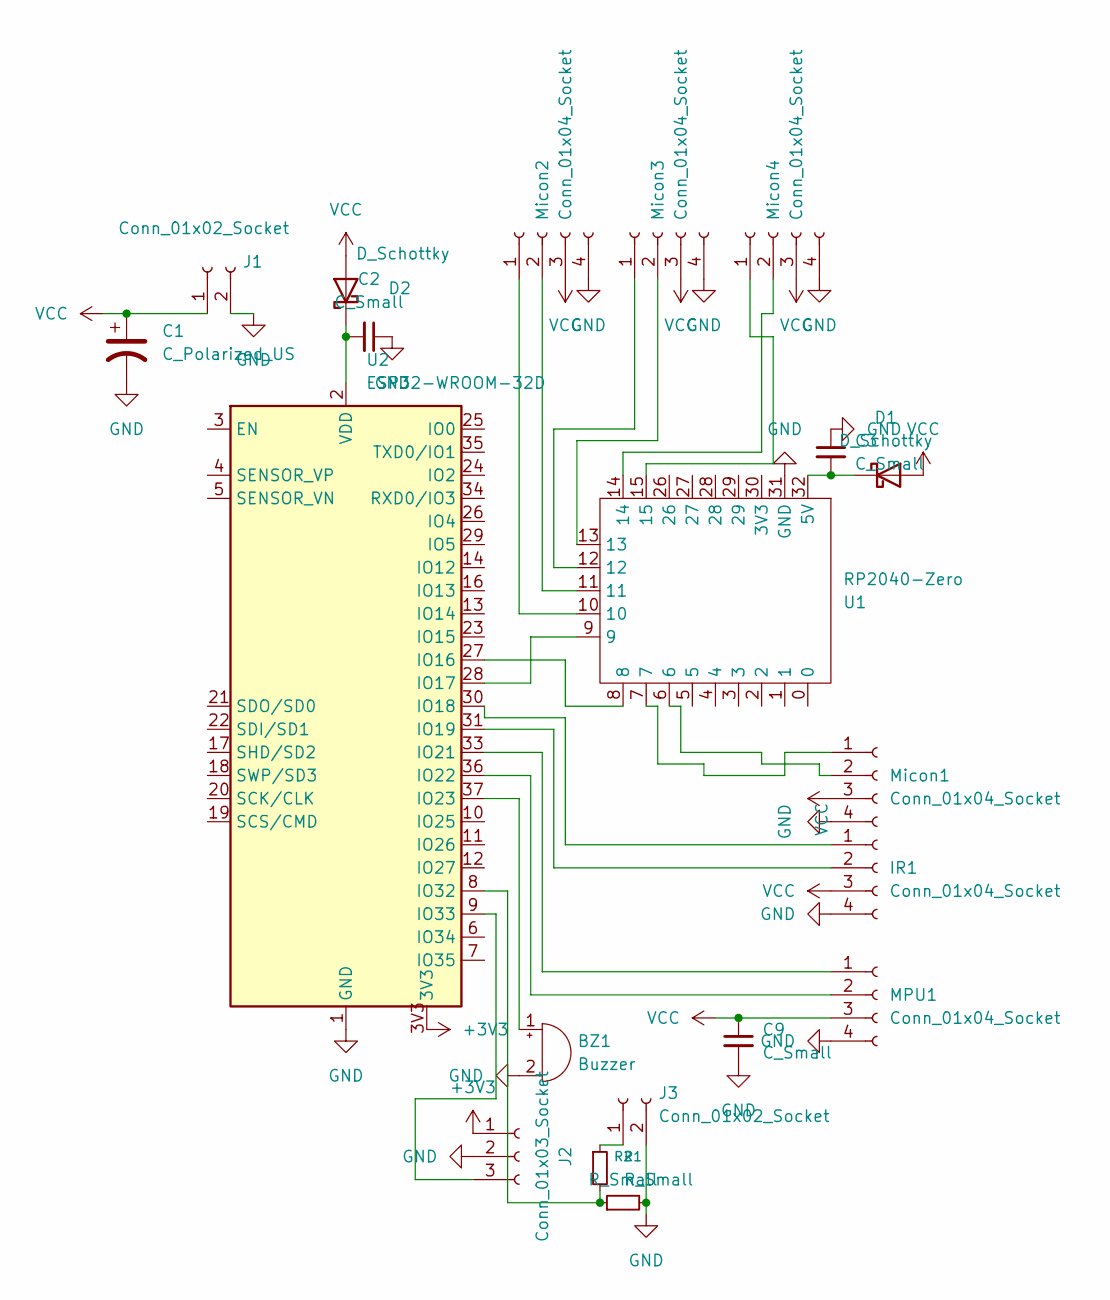
[picture p87: schematic RCJ_main.kicad_sch]

Parts:
BZ1: Buzzer; Buzzer_12x9.5RM7.6
C1: C_Polarized_US; CP_Radial_D8.0mm_P3.50mm
C2, C3, C9: C_Small; CP_EIA-1608-08_AVX-J_HandSolder
D1, D2: D_Schottky; D_SOD-123
IR1: Conn_01x04_Socket; JST_PH_S4B-PH-K_1x04_P2.00mm_Horizontal
J1: Conn_01x02_Socket; JST_XH_S2B-XH-A-1_1x02_P2.50mm_Horizontal
J2: Conn_01x03_Socket; JST_PH_B3B-PH-K_1x03_P2.00mm_Vertical
J3: Conn_01x02_Socket; JST_PH_B2B-PH-K_1x02_P2.00mm_Vertical
MPU1: Conn_01x04_Socket; MPU6050
Micon1, Micon2, Micon3: Conn_01x04_Socket; JST_PH_B4B-PH-K_1x04_P2.00mm_Vertical
Micon4: Conn_01x04_Socket; JST_PH_S4B-PH-K_1x04_P2.00mm_Horizontal
R1, R2: R_Small; R_Axial_DIN0207_L6.3mm_D2.5mm_P10.16mm_Horizontal
U1: RP2040-Zero; RP2040-Zero-THT
U2: ESP32-WROOM-32D; ESP32_devModule

Connections:
+3V3: J2.1, U2.3V3
GND: BZ1.2 (-), C1.2, C2.1, C3.1, C9.2, IR1.4, J1.2, J2.2, J3.2, MPU1.4, Micon1.4, Micon2.4, Micon3.4, Micon4.4, R2.2, U1.31 (GND), U2.1 (GND), U2.15 (GND), U2.38 (GND), U2.39 (GND)
unnamed: BZ1.1 (+), U2.37 (IO23)
unnamed: C3.2, D1.1 (K), U1.32 (5V)
unnamed: C2.2, D2.1 (K), U2.2 (VDD)
unnamed: IR1.1, U2.30 (IO18)
unnamed: IR1.2, U2.31 (IO19)
unnamed: J2.3, U2.9 (IO33)
unnamed: J3.1, R1.1
unnamed: MPU1.1, U2.33 (IO21)
unnamed: MPU1.2, U2.36 (IO22)
unnamed: Micon1.1, U1.7
unnamed: Micon1.2, U1.6
unnamed: Micon2.1, U1.10
unnamed: Micon2.2, U1.11
unnamed: Micon3.1, U1.12
unnamed: Micon3.2, U1.13
unnamed: Micon4.1, U1.15
unnamed: Micon4.2, U1.14
unnamed: U1.8, U2.27 (IO16)
unnamed: U1.9, U2.28 (IO17)
unnamed: R1.2, R2.1, U2.8 (IO32)
VCC: C1.1, C9.1, D1.2 (A), D2.2 (A), IR1.3, J1.1, MPU1.3, Micon1.3, Micon2.3, Micon3.3, Micon4.3

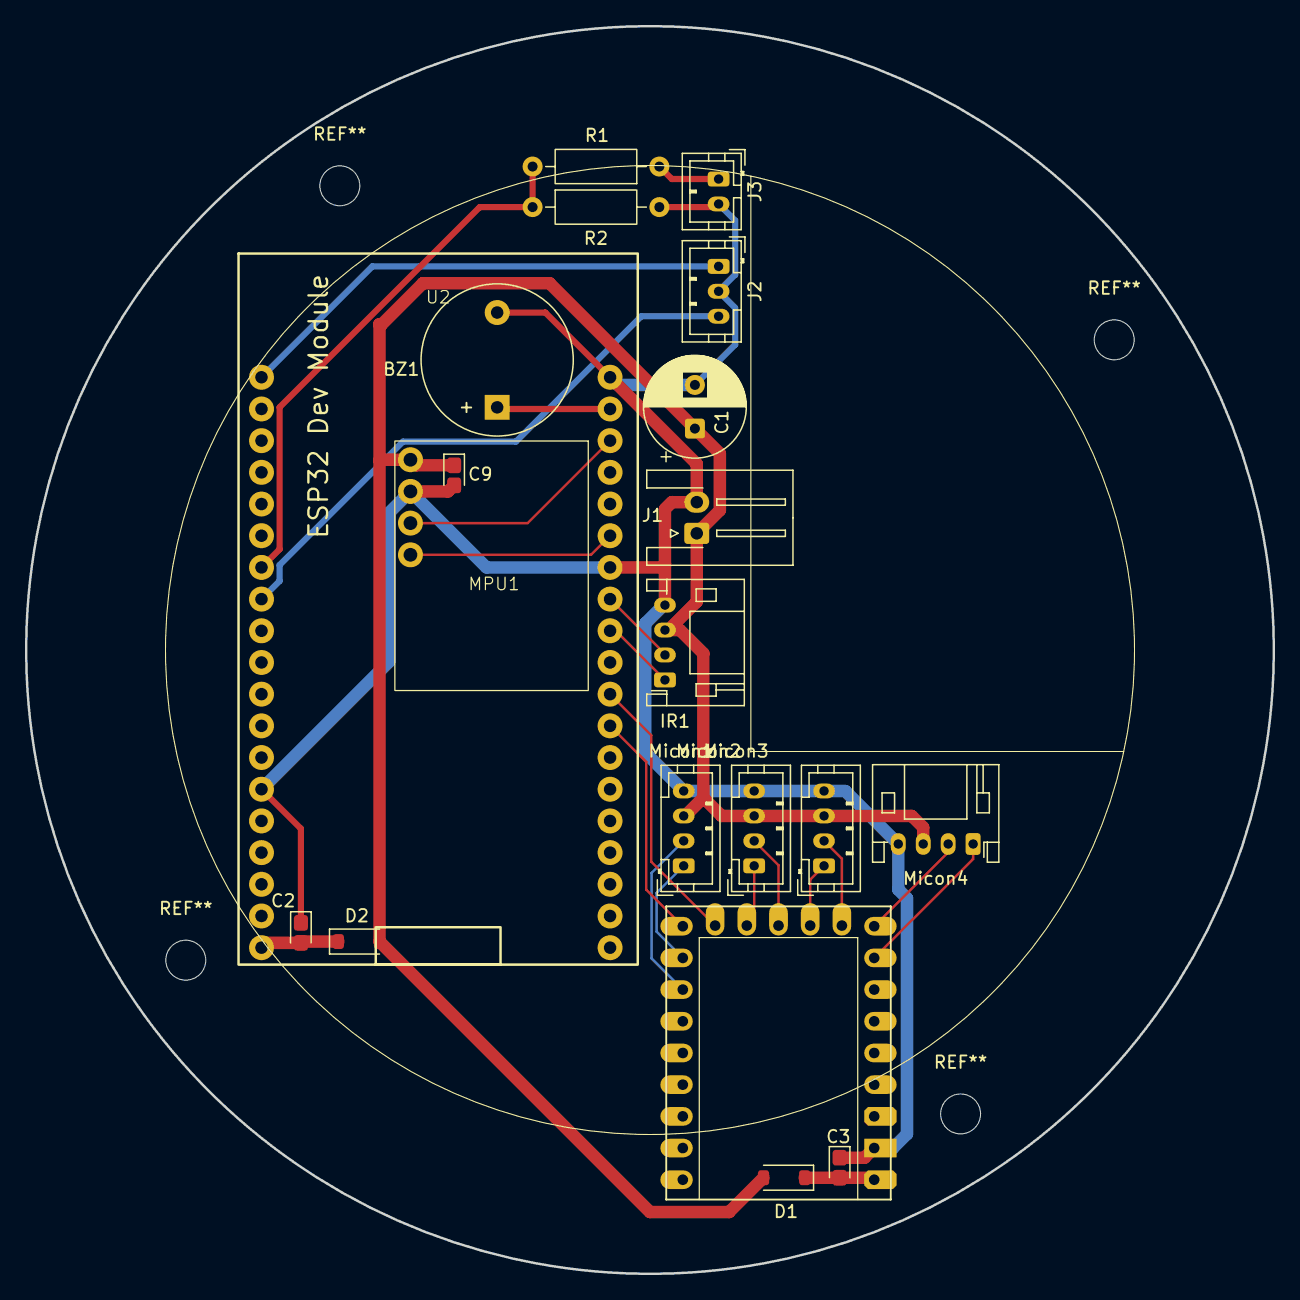
[picture p88: board RCJ_main.kicad_pcb from above]

Board: 2 copper layers, 100.0 x 100.0 mm, 20 parts (0 on the bottom side), 23 nets.
