Tellurnoid/25RoboCup/KiCad/NOT USED/matudachi_motor_prot1/v2_MotorDriver/v2_MotorDriver/v2_MotorDriver.kicad_pcb

## KiCad design KiCad/NOT USED/matudachi_motor_prot1/v2_MotorDriver/v2_MotorDriver/v2_MotorDriver.kicad_pcb (2026-01-31)

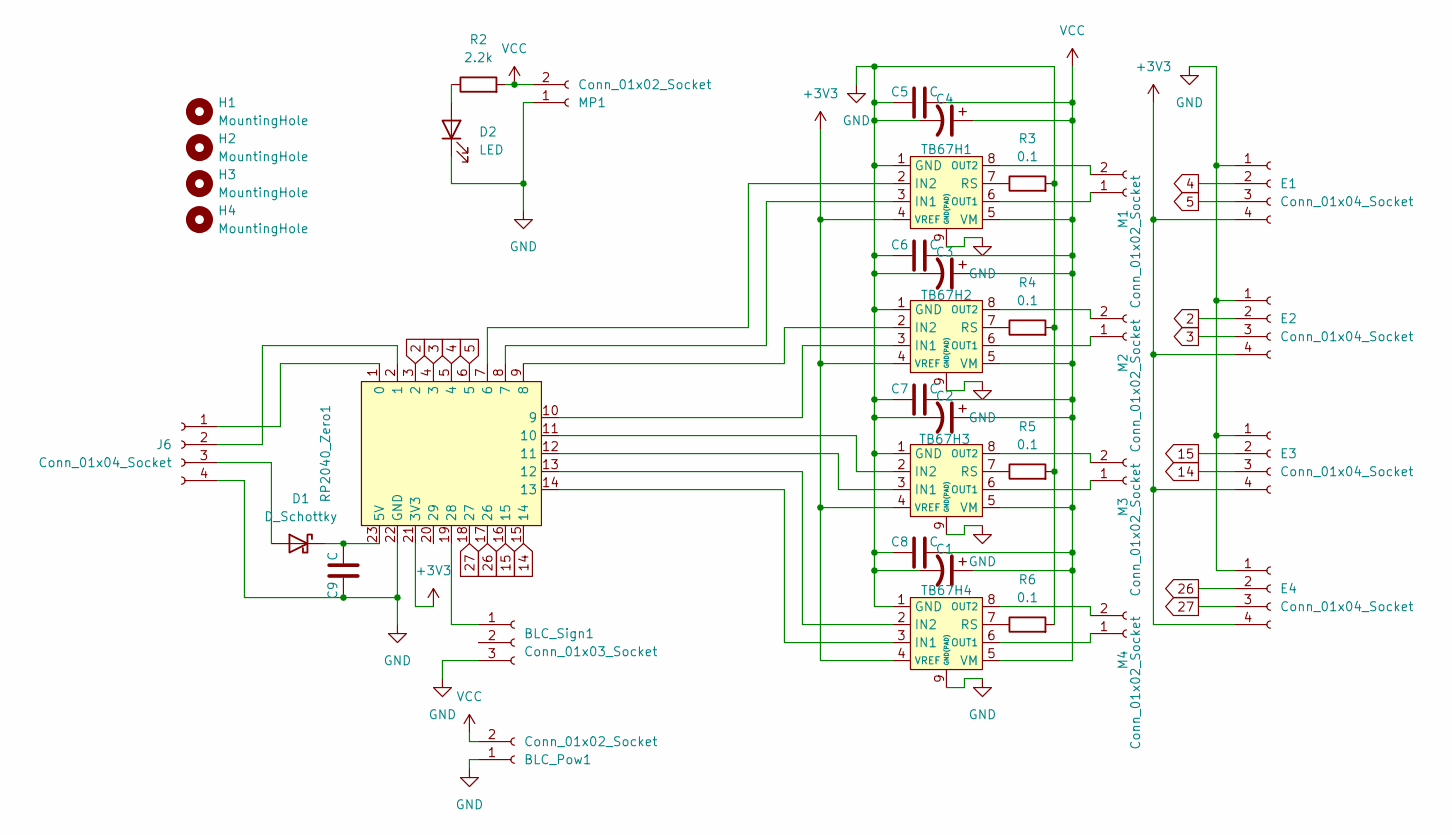
[picture p89: schematic v2_MotorDriver.kicad_sch]

Parts:
BLC_Pow1: Conn_01x02_Socket; AMASS_XT30U-F_1x02_P5.0mm_Vertical
BLC_Sign1: Conn_01x03_Socket; JST_XH_B3B-XH-A_1x03_P2.50mm_Vertical
C1, C2, C3, C4: C_Polarized_US; CP_Radial_D6.3mm_P2.50mm
C5, C6, C7, C8, C9: C; C_0603_1608Metric_Pad1.08x0.95mm_HandSolder
D1: D_Schottky; D_SOD-323F
D2: LED; LED_0603_1608Metric_Pad1.05x0.95mm_HandSolder
E1, E2, E3, E4: Conn_01x04_Socket; JST_PH_B4B-PH-K_1x04_P2.00mm_Vertical
H1, H2, H3, H4: MountingHole; MountingHole_3.2mm_M3
J6: Conn_01x04_Socket; JST_XH_B4B-XH-A_1x04_P2.50mm_Vertical
M1, M2, M3, M4: Conn_01x02_Socket; JST_VH_B2P-VH-B_1x02_P3.96mm_Vertical
MP1: Conn_01x02_Socket; AMASS_XT30U-M_1x02_P5.0mm_Vertical
R2: 2.2k; R_Axial_DIN0207_L6.3mm_D2.5mm_P7.62mm_Horizontal
R3, R4, R5, R6: 0.1; R_Axial_DIN0207_L6.3mm_D2.5mm_P7.62mm_Horizontal
RP2040_Zero1: 名称未設定
TB67H1, TB67H2, TB67H3, TB67H4: SOIC-8-1EP_3.9x4.9mm_P1.27mm_EP2.29x3mm_ThermalVias

Connections:
2: E2.2, RP2040_Zero1.3 (2)
3: E2.3, RP2040_Zero1.4 (3)
4: E1.2, RP2040_Zero1.5 (4)
5: E1.3, RP2040_Zero1.6 (5)
14: E3.3, RP2040_Zero1.15 (14)
15: E3.2, RP2040_Zero1.16 (15)
26: E4.2, RP2040_Zero1.17 (26)
27: E4.3, RP2040_Zero1.18 (27)
+3V3: E1.4, E2.4, E3.4, E4.4, RP2040_Zero1.21 (3V3), TB67H1.4 (VREF), TB67H2.4 (VREF), TB67H3.4 (VREF), TB67H4.4 (VREF)
GND: BLC_Pow1.1, BLC_Sign1.3, C1.2, C2.2, C3.2, C4.2, C5.1, C6.1, C7.1, C8.1, C9.1, D2.1 (K), E1.1, E2.1, E3.1, E4.1, J6.4, MP1.1, R3.2, R4.2, R5.2, R6.2, RP2040_Zero1.22 (GND), TB67H1.1 (GND), TB67H1.9 (GND(PAD)), TB67H2.1 (GND), TB67H2.9 (GND(PAD)), TB67H3.1 (GND), TB67H3.9 (GND(PAD)), TB67H4.1 (GND), TB67H4.9 (GND(PAD))
unnamed: BLC_Sign1.1, RP2040_Zero1.19 (28)
unnamed: D1.2 (A), J6.3
unnamed: C9.2, D1.1 (K), RP2040_Zero1.23 (5V)
unnamed: D2.2 (A), R2.1
unnamed: J6.1, RP2040_Zero1.1 (0)
unnamed: J6.2, RP2040_Zero1.2 (1)
unnamed: M1.1, TB67H1.6 (OUT1)
unnamed: M1.2, TB67H1.8 (OUT2)
unnamed: M2.1, TB67H2.6 (OUT1)
unnamed: M2.2, TB67H2.8 (OUT2)
unnamed: M3.1, TB67H3.6 (OUT1)
unnamed: M3.2, TB67H3.8 (OUT2)
unnamed: M4.1, TB67H4.6 (OUT1)
unnamed: M4.2, TB67H4.8 (OUT2)
unnamed: RP2040_Zero1.7 (6), TB67H1.2 (IN2)
unnamed: RP2040_Zero1., RP2040_Zero1.8 (7), TB67H1.3 (IN1)
unnamed: RP2040_Zero1.9 (8), TB67H2.2 (IN2)
unnamed: RP2040_Zero1.10 (9), TB67H2.3 (IN1)
unnamed: RP2040_Zero1.11 (10), TB67H3.2 (IN2)
unnamed: RP2040_Zero1.12 (11), TB67H3.3 (IN1)
unnamed: RP2040_Zero1.13 (12), TB67H4.2 (IN2)
unnamed: RP2040_Zero1.14 (13), TB67H4.3 (IN1)
unnamed: R3.1, TB67H1.7 (RS)
unnamed: R4.1, TB67H2.7 (RS)
unnamed: R5.1, TB67H3.7 (RS)
unnamed: R6.1, TB67H4.7 (RS)
VCC: BLC_Pow1.2, C1.1, C2.1, C3.1, C4.1, C5.2, C6.2, C7.2, C8.2, MP1.2, R2.2, TB67H1.5 (VM), TB67H2.5 (VM), TB67H3.5 (VM), TB67H4.5 (VM)

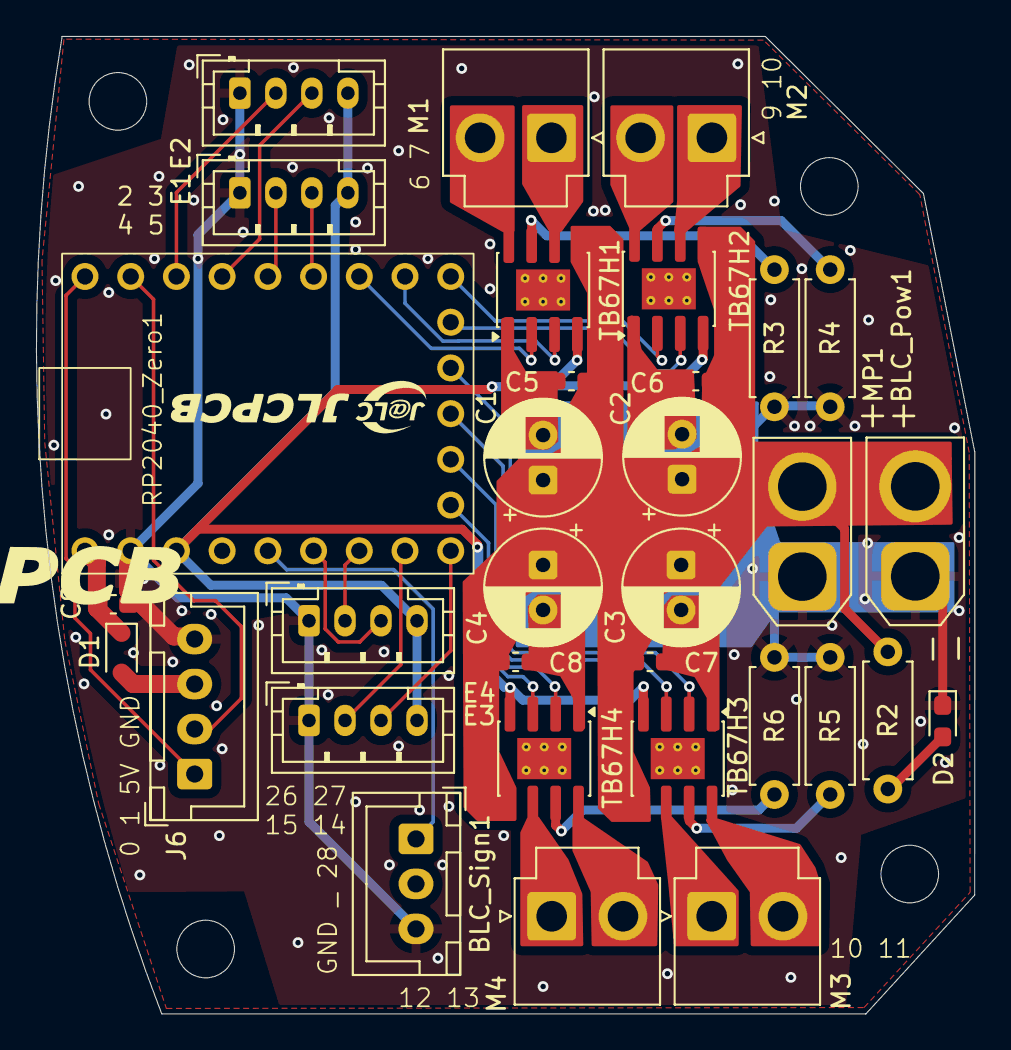
[picture p90: board v2_MotorDriver.kicad_pcb from above]

Board: 2 copper layers, 52.1 x 54.3 mm, 37 parts (0 on the bottom side), 37 nets.
