Tellurnoid/25RoboCup/KiCad/tachanka_Power_prot1/RCJ_Power_ai/RCJ_Power.kicad_pcb

## KiCad design KiCad/tachanka_Power_prot1/RCJ_Power_ai/RCJ_Power.kicad_pcb (2026-02-03)

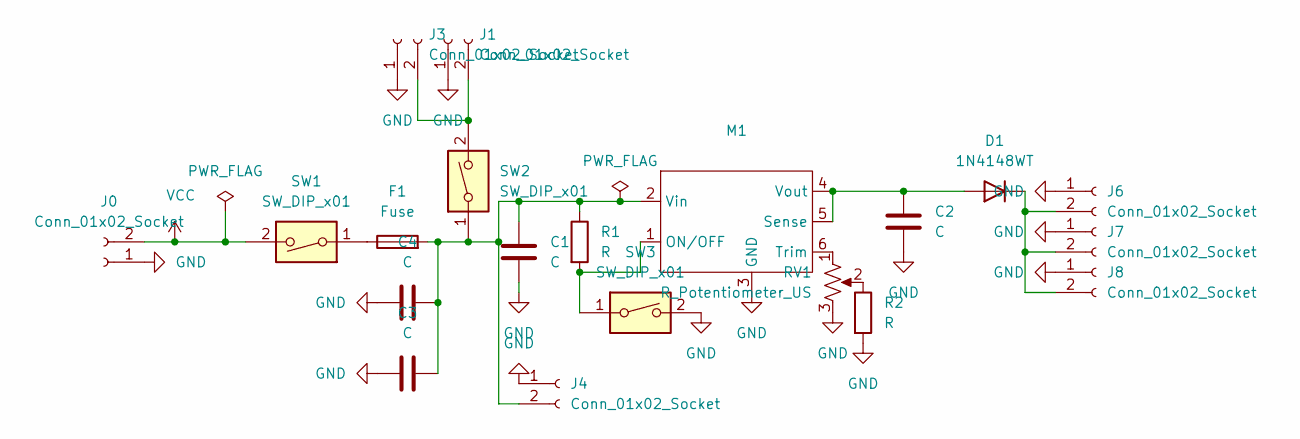
[picture p91: schematic RCJ_Power.kicad_sch]

Parts:
C1, C2: C; CP_EIA-1608-10_AVX-L_HandSolder
C3, C4: C; CP_Radial_D12.5mm_P5.00mm
D1: 1N4148WT; D_SMC
F1: Fuse; Fuseholder
J0: Conn_01x02_Socket; AMASS_XT60-M_1x02_P7.20mm_Vertical
J1: Conn_01x02_Socket; AMASS_XT30U-M_1x02_P5.0mm_Vertical
J3, J6, J7, J8: Conn_01x02_Socket; JST_XH_B2B-XH-A_1x02_P2.50mm_Vertical
J4: Conn_01x02_Socket; 2Connect
M1: MURATA_OKL-KAIZOU
R1: R; R_Axial_DIN0207_L6.3mm_D2.5mm_P10.16mm_Horizontal
R2: R; R_Axial_DIN0204_L3.6mm_D1.6mm_P5.08mm_Horizontal
RV1: R_Potentiometer_US; Potentiometer_Bourns_3296W_Vertical
SW1, SW2: SW_DIP_x01; DS-850
SW3: SW_DIP_x01; Toggle

Connections:
GND: C1.2, C2.2, C3.1, C4.1, J0.1, J1.1, J3.1, J4.1, J6.1, J7.1, J8.1, M1.3 (GND), R2.2, RV1.3, SW3.2
unnamed: C2.1, D1.2 (A), M1.4 (Vout), M1.5 (Sense)
unnamed: D1.1 (K), J6.2, J7.2, J8.2
unnamed: F1.1, SW1.1
unnamed: J1.2, J3.2, SW2.2
unnamed: C1.1, C3.2, C4.2, F1.2, J4.2, M1.2 (Vin), R1.1, SW2.1
unnamed: M1.1 (ON/OFF), R1.2, SW3.1
unnamed: M1.6 (Trim), RV1.1
unnamed: R2.1, RV1.2
VCC: J0.2, SW1.2

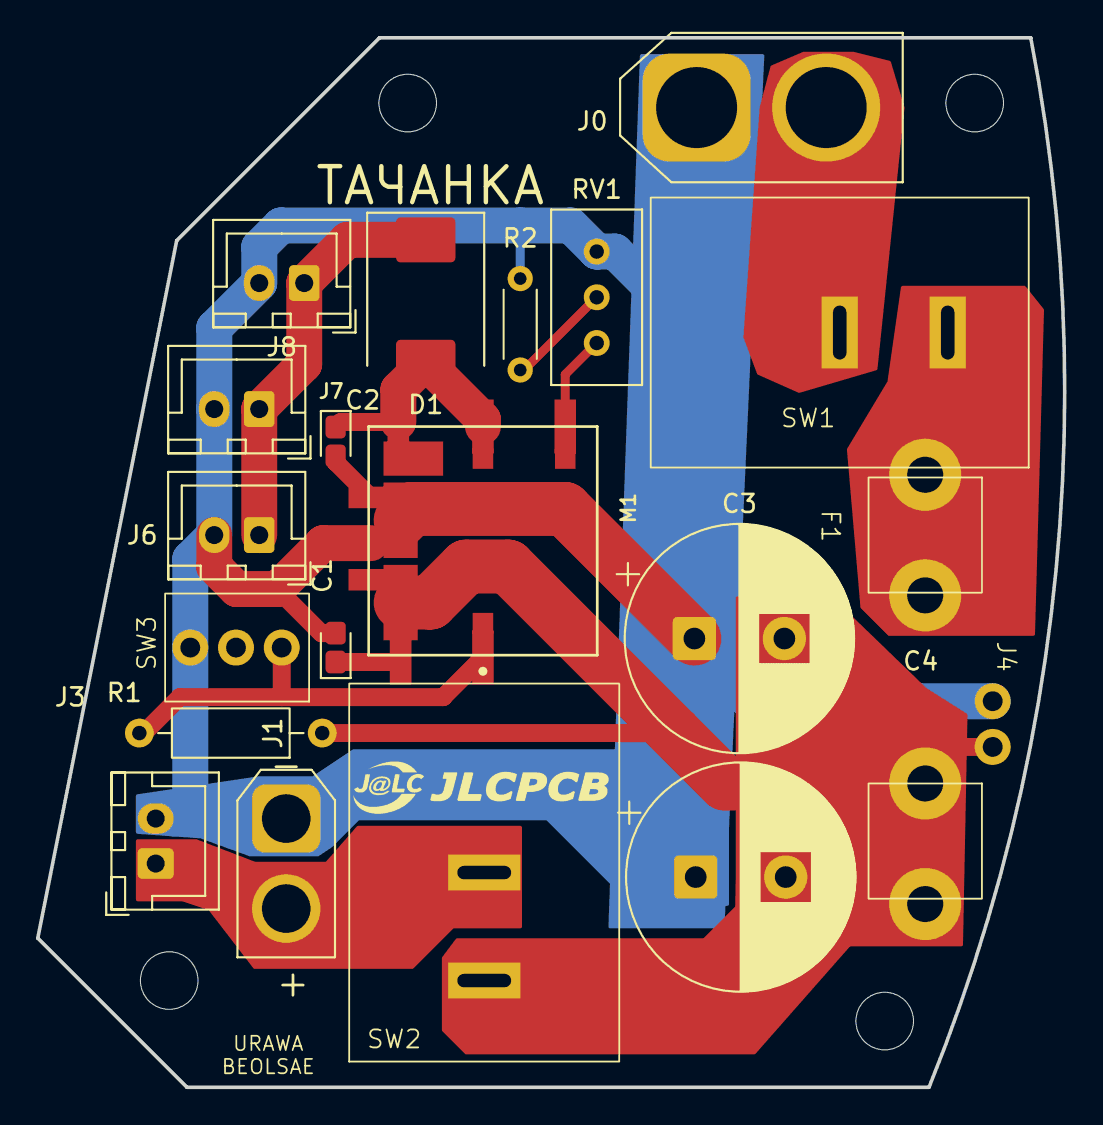
[picture p92: board RCJ_Power.kicad_pcb from above]

Board: 2 copper layers, 57.1 x 58.3 mm, 20 parts (0 on the bottom side), 10 nets.
