Tellurnoid/25RoboCup/埼玉ブロック/kiCad/LineSensor_Block_prot1/LineSensor_Block_prot1.kicad_pcb

## KiCad design 埼玉ブロック/kiCad/LineSensor_Block_prot1/LineSensor_Block_prot1.kicad_pcb (2025-12-22)

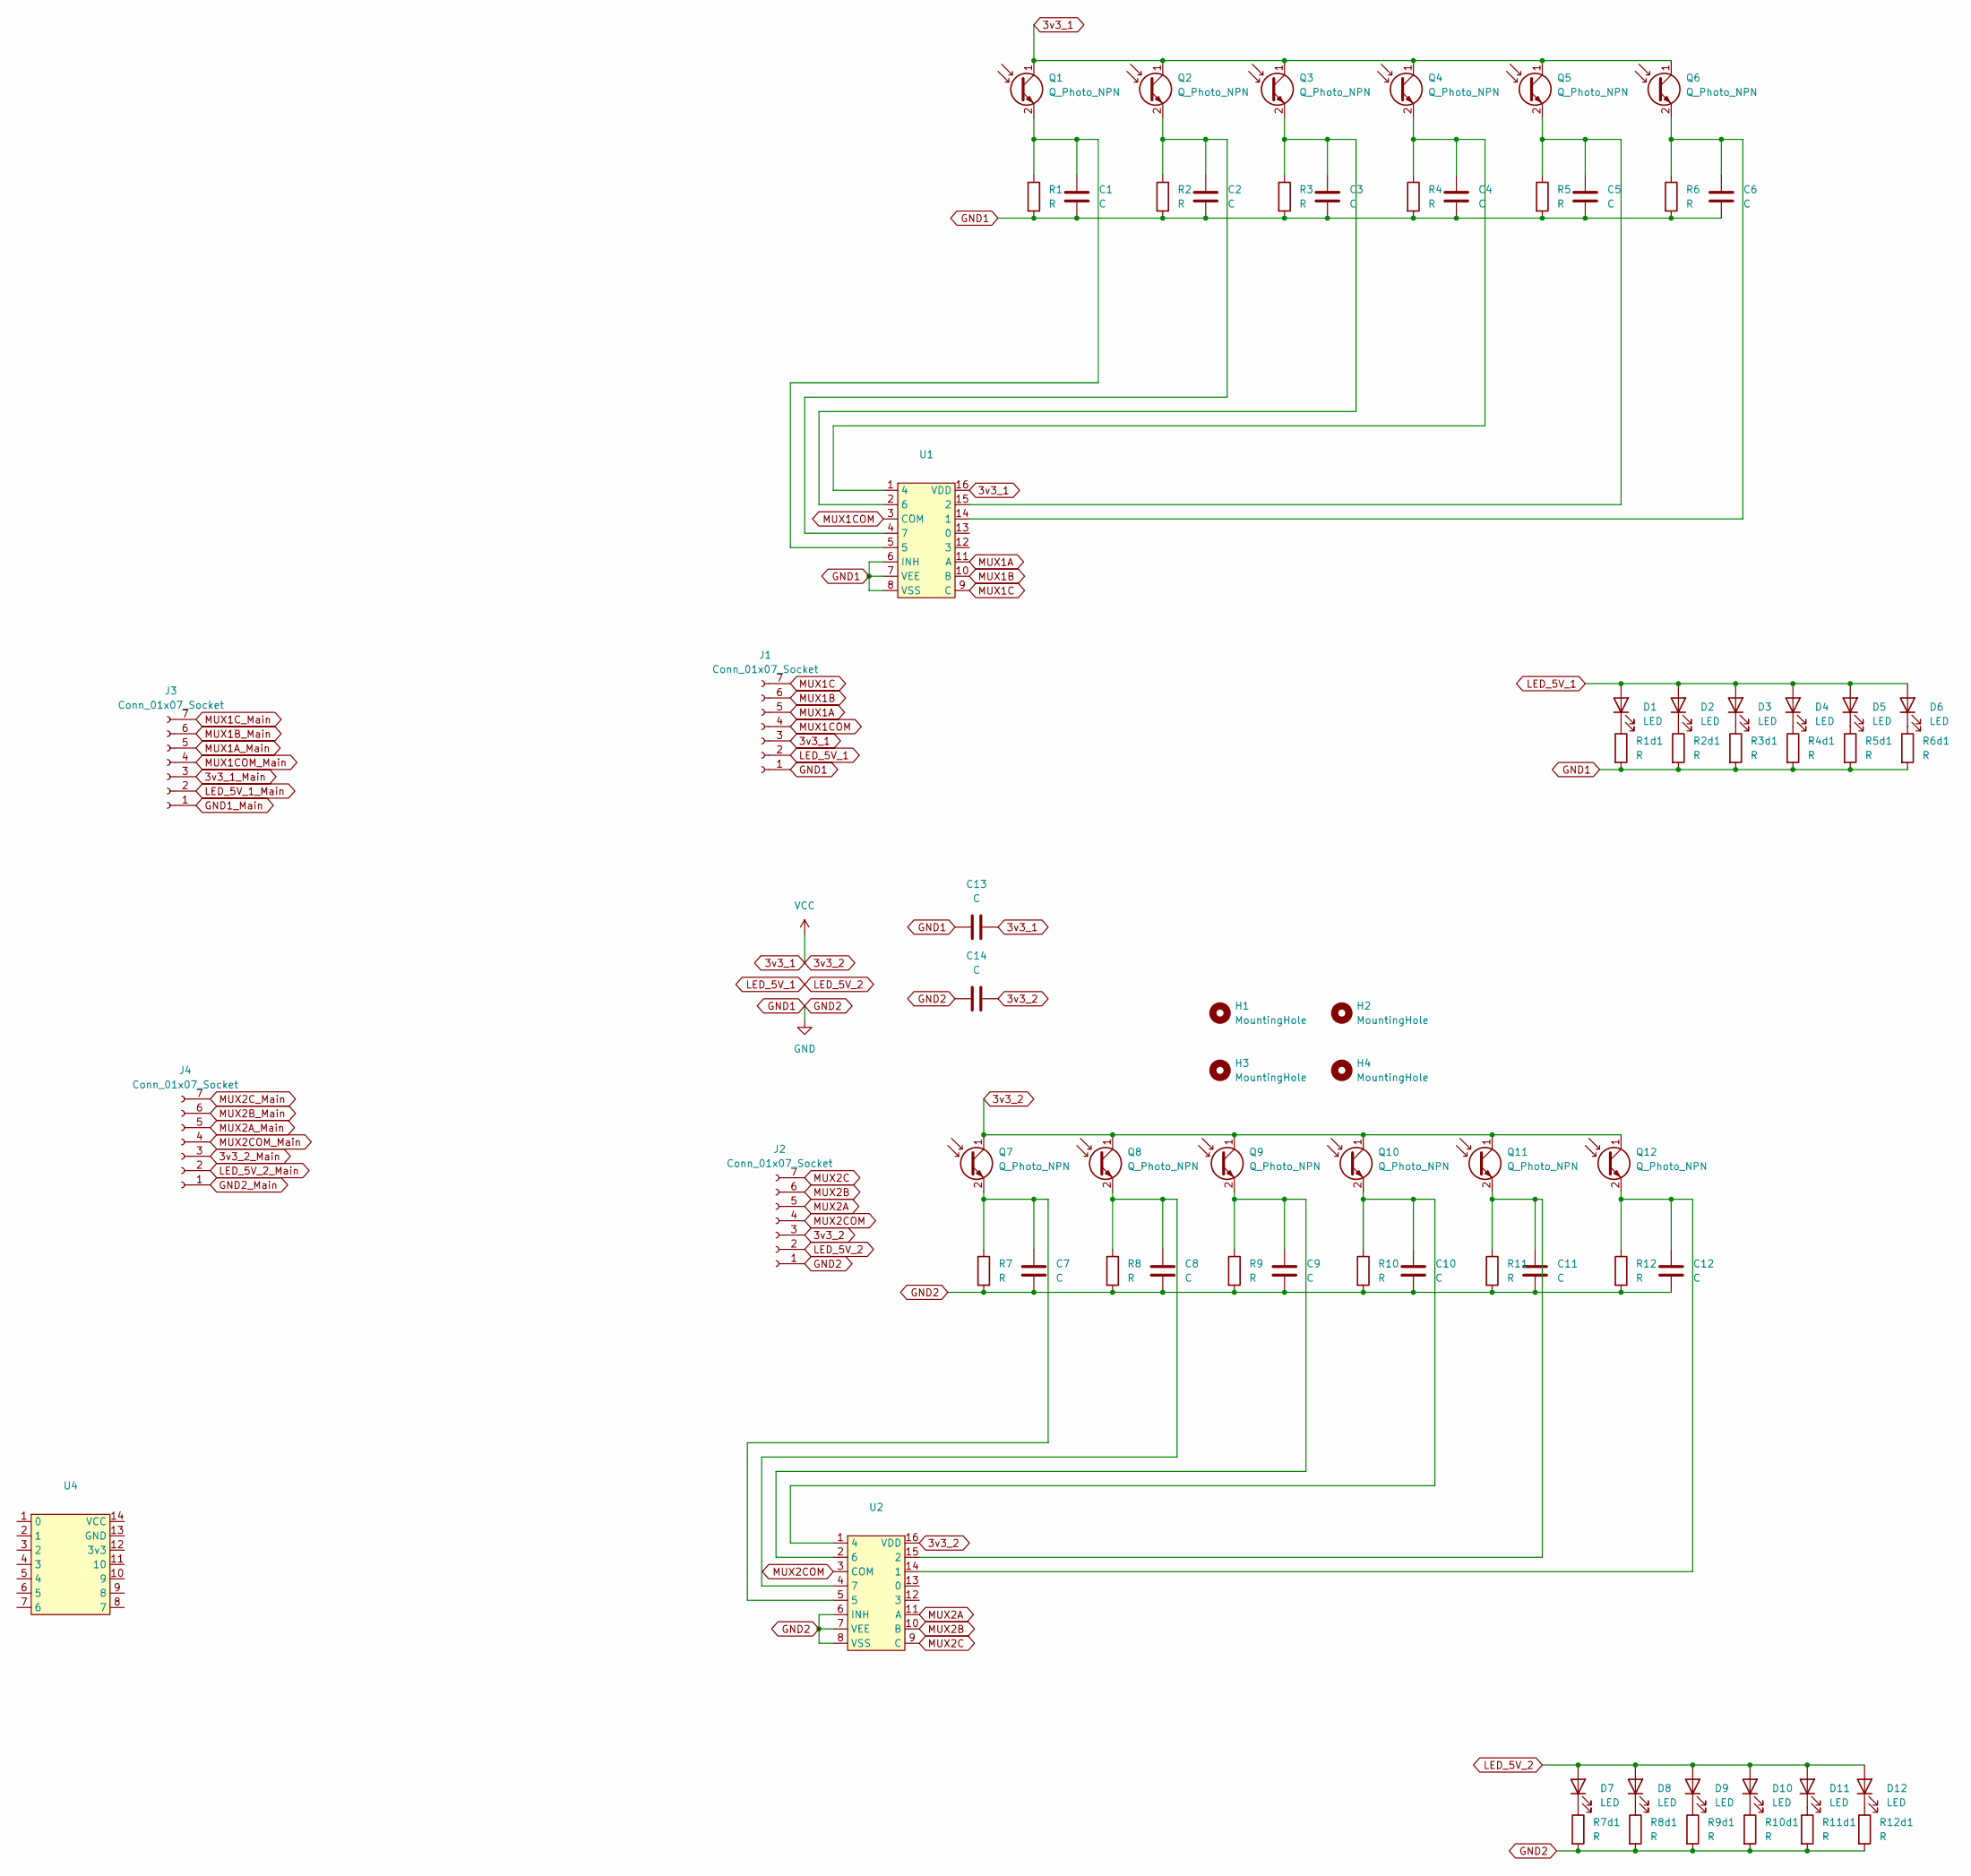
[picture p93: schematic LineSensor_Block_prot1.kicad_sch]

Parts:
C1, C2, C3, C4, C5, C6, C8, C9, C10, C11, C12, C13, C14: C; C_0603_1608Metric
C7: C; R_0603_1608Metric
D1, D2, D3, D4, D5, D6, D7, D8, D9, D10, D11, D12: LED; LED_0603_1608Metric
H1, H2, H3, H4: MountingHole; MountingHole_3.2mm_M3
J1, J2: Conn_01x07_Socket; PinHeader_1x07_P2.54mm_Horizontal_edited
J3, J4: Conn_01x07_Socket; PinSocket_1x07_P2.54mm_Horizontal_edited
Q1, Q2, Q3, Q4, Q5, Q6, Q7, Q8, Q9, Q10, Q11, Q12: Q_Photo_NPN; LED_0603_1608Metric
R1, R1d1, R2, R2d1, R3, R3d1, R4, R4d1, R5, R5d1, R6, R6d1, R7, R7d1, R8, R8d1, R9, R9d1, R10, R10d1, R11, R11d1, R12, R12d1: R; R_0603_1608Metric
U1, U2: TSSOP-16_4.4x5mm_P0.65mm
U4: 名称未設定

Connections:
3v3_1: C13.2, C14.2, J1.3, J2.3, Q1.1 (C), Q2.1 (C), Q3.1 (C), Q4.1 (C), Q5.1 (C), Q6.1 (C), Q7.1 (C), Q8.1 (C), Q9.1 (C), Q10.1 (C), Q11.1 (C), Q12.1 (C), U1.16 (VDD), U2.16 (VDD)
3v3_1_Main: J3.3
3v3_2_Main: J4.3
GND1: C1.2, C2.2, C3.2, C4.2, C5.2, C6.2, C7.2, C8.2, C9.2, C10.2, C11.2, C12.2, C13.1, C14.1, J1.1, J2.1, R1.2, R1d1.2, R2.2, R2d1.2, R3.2, R3d1.2, R4.2, R4d1.2, R5.2, R5d1.2, R6.2, R6d1.2, R7.2, R7d1.2, R8.2, R8d1.2, R9.2, R9d1.2, R10.2, R10d1.2, R11.2, R11d1.2, R12.2, R12d1.2, U1.6 (INH), U1.7 (VEE), U1.8 (VSS), U2.6 (INH), U2.7 (VEE), U2.8 (VSS)
GND1_Main: J3.1
GND2_Main: J4.1
LED_5V_1: D1.2 (A), D2.2 (A), D3.2 (A), D4.2 (A), D5.2 (A), D6.2 (A), D7.2 (A), D8.2 (A), D9.2 (A), D10.2 (A), D11.2 (A), D12.2 (A), J1.2, J2.2
LED_5V_1_Main: J3.2
LED_5V_2_Main: J4.2
MUX1A: J1.5, U1.11 (A)
MUX1A_Main: J3.5
MUX1B: J1.6, U1.10 (B)
MUX1B_Main: J3.6
MUX1C: J1.7, U1.9 (C)
MUX1COM: J1.4, U1.3 (COM)
MUX1COM_Main: J3.4
MUX1C_Main: J3.7
MUX2A: J2.5, U2.11 (A)
MUX2A_Main: J4.5
MUX2B: J2.6, U2.10 (B)
MUX2B_Main: J4.6
MUX2C: J2.7, U2.9 (C)
MUX2COM: J2.4, U2.3 (COM)
MUX2COM_Main: J4.4
MUX2C_Main: J4.7
unnamed: D1.1 (K), R1d1.1
unnamed: D2.1 (K), R2d1.1
unnamed: D3.1 (K), R3d1.1
unnamed: D4.1 (K), R4d1.1
unnamed: D5.1 (K), R5d1.1
unnamed: D6.1 (K), R6d1.1
unnamed: D7.1 (K), R7d1.1
unnamed: D8.1 (K), R8d1.1
unnamed: D9.1 (K), R9d1.1
unnamed: D10.1 (K), R10d1.1
unnamed: D11.1 (K), R11d1.1
unnamed: D12.1 (K), R12d1.1
unnamed: C1.1, Q1.2 (E), R1.1, U1.5
unnamed: C2.1, Q2.2 (E), R2.1, U1.4 (7)
unnamed: C3.1, Q3.2 (E), R3.1, U1.2 (6)
unnamed: C4.1, Q4.2 (E), R4.1, U1.1 (4)
unnamed: C5.1, Q5.2 (E), R5.1, U1.15 (2)
unnamed: C6.1, Q6.2 (E), R6.1, U1.14 (1)
unnamed: C7.1, Q7.2 (E), R7.1, U2.5
unnamed: C8.1, Q8.2 (E), R8.1, U2.4 (7)
unnamed: C9.1, Q9.2 (E), R9.1, U2.2 (6)
unnamed: C10.1, Q10.2 (E), R10.1, U2.1 (4)
unnamed: C11.1, Q11.2 (E), R11.1, U2.15 (2)
unnamed: C12.1, Q12.2 (E), R12.1, U2.14 (1)

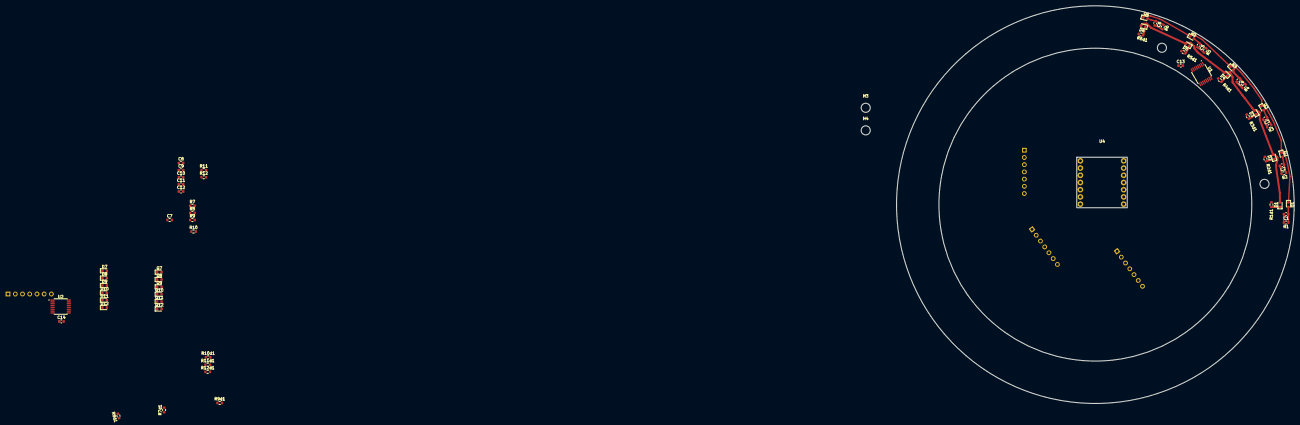
[picture p94: board LineSensor_Block_prot1.kicad_pcb from above]

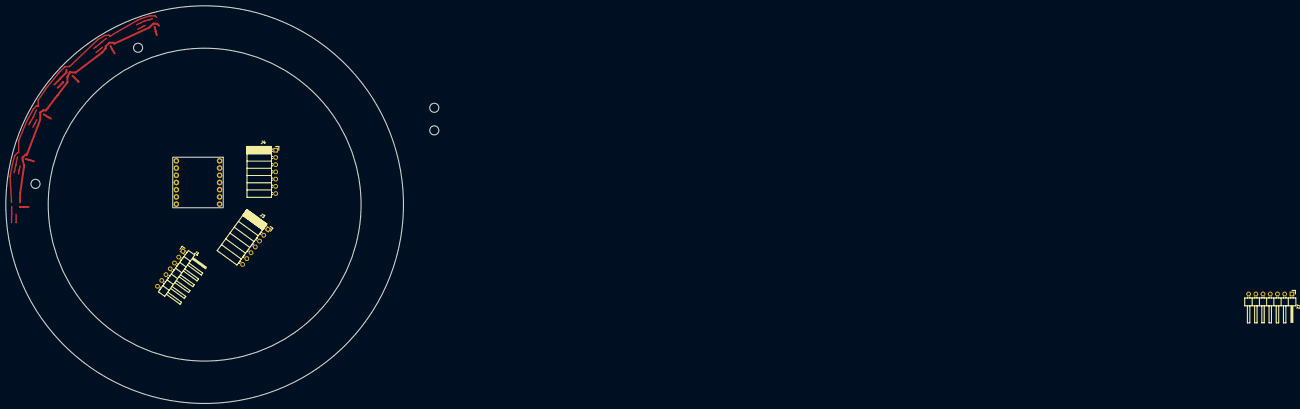
[picture p95: board LineSensor_Block_prot1.kicad_pcb from below]

Board: 2 copper layers, 140.0 x 140.0 mm, 73 parts (4 on the bottom side), 35 nets.
