Tellurnoid/25RoboCup/埼玉ブロック/kiCad/LineSensor_Block_prot2/Sides/LineSensor_Block_prot2/LineSensor_Block_prot2.kicad_pcb

## KiCad design 埼玉ブロック/kiCad/LineSensor_Block_prot2/Sides/LineSensor_Block_prot2/LineSensor_Block_prot2.kicad_pcb (2025-12-28)

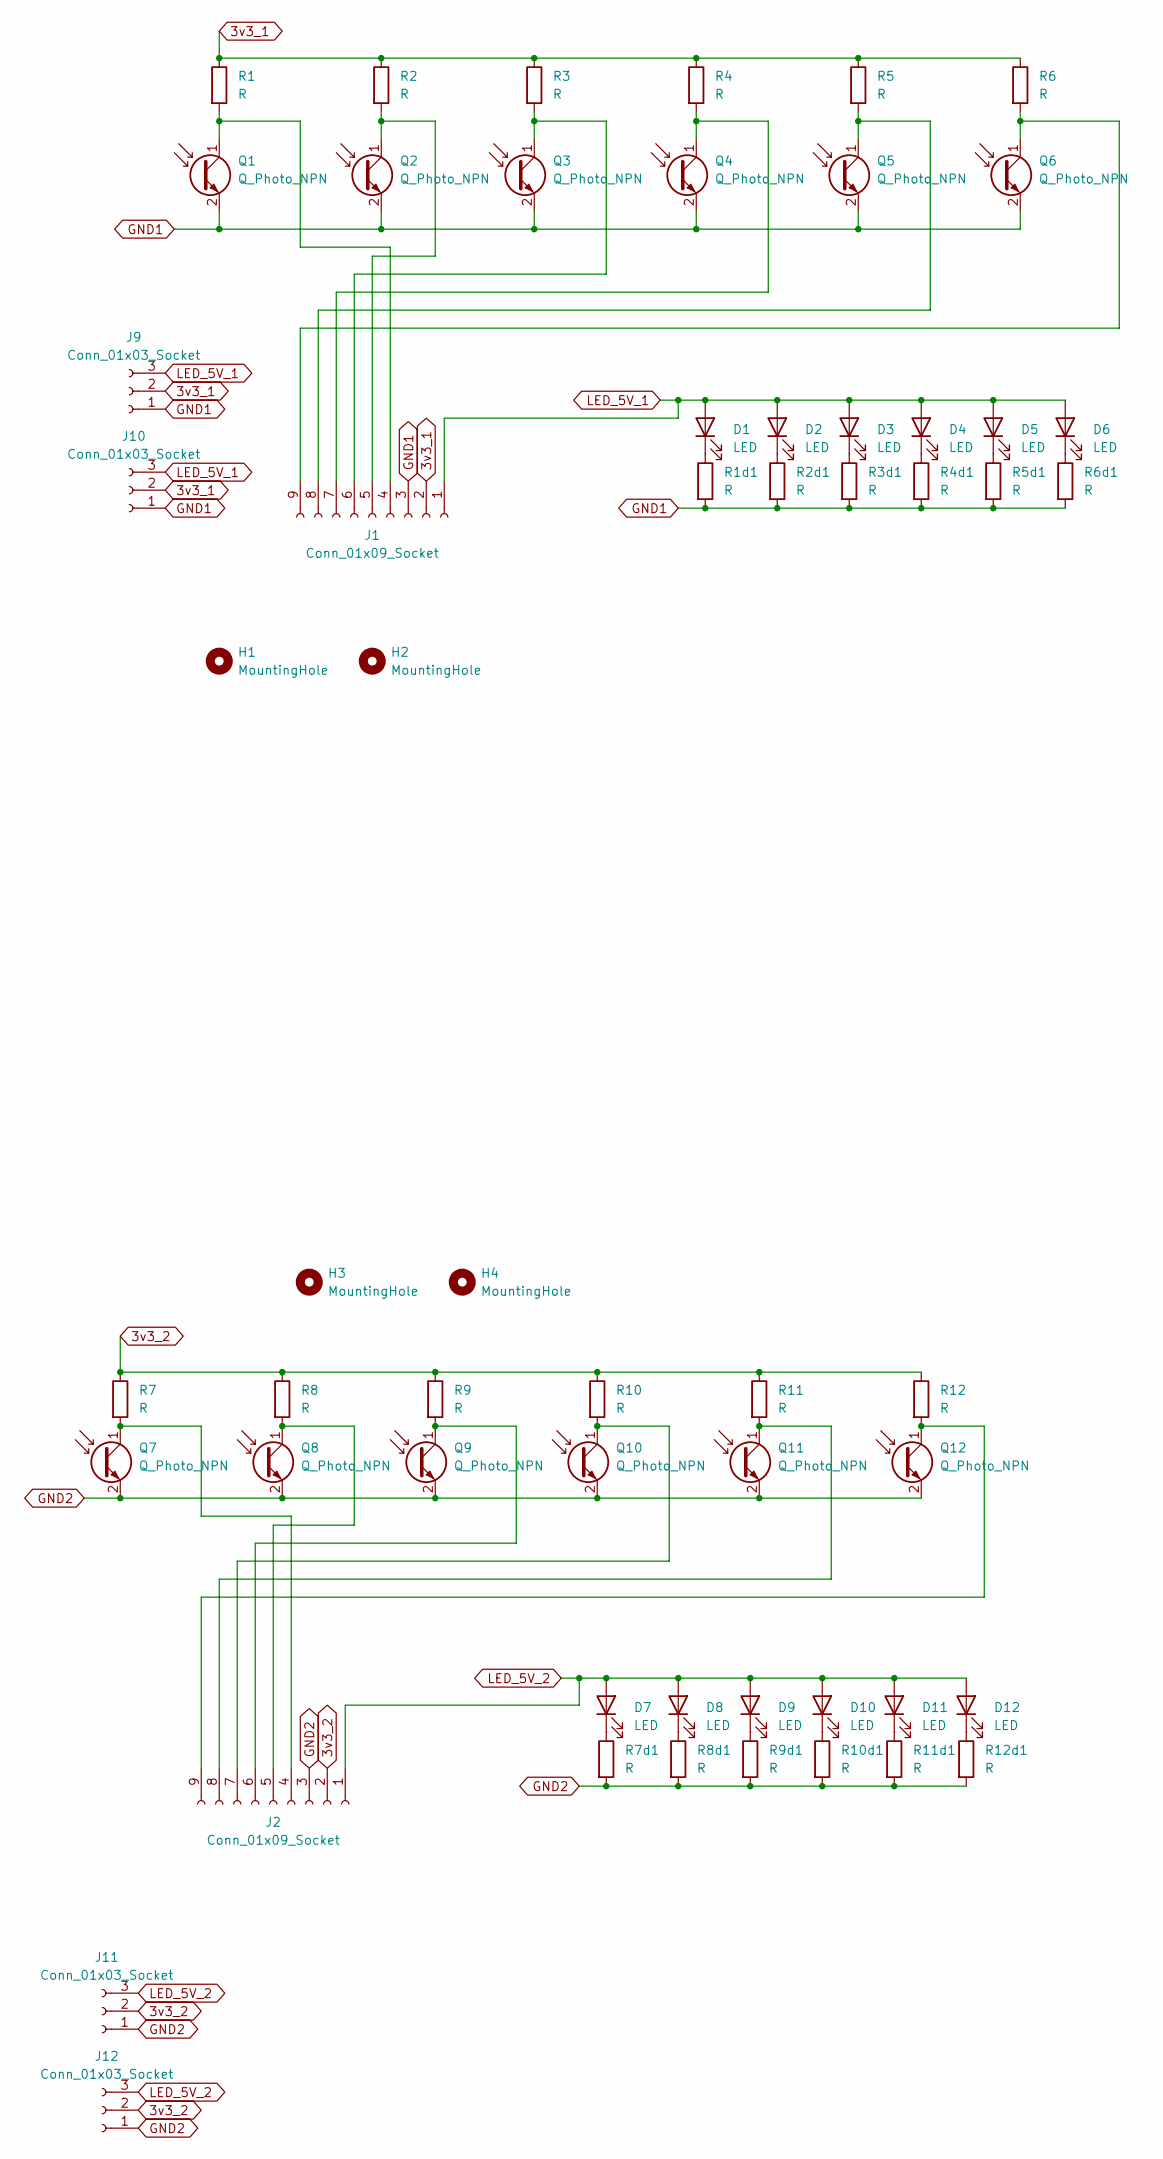
[picture p96: schematic LineSensor_Block_prot2.kicad_sch]

Parts:
D1, D2, D3, D4, D5, D6, D7, D8, D9, D10, D11, D12: LED; LED_0603_1608Metric
H1, H2, H3, H4: MountingHole; MountingHole_3.2mm_M3
J1, J2: Conn_01x09_Socket; PinSocket_1x09_P2.54mm_Horizontal_EDITED
J9, J10, J11, J12: Conn_01x03_Socket; PinHeader_1x03_P2.54mm_Vertical_EDITED
Q1, Q2, Q3, Q4, Q5, Q6, Q7, Q8, Q9, Q10, Q11, Q12: Q_Photo_NPN; LED_0603_1608Metric
R1, R1d1, R2, R2d1, R3, R3d1, R4, R4d1, R5, R5d1, R6, R6d1, R7, R7d1, R8, R8d1, R9, R9d1, R10, R10d1, R11, R11d1, R12, R12d1: R; R_0603_1608Metric

Connections:
3v3_1: J1.2, J9.2, J10.2, R1.1, R2.1, R3.1, R4.1, R5.1, R6.1
3v3_2: J2.2, J11.2, J12.2, R7.1, R8.1, R9.1, R10.1, R11.1, R12.1
GND1: J1.3, J9.1, J10.1, Q1.2 (E), Q2.2 (E), Q3.2 (E), Q4.2 (E), Q5.2 (E), Q6.2 (E), R1d1.2, R2d1.2, R3d1.2, R4d1.2, R5d1.2, R6d1.2
GND2: J2.3, J11.1, J12.1, Q7.2 (E), Q8.2 (E), Q9.2 (E), Q10.2 (E), Q11.2 (E), Q12.2 (E), R7d1.2, R8d1.2, R9d1.2, R10d1.2, R11d1.2, R12d1.2
LED_5V_1: D1.2 (A), D2.2 (A), D3.2 (A), D4.2 (A), D5.2 (A), D6.2 (A), J1.1, J9.3, J10.3
LED_5V_2: D7.2 (A), D8.2 (A), D9.2 (A), D10.2 (A), D11.2 (A), D12.2 (A), J2.1, J11.3, J12.3
unnamed: D1.1 (K), R1d1.1
unnamed: D2.1 (K), R2d1.1
unnamed: D3.1 (K), R3d1.1
unnamed: D4.1 (K), R4d1.1
unnamed: D5.1 (K), R5d1.1
unnamed: D6.1 (K), R6d1.1
unnamed: D7.1 (K), R7d1.1
unnamed: D8.1 (K), R8d1.1
unnamed: D9.1 (K), R9d1.1
unnamed: D10.1 (K), R10d1.1
unnamed: D11.1 (K), R11d1.1
unnamed: D12.1 (K), R12d1.1
unnamed: J1.4, Q1.1 (C), R1.2
unnamed: J1.5, Q2.1 (C), R2.2
unnamed: J1.6, Q3.1 (C), R3.2
unnamed: J1.7, Q4.1 (C), R4.2
unnamed: J1.8, Q5.1 (C), R5.2
unnamed: J1.9, Q6.1 (C), R6.2
unnamed: J2.4, Q7.1 (C), R7.2
unnamed: J2.5, Q8.1 (C), R8.2
unnamed: J2.6, Q9.1 (C), R9.2
unnamed: J2.7, Q10.1 (C), R10.2
unnamed: J2.8, Q11.1 (C), R11.2
unnamed: J2.9, Q12.1 (C), R12.2

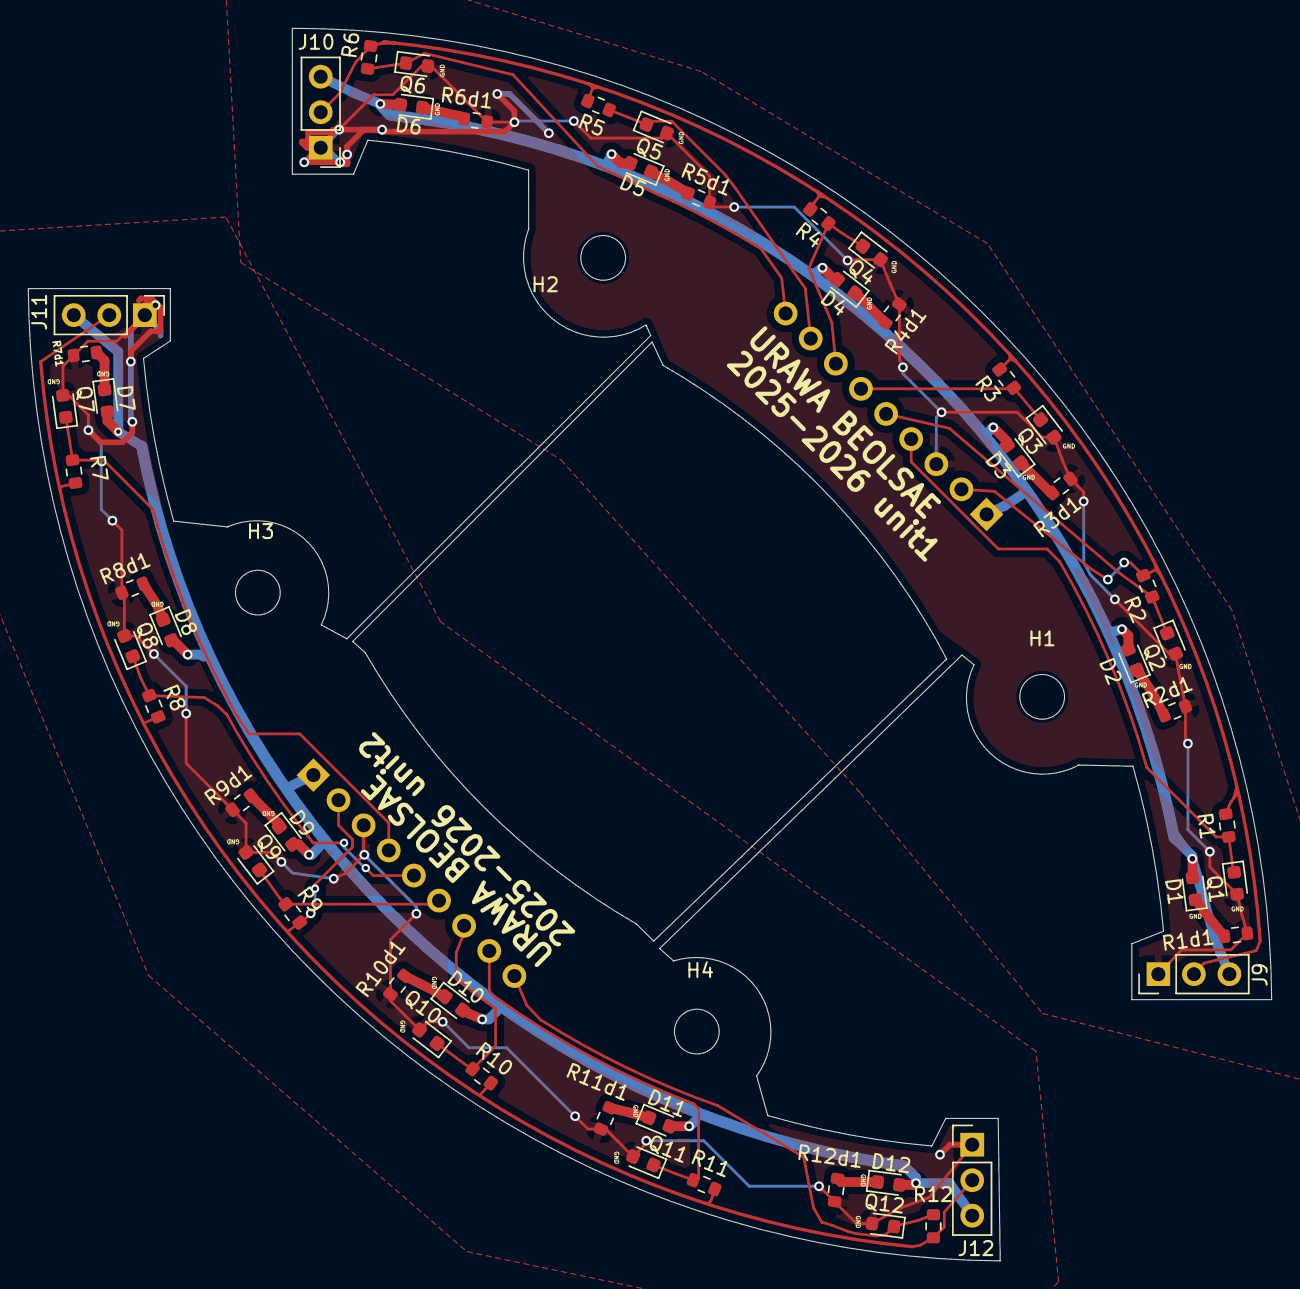
[picture p97: board 埼玉ブロック/kiCad/LineSensor_Block_prot2/Sides/LineSensor_Block_prot2/Line… from above]

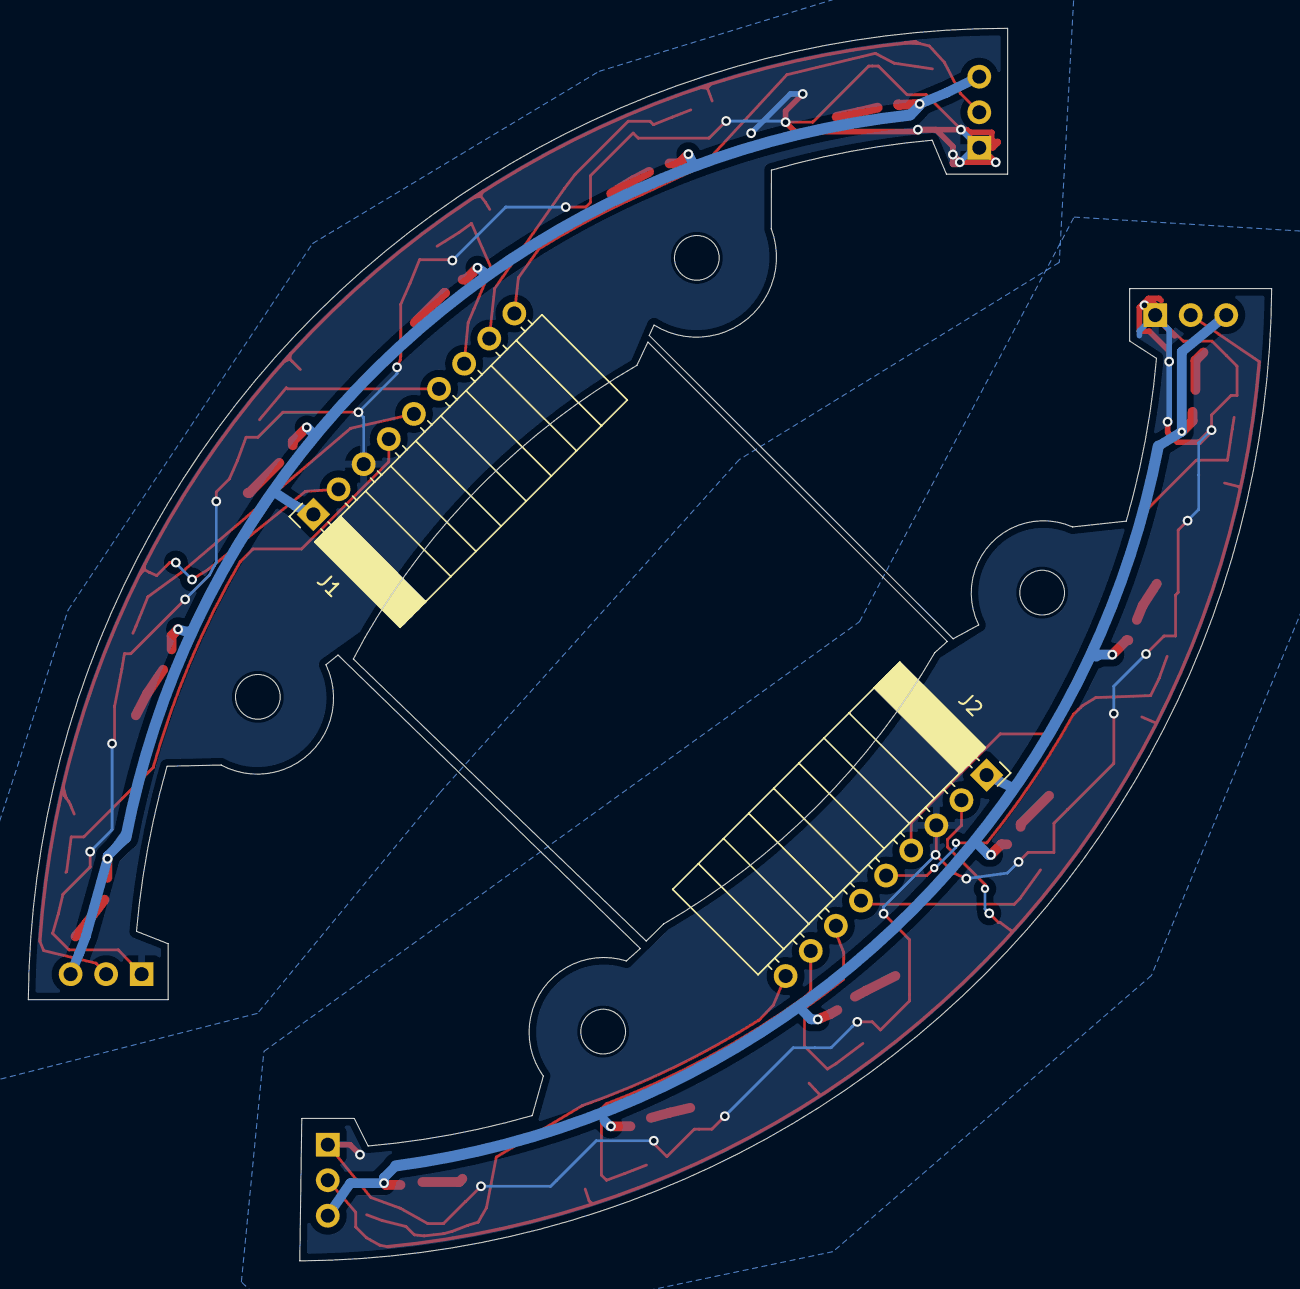
[picture p98: board 埼玉ブロック/kiCad/LineSensor_Block_prot2/Sides/LineSensor_Block_prot2/Line… from below]

Board: 2 copper layers, 88.9 x 88.1 mm, 58 parts (2 on the bottom side), 30 nets.
