Tellurnoid/25RoboCup/埼玉ブロック/kiCad/LineSensor_Block_prot2/origin/LineSensor_Block_prot2/LineSensor_Block_prot2.kicad_pcb

## KiCad design 埼玉ブロック/kiCad/LineSensor_Block_prot2/origin/LineSensor_Block_prot2/LineSensor_Block_prot2.kicad_pcb (2025-12-26)

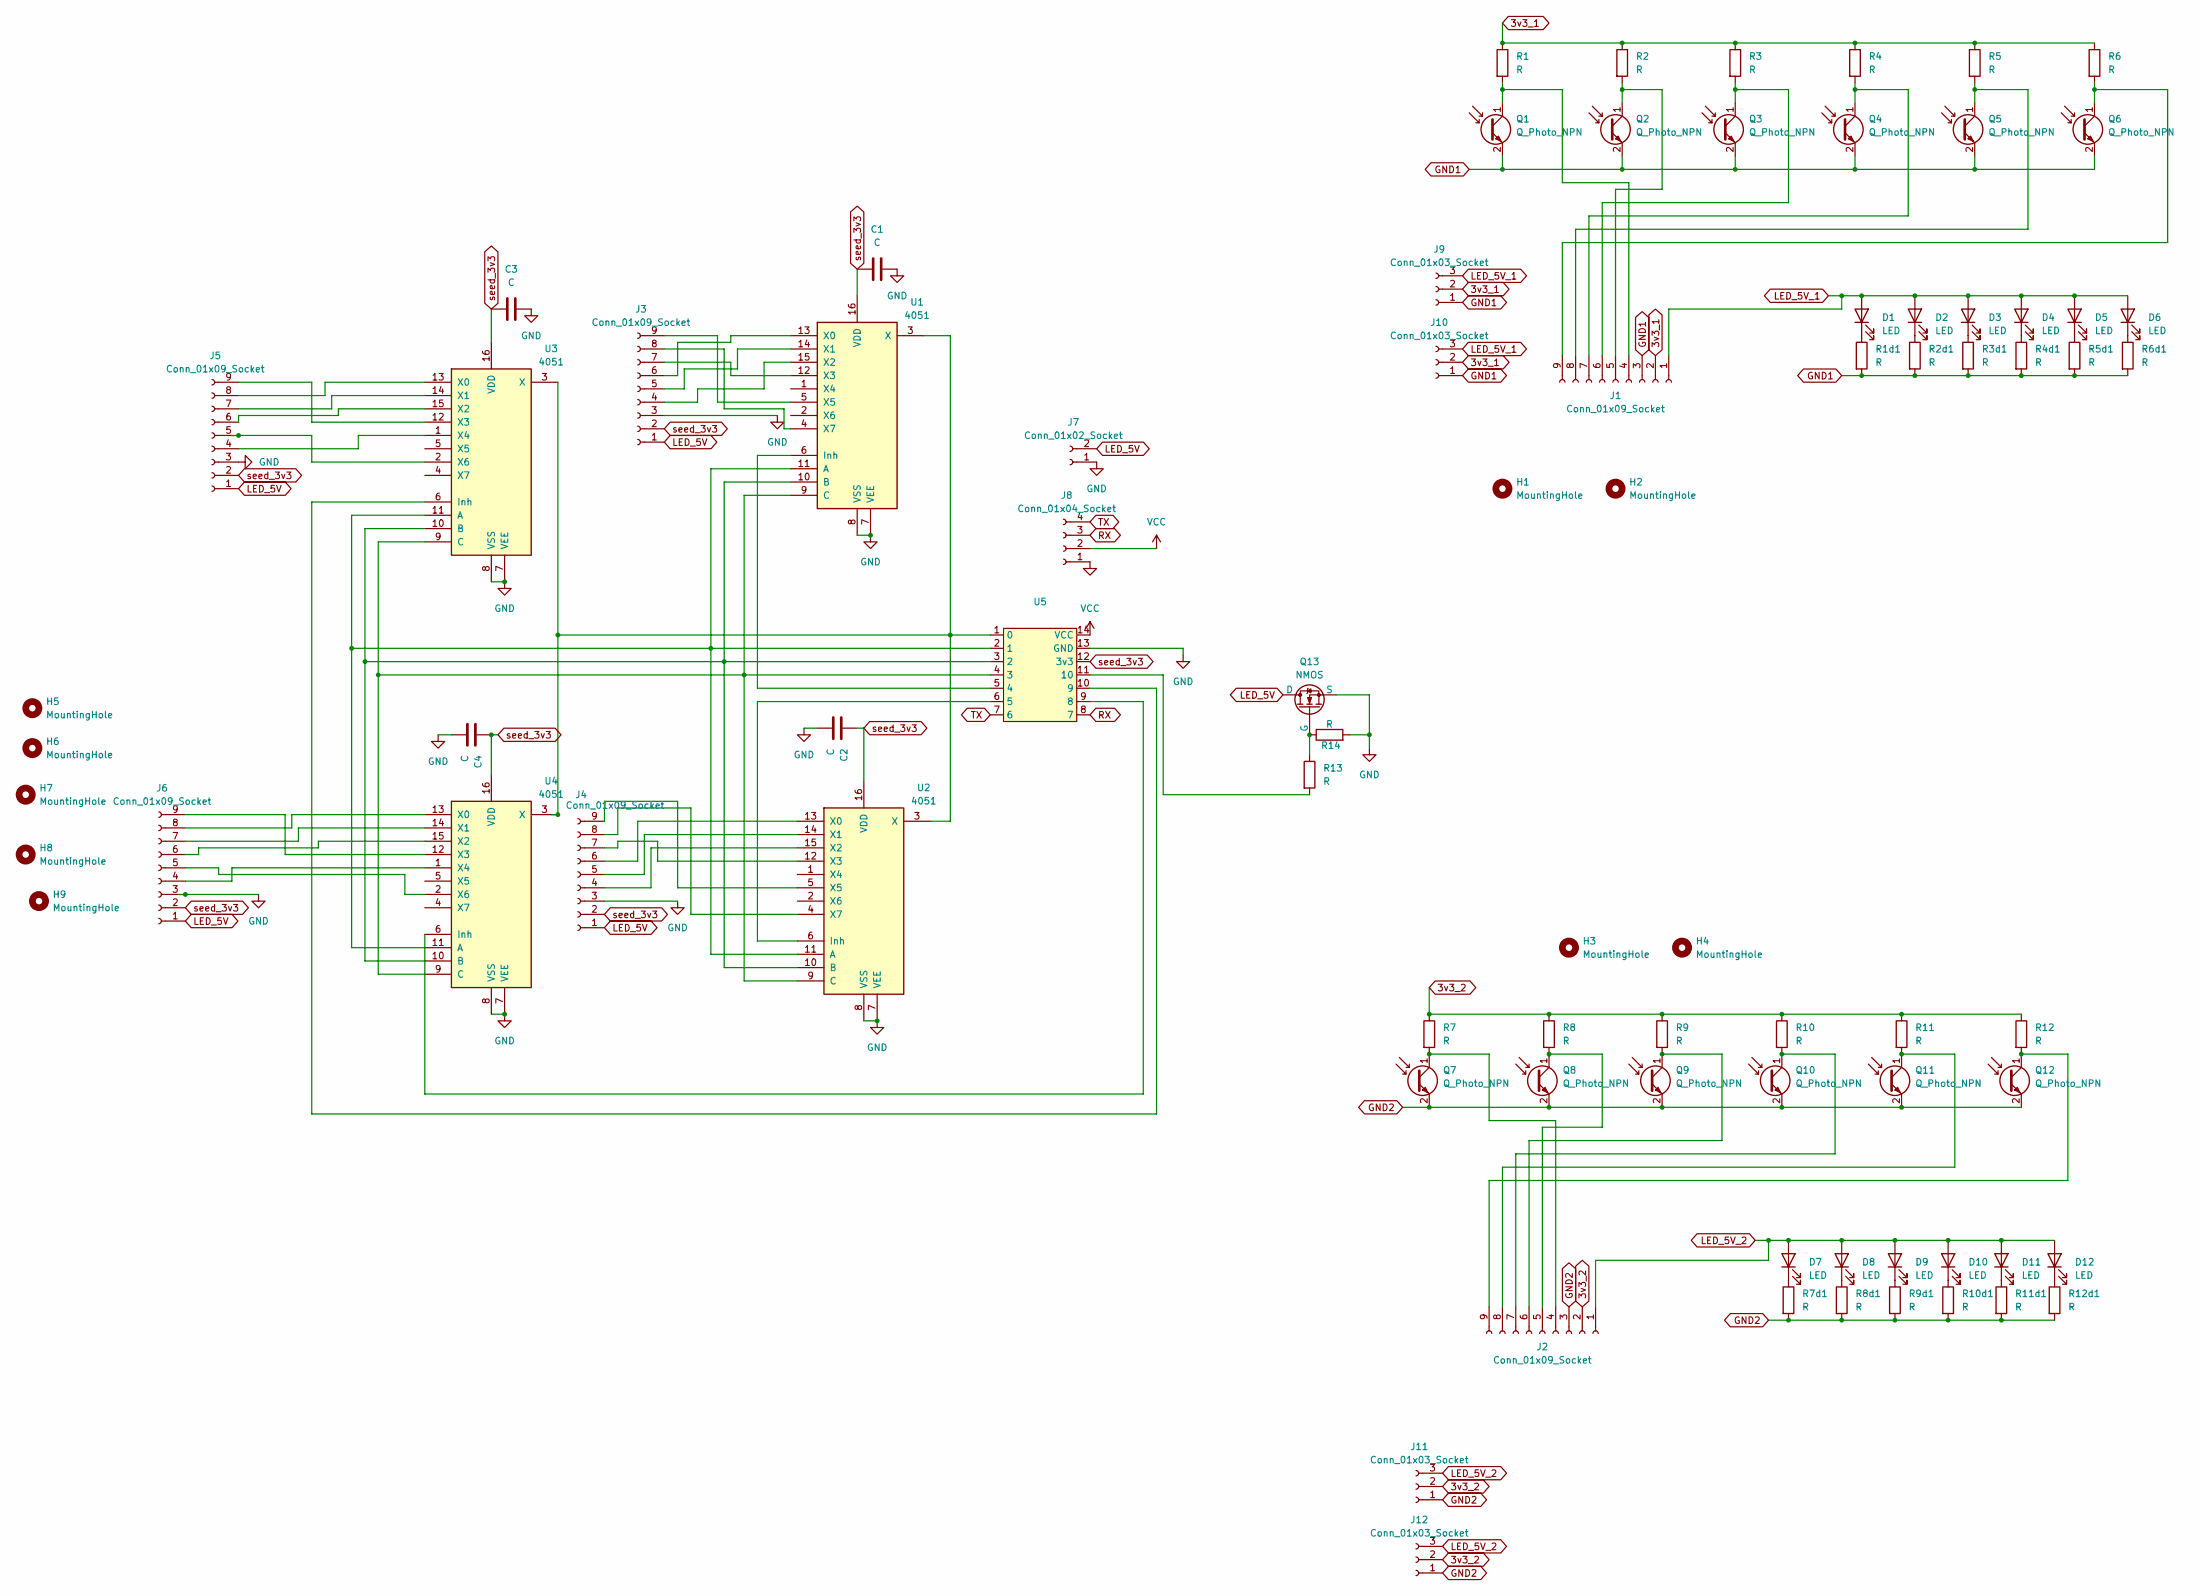
[picture p99: schematic LineSensor_Block_prot2.kicad_sch]

Parts:
C1, C2, C3, C4: C; C_0603_1608Metric
D1, D2, D3, D4, D5, D6, D7, D8, D9, D10, D11, D12: LED; LED_0603_1608Metric
H1, H2, H3, H4, H5, H6, H7, H8, H9: MountingHole; MountingHole_3.2mm_M3
J1, J2: Conn_01x09_Socket; PinSocket_1x09_P2.54mm_Horizontal_EDITED
J3, J4, J5, J6: Conn_01x09_Socket; PinHeader_1x09_P2.54mm_Horizontal_EDITED
J7: Conn_01x02_Socket; JST_XH_S2B-XH-A-1_1x02_P2.50mm_Horizontal
J8: Conn_01x04_Socket; JST_XH_S4B-XH-A-1_1x04_P2.50mm_Horizontal
J9, J10, J11, J12: Conn_01x03_Socket; PinHeader_1x03_P2.54mm_Vertical_EDITED
Q1, Q2, Q3, Q4, Q5, Q6, Q7, Q8, Q9, Q10, Q11, Q12: Q_Photo_NPN; LED_0603_1608Metric
Q13: NMOS; TO-251-3-1EP_Horizontal_TabDown
R1, R1d1, R2, R2d1, R3, R3d1, R4, R4d1, R5, R5d1, R6, R6d1, R7, R7d1, R8, R8d1, R9, R9d1, R10, R10d1, R11, R11d1, R12, R12d1: R; R_0603_1608Metric
R13, R14: R; R_Axial_DIN0207_L6.3mm_D2.5mm_P10.16mm_Horizontal
U1, U2, U3, U4: 4051; CERDIP-16_W7.62mm_SideBrazed_LongPads_pin_EDITED
U5: 名称未設定

Connections:
3v3_1: J1.2, J9.2, J10.2, R1.1, R2.1, R3.1, R4.1, R5.1, R6.1
3v3_2: J2.2, J11.2, J12.2, R7.1, R8.1, R9.1, R10.1, R11.1, R12.1
GND: C1.2, C2.2, C3.2, C4.2, J3.3, J4.3, J5.3, J6.3, J7.1, J8.1, Q13.3 (S), R14.2, U1.7 (VEE), U1.8 (VSS), U2.7 (VEE), U2.8 (VSS), U3.7 (VEE), U3.8 (VSS), U4.7 (VEE), U4.8 (VSS), U5.13 (GND)
GND1: J1.3, J9.1, J10.1, Q1.2 (E), Q2.2 (E), Q3.2 (E), Q4.2 (E), Q5.2 (E), Q6.2 (E), R1d1.2, R2d1.2, R3d1.2, R4d1.2, R5d1.2, R6d1.2
GND2: J2.3, J11.1, J12.1, Q7.2 (E), Q8.2 (E), Q9.2 (E), Q10.2 (E), Q11.2 (E), Q12.2 (E), R7d1.2, R8d1.2, R9d1.2, R10d1.2, R11d1.2, R12d1.2
LED_5V: J3.1, J4.1, J5.1, J6.1, J7.2, Q13.1 (D)
LED_5V_1: D1.2 (A), D2.2 (A), D3.2 (A), D4.2 (A), D5.2 (A), D6.2 (A), J1.1, J9.3, J10.3
LED_5V_2: D7.2 (A), D8.2 (A), D9.2 (A), D10.2 (A), D11.2 (A), D12.2 (A), J2.1, J11.3, J12.3
unnamed: D1.1 (K), R1d1.1
unnamed: D2.1 (K), R2d1.1
unnamed: D3.1 (K), R3d1.1
unnamed: D4.1 (K), R4d1.1
unnamed: D5.1 (K), R5d1.1
unnamed: D6.1 (K), R6d1.1
unnamed: D7.1 (K), R7d1.1
unnamed: D8.1 (K), R8d1.1
unnamed: D9.1 (K), R9d1.1
unnamed: D10.1 (K), R10d1.1
unnamed: D11.1 (K), R11d1.1
unnamed: D12.1 (K), R12d1.1
unnamed: J1.4, Q1.1 (C), R1.2
unnamed: J1.5, Q2.1 (C), R2.2
unnamed: J1.6, Q3.1 (C), R3.2
unnamed: J1.7, Q4.1 (C), R4.2
unnamed: J1.8, Q5.1 (C), R5.2
unnamed: J1.9, Q6.1 (C), R6.2
unnamed: J2.4, Q7.1 (C), R7.2
unnamed: J2.5, Q8.1 (C), R8.2
unnamed: J2.6, Q9.1 (C), R9.2
unnamed: J2.7, Q10.1 (C), R10.2
unnamed: J2.8, Q11.1 (C), R11.2
unnamed: J2.9, Q12.1 (C), R12.2
unnamed: J3.4, U1.15 (X2)
unnamed: J3.5, U1.14 (X1)
unnamed: J3.6, U1.13 (X0)
unnamed: J3.7, U1.12 (X3)
unnamed: J3.8, U1.4 (X7)
unnamed: J3.9, U1.5 (X5)
unnamed: J4.4, U2.15 (X2)
unnamed: J4.5, U2.14 (X1)
unnamed: J4.6, U2.13 (X0)
unnamed: J4.7, U2.12 (X3)
unnamed: J4.8, U2.4 (X7)
unnamed: J4.9, U2.5 (X5)
unnamed: J5.4, U3.1 (X4)
unnamed: J5.5, U3.2 (X6)
unnamed: J5.6, U3.15 (X2)
unnamed: J5.7, U3.14 (X1)
unnamed: J5.8, U3.13 (X0)
unnamed: J5.9, U3.12 (X3)
unnamed: J6.4, U4.1 (X4)
unnamed: J6.5, U4.2 (X6)
unnamed: J6.6, U4.15 (X2)
unnamed: J6.7, U4.14 (X1)
unnamed: J6.8, U4.13 (X0)
unnamed: J6.9, U4.12 (X3)
unnamed: Q13.2 (G), R13.1, R14.1
unnamed: U1.11 (A), U2.11 (A), U3.11 (A), U4.11 (A), U5.2 (1)
unnamed: U1.10 (B), U2.10 (B), U3.10 (B), U4.10 (B), U5.3 (2)
unnamed: U1.9 (C), U2.9 (C), U3.9 (C), U4.9 (C), U5.4 (3)
unnamed: U1.6 (Inh), U5.5 (4)
unnamed: U1.3 (X), U2.3 (X), U3.3 (X), U4.3 (X), U5.1 (0)
unnamed: U2.6 (Inh), U5.6 (5)
unnamed: U3.6 (Inh), U5.10 (9)
unnamed: U4.6 (Inh), U5.9 (8)
unnamed: R13.2, U5.11 (10)
RX: J8.3, U5.8 (7)
TX: J8.4, U5.7 (6)
VCC: J8.2, U5.14 (VCC)
seed_3v3: C1.1, C2.1, C3.1, C4.1, J3.2, J4.2, J5.2, J6.2, U1.16 (VDD), U2.16 (VDD), U3.16 (VDD), U4.16 (VDD), U5.12 (3v3)
