Tellurnoid/25RoboCup/埼玉ブロック/kiCad/LineSensor_Block_prot2/origin/LineSensor_Block_prot2/LineSensor_Block_prot2.kicad_pcb

## KiCad design 埼玉ブロック/kiCad/LineSensor_Block_prot2/origin/LineSensor_Block_prot2/LineSensor_Block_prot2.kicad_pcb (continued)

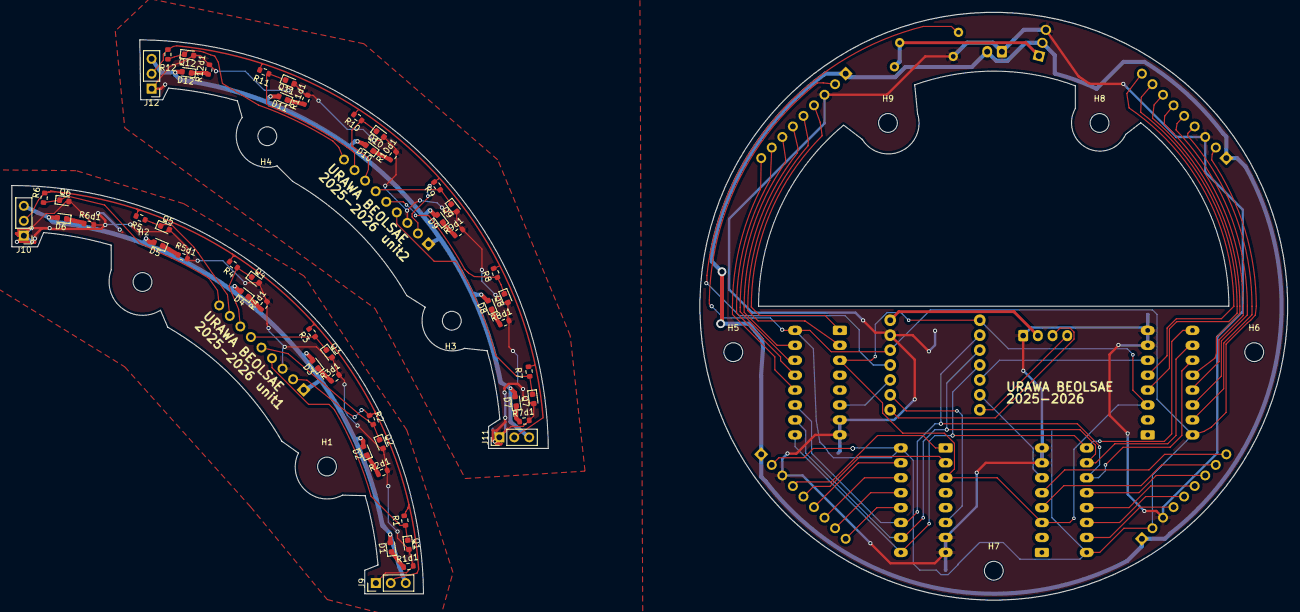
[picture p100: board 埼玉ブロック/kiCad/LineSensor_Block_prot2/origin/LineSensor_Block_prot2/Lin… from above]

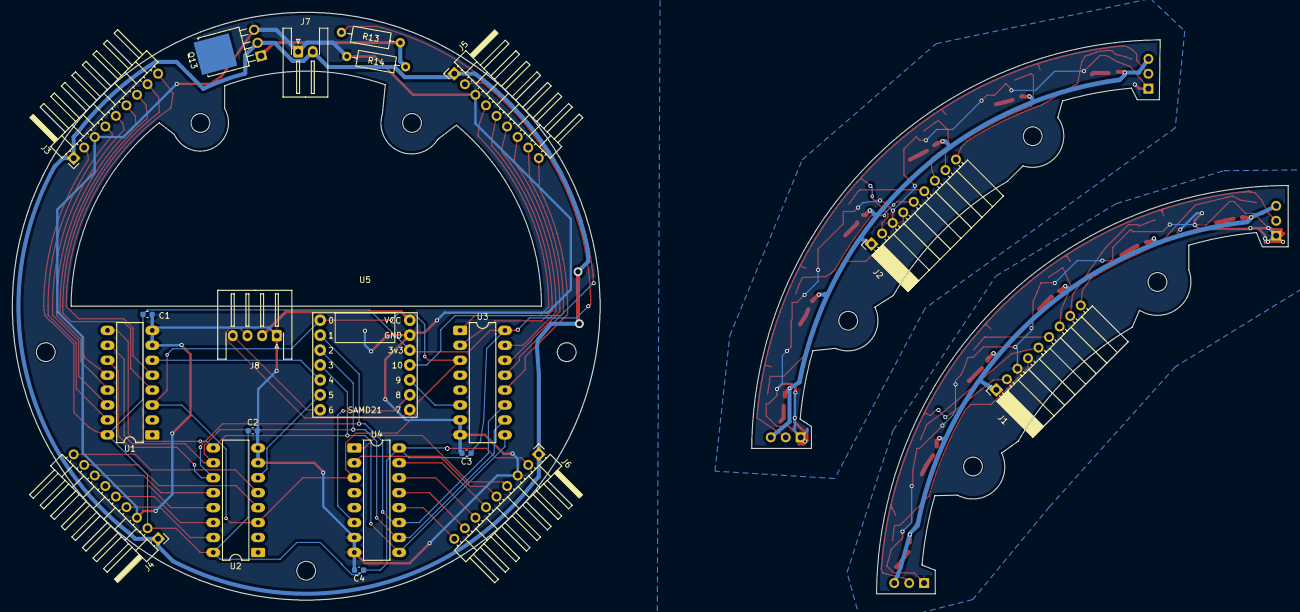
[picture p101: board 埼玉ブロック/kiCad/LineSensor_Block_prot2/origin/LineSensor_Block_prot2/Lin… from below]

Board: 2 copper layers, 217.1 x 100.0 mm, 81 parts (20 on the bottom side), 70 nets.
