Tellurnoid/25RoboCup/埼玉ブロック/ブラウン管MTD/Robocupmtd/Robocupmtd.kicad_pcb

## KiCad design 埼玉ブロック/ブラウン管MTD/Robocupmtd/Robocupmtd.kicad_pcb (2026-01-24)

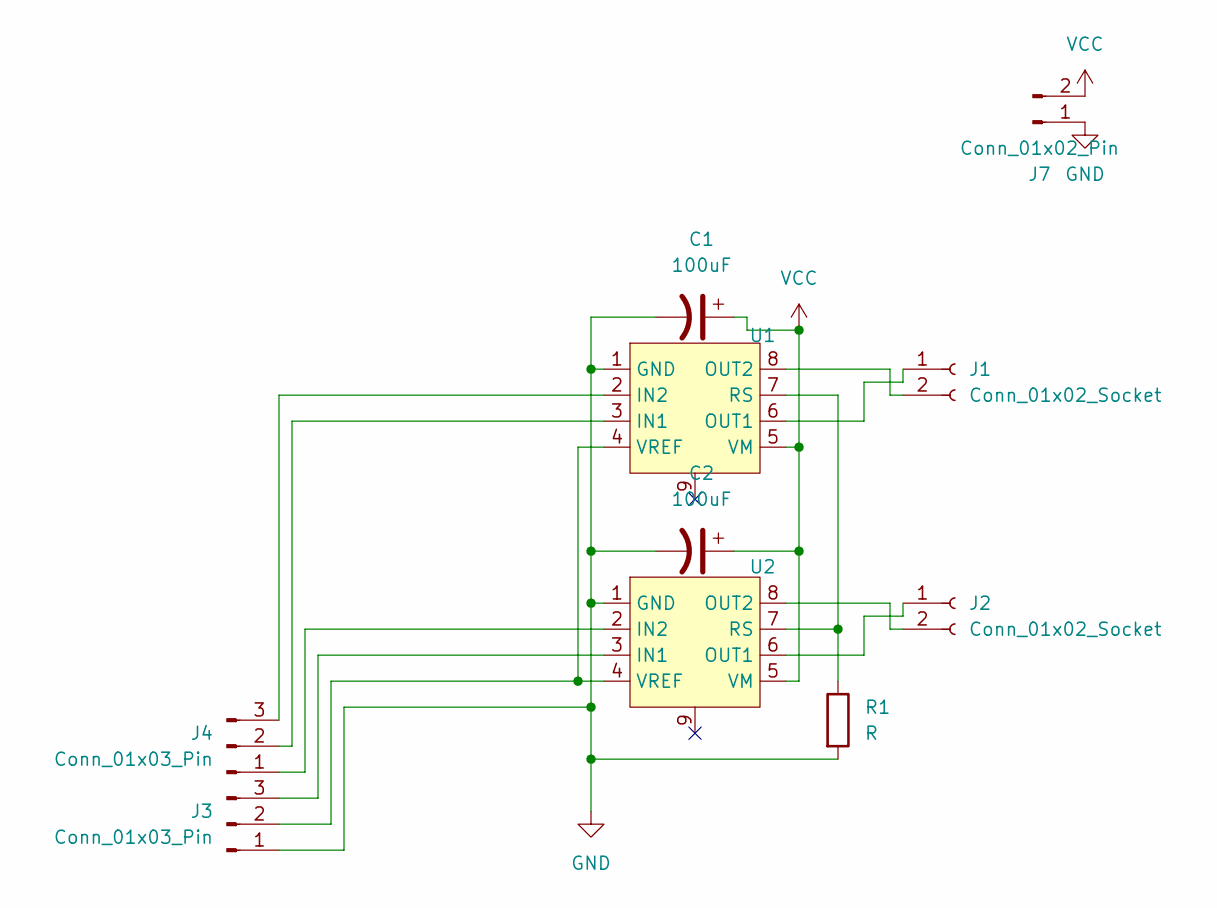
[picture p102: schematic Robocupmtd.kicad_sch]

Parts:
C1, C2: 100uF; CP_Radial_D6.3mm_P2.50mm
J1, J2: Conn_01x02_Socket; JST_XH_B2B-XH-A_1x02_P2.50mm_Vertical
J3, J4: Conn_01x03_Pin; JST_XH_B3B-XH-A_1x03_P2.50mm_Vertical
J7: Conn_01x02_Pin; AMASS_XT30U-M_1x02_P5.0mm_Vertical
R1: R; R_Axial_DIN0207_L6.3mm_D2.5mm_P10.16mm_Horizontal
U1, U2: Texas_HSOP-8-1EP_3.9x4.9mm_P1.27mm

Connections:
GND: C1.2, C2.2, J3.1, J7.1, R1.2, U1.1 (GND), U2.1 (GND)
unnamed: J1.1, U1.6 (OUT1)
unnamed: J1.2, U1.8 (OUT2)
unnamed: J2.1, U2.6 (OUT1)
unnamed: J2.2, U2.8 (OUT2)
unnamed: J3.2, U1.4 (VREF), U2.4 (VREF)
unnamed: J3.3, U2.3 (IN1)
unnamed: J4.1, U2.2 (IN2)
unnamed: J4.2, U1.3 (IN1)
unnamed: J4.3, U1.2 (IN2)
unnamed: R1.1, U1.7 (RS), U2.7 (RS)
VCC: C1.1, C2.1, J7.2, U1.5 (VM), U2.5 (VM)

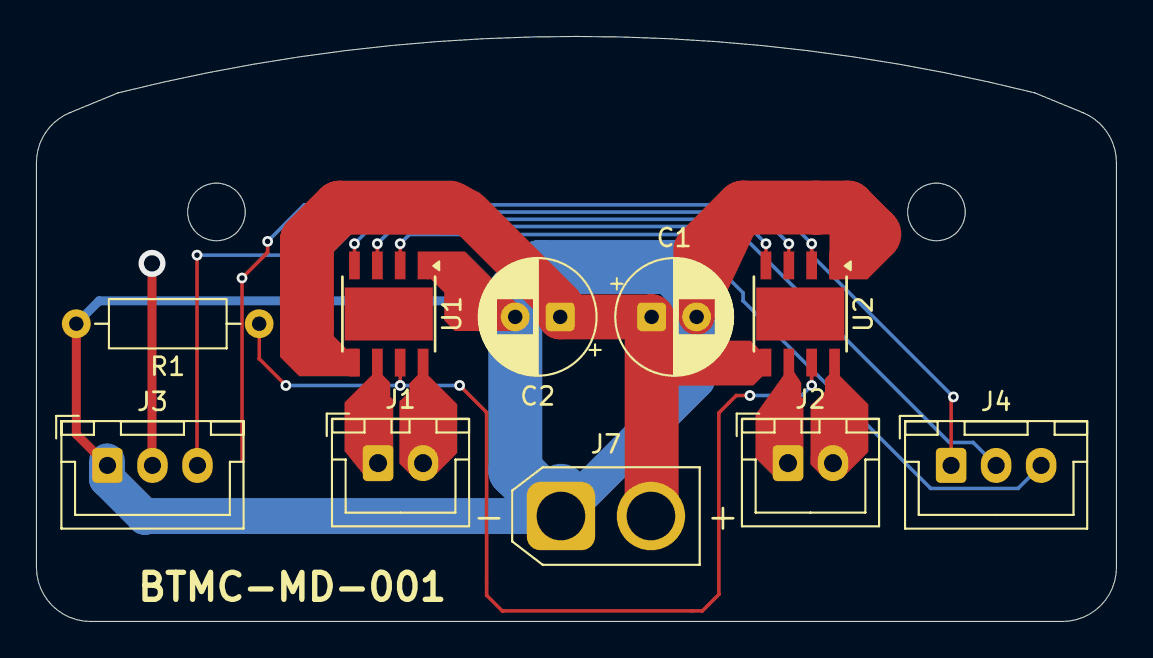
[picture p103: board Robocupmtd.kicad_pcb from above]

Board: 2 copper layers, 60.0 x 32.5 mm, 10 parts (0 on the bottom side), 12 nets.
