Tellurnoid/25RoboCup/北埼玉ノード/kiCad/地下鉄/LineSensor_Prot3/LineSensor.kicad_pcb

## KiCad design 北埼玉ノード/kiCad/地下鉄/LineSensor_Prot3/LineSensor.kicad_pcb (2025-11-19)

Schematic: LineSensor.kicad_sch

Parts:
A1: Arduino_Nano_v2.x; Arduino_Nano
C2: C; CP_Radial_D5.0mm_P2.50mm
C3: C; C_Disc_D7.5mm_W2.5mm_P5.00mm
C4, C5, C6, C7, C8, C9, C10, C11: C; C_0603_1608Metric
D34, D35, D36, D37, D38, D39, D40, D41, D42, D43, D44, D45, D46, D47, D48, D49: LED; LED_0603_1608Metric
J1: Conn_01x04_Socket; PinSocket_1x04_P2.54mm_Vertical
J2: Conn_01x02_Socket; PinSocket_1x02_P2.54mm_Vertical
Q1, Q2, Q3, Q4, Q5, Q6, Q7, Q8, Q9, Q10, Q11, Q12, Q13, Q14, Q15, Q16: Q_Photo_NPN; NJL7502R
Q17: NMOS; TO-251-3-1EP_Horizontal_TabDown
R1, R2, R3, R4, R5, R6, R7, R8, R9, R10, R11, R12, R13, R14, R15, R16, R17, R18, R19, R20, R21, R22, R23, R24, R25, R26, R27, R28, R29, R30, R31, R32, R33, R34, R35, R36, R37, R38, R39, R40, R41, R42, R43, R44, R45, R46, R55, R56: R; R_0603_1608Metric_Pad0.98x0.95mm_HandSolder
R49, R50, R51, R84, R85: R; R_Axial_DIN0207_L6.3mm_D2.5mm_P7.62mm_Horizontal
RV1, RV2, RV3, RV4: R_Potentiometer_Trim; PinHeader_1x03_P2.54mm_Vertical
SW2: SW_DPST_x2; PinSocket_1x03_P2.54mm_Vertical
U2, U3, U4, U5, U6, U7, U8, U9: LM393; SOIC-8_3.9x4.9mm_P1.27mm

Connections:
GND: A1.4 (GND), A1.29 (GND), C2.1, C3.2, C4.2, C5.2, C6.2, C7.2, C8.2, C9.2, C10.2, C11.2, J1.3, J2.2, Q17.3 (S), R1.2, R2.2, R3.2, R4.2, R9.2, R10.2, R11.2, R12.2, R13.2, R14.2, R15.2, R16.2, R17.2, R18.2, R19.2, R20.2, R50.2, R85.1, RV1.3, RV2.3, RV3.3, RV4.3, U2.4 (V-), U3.4 (V-), U4.4 (V-), U5.4 (V-), U6.4 (V-), U7.4 (V-), U8.4 (V-), U9.4 (V-)
unnamed: A1.19 (A0), R25.2, U8.7
unnamed: A1.20 (A1), R26.2, U8.1
unnamed: A1.21 (A2), R27.2, U7.7
unnamed: A1.22 (A3), R28.2, U7.1
unnamed: A1.23 (A4), R32.2, U2.7
unnamed: A1.2 (D0/RX), J1.2
unnamed: A1.1 (D1/TX), R49.2
unnamed: A1.5 (D2), R21.2, U6.7
unnamed: A1.6 (D3), R22.2, U6.1
unnamed: A1.7 (D4), R23.2, U5.7
unnamed: A1.8 (D5), R24.2, U5.1
unnamed: A1.9 (D6), R8.2, U3.1
unnamed: A1.10 (D7), R7.2, U3.7
unnamed: A1.11 (D8), R6.2, U4.1
unnamed: A1.12 (D9), R5.2, U4.7
unnamed: A1.13 (D10), R84.1
unnamed: A1.14 (D11), R29.2, U9.1
unnamed: A1.15 (D12), R30.2, U9.7
unnamed: A1.16 (D13), R31.2, U2.1
unnamed: D34.1 (K), R55.1
unnamed: D35.1 (K), R56.1
unnamed: D36.1 (K), R40.1
unnamed: D37.1 (K), R41.1
unnamed: D38.1 (K), R42.1
unnamed: D39.1 (K), R43.1
unnamed: D40.1 (K), R44.1
unnamed: D41.1 (K), R45.1
unnamed: D42.1 (K), R46.1
unnamed: D43.1 (K), R39.1
unnamed: D44.1 (K), R38.1
unnamed: D45.1 (K), R37.1
unnamed: D46.1 (K), R36.1
unnamed: D47.1 (K), R35.1
unnamed: D48.1 (K), R34.1
unnamed: D49.1 (K), R33.1
unnamed: J1.1, R49.1, R51.1
unnamed: J2.1, SW2.2 (B)
unnamed: Q1.2 (E), R4.1, U3.2 (-)
unnamed: Q2.2 (E), R3.1, U3.6 (-)
unnamed: Q3.2 (E), R2.1, U4.2 (-)
unnamed: Q4.2 (E), R1.1, U4.6 (-)
unnamed: Q5.2 (E), R13.1, U7.2 (-)
unnamed: Q6.2 (E), R14.1, U7.6 (-)
unnamed: Q7.2 (E), R15.1, U8.2 (-)
unnamed: Q8.2 (E), R16.1, U8.6 (-)
unnamed: Q9.2 (E), R9.1, U6.6 (-)
unnamed: Q10.2 (E), R10.1, U6.2 (-)
unnamed: Q11.2 (E), R11.1, U5.6 (-)
unnamed: Q12.2 (E), R12.1, U5.2 (-)
unnamed: Q13.2 (E), R17.1, U9.3 (+)
unnamed: Q14.2 (E), R18.1, U9.5 (+)
unnamed: Q15.2 (E), R19.1, U2.2 (-)
unnamed: Q16.2 (E), R20.1, U2.6 (-)
unnamed: Q17.1 (D), R33.2, R34.2, R35.2, R36.2, R37.2, R38.2, R39.2, R40.2, R41.2, R42.2, R43.2, R44.2, R45.2, R46.2, R55.2, R56.2
unnamed: Q17.2 (G), R84.2, R85.2
unnamed: R50.1, R51.2
unnamed: RV4.2, U2.3 (+), U2.5 (+), U9.2 (-), U9.6 (-)
unnamed: RV1.2, U3.3 (+), U3.5 (+), U4.3 (+), U4.5 (+)
unnamed: RV2.2, U5.3 (+), U5.5 (+), U6.3 (+), U6.5 (+)
unnamed: RV3.2, U7.3 (+), U7.5 (+), U8.3 (+), U8.5 (+)
VCC: A1.27 (+5V), C2.2, C3.1, C4.1, C5.1, C6.1, C7.1, C8.1, C9.1, C10.1, C11.1, D34.2 (A), D35.2 (A), D36.2 (A), D37.2 (A), D38.2 (A), D39.2 (A), D40.2 (A), D41.2 (A), D42.2 (A), D43.2 (A), D44.2 (A), D45.2 (A), D46.2 (A), D47.2 (A), D48.2 (A), D49.2 (A), J1.4, Q1.1 (C), Q2.1 (C), Q3.1 (C), Q4.1 (C), Q5.1 (C), Q6.1 (C), Q7.1 (C), Q8.1 (C), Q9.1 (C), Q10.1 (C), Q11.1 (C), Q12.1 (C), Q13.1 (C), Q14.1 (C), Q15.1 (C), Q16.1 (C), R5.1, R6.1, R7.1, R8.1, R21.1, R22.1, R23.1, R24.1, R25.1, R26.1, R27.1, R28.1, R29.1, R30.1, R31.1, R32.1, RV1.1, RV2.1, RV3.1, RV4.1, SW2.1 (A), U2.8 (V+), U3.8 (V+), U4.8 (V+), U5.8 (V+), U6.8 (V+), U7.8 (V+), U8.8 (V+), U9.8 (V+)

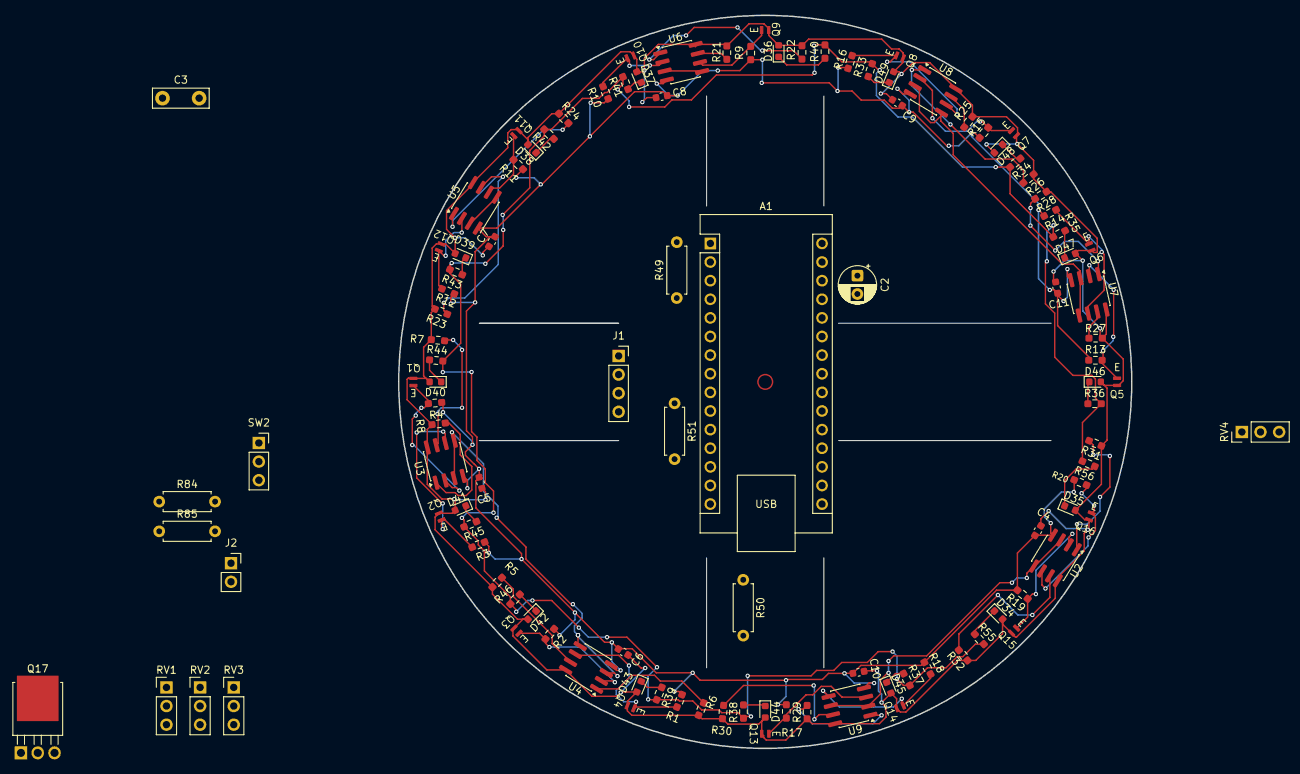
[picture p104: board 北埼玉ノード/kiCad/地下鉄/LineSensor_Prot3/LineSensor.kicad_pcb from above]

Board: 2 copper layers, 100.0 x 100.0 mm, 112 parts (0 on the bottom side), 62 nets.
