Tellurnoid/25RoboCup/北埼玉ノード/kiCad/地下鉄/LineSensor_Prot2(集合抵抗使用)/LineSensor.kicad_pcb

## KiCad design 北埼玉ノード/kiCad/地下鉄/LineSensor_Prot2(集合抵抗使用)/LineSensor.kicad_pcb (2025-11-04)

Schematic: LineSensor.kicad_sch

Parts:
A1: Arduino_Nano_v2.x; Arduino_Nano
C2: C; CP_Radial_Tantal_D5.0mm_P5.00mm
C3: C; C_Radial_D6.3mm_H11.0mm_P2.50mm
C4, C5, C6, C7, C8, C9, C10, C11: C; C_0603_1608Metric
D17: D; D_DO-201AD_P12.70mm_Horizontal
D18, D19, D20, D21, D22, D23, D24, D25, D26, D27, D28, D29, D30, D31, D32, D33, D34, D35, D36, D37, D38, D39, D40, D41, D42, D43, D44, D45, D46, D47, D48, D49: LED; LED_0603_1608Metric
J1: Conn_01x04_Socket; PinSocket_1x04_P2.54mm_Vertical
J2: Conn_01x02_Socket; PinSocket_1x02_P2.54mm_Vertical
Q1, Q2, Q3, Q4, Q5, Q6, Q7, Q8, Q9, Q10, Q11, Q12, Q13, Q14, Q15, Q16: Q_Photo_NPN; LED_0603_1608Metric
Q17: NMOS; TO-251-3-1EP_Horizontal_TabDown
R49, R50, R51, R84, R85: R; R_Axial_DIN0207_L6.3mm_D2.5mm_P7.62mm_Horizontal
RN1, RN2, RN3, RN4, RN5, RN6, RN7, RN8, RN9, RN10, RN11, RN12, RN13, RN14, RN15, RN16: R_Network04; R_Array_Convex_4x1206
RV1, RV2, RV3, RV4: R_Potentiometer_Trim; PinHeader_1x03_P2.54mm_Vertical
SW2: SW_DPST_x2; PinSocket_1x03_P2.54mm_Vertical
U1, U2, U3, U4, U5, U6, U7, U8, U9: LM393; SOIC-8_3.9x4.9mm_P1.27mm

Connections:
GND: A1.4 (GND), A1.29 (GND), C2.1, C3.2, C4.2, C5.2, C6.2, C7.2, C8.2, C9.2, C10.2, C11.2, D17.1 (K), J1.3, J2.2, Q17.3 (S), R50.2, R85.1, RN13.1 (common), RN14.1 (common), RN15.1 (common), RN16.1 (common), RV1.3, RV2.3, RV3.3, RV4.3, U2.8 (V+), U3.8 (V+), U4.8 (V+), U5.8 (V+), U6.4 (V-), U7.4 (V-), U8.4 (V-), U9.4 (V-)
unnamed: A1.19 (A0), RN10.5 (R4), U8.7
unnamed: A1.20 (A1), RN10.4 (R3), U8.1
unnamed: A1.21 (A2), RN10.3 (R2), U7.7
unnamed: A1.22 (A3), RN10.2 (R1), U7.1
unnamed: A1.23 (A4), RN9.5 (R4), U2.7
unnamed: A1.2 (D0/RX), J1.2
unnamed: A1.1 (D1/TX), R49.2
unnamed: A1.5 (D2), RN11.2 (R1), U6.7
unnamed: A1.6 (D3), RN11.3 (R2), U6.1
unnamed: A1.7 (D4), RN11.4 (R3), U5.7
unnamed: A1.8 (D5), RN11.5 (R4), U5.1
unnamed: A1.9 (D6), RN12.2 (R1), U3.1
unnamed: A1.10 (D7), RN12.3 (R2), U3.7
unnamed: A1.11 (D8), RN12.4 (R3), U4.1
unnamed: A1.12 (D9), RN12.5 (R4), U4.7
unnamed: A1.13 (D10), R84.1
unnamed: A1.14 (D11), RN9.2 (R1), U1.1
unnamed: A1.15 (D12), RN9.3 (R2), U1.7
unnamed: A1.16 (D13), RN9.4 (R3), U2.1
unnamed: D18.1 (K), RN1.5 (R4)
unnamed: D19.1 (K), RN1.4 (R3)
unnamed: D20.1 (K), RN1.3 (R2)
unnamed: D21.1 (K), RN1.2 (R1)
unnamed: D22.1 (K), RN2.5 (R4)
unnamed: D23.1 (K), RN2.4 (R3)
unnamed: D24.1 (K), RN2.3 (R2)
unnamed: D25.1 (K), RN2.2 (R1)
unnamed: D26.1 (K), RN3.5 (R4)
unnamed: D27.1 (K), RN3.4 (R3)
unnamed: D28.1 (K), RN3.3 (R2)
unnamed: D29.1 (K), RN3.2 (R1)
unnamed: D30.1 (K), RN4.5 (R4)
unnamed: D31.1 (K), RN4.4 (R3)
unnamed: D32.1 (K), RN4.3 (R2)
unnamed: D33.1 (K), RN4.2 (R1)
unnamed: D34.1 (K), RN5.5 (R4)
unnamed: D35.1 (K), RN5.4 (R3)
unnamed: D36.1 (K), RN5.3 (R2)
unnamed: D37.1 (K), RN5.2 (R1)
unnamed: D38.1 (K), RN6.5 (R4)
unnamed: D39.1 (K), RN6.4 (R3)
unnamed: D40.1 (K), RN6.3 (R2)
unnamed: D41.1 (K), RN6.2 (R1)
unnamed: D42.1 (K), RN7.5 (R4)
unnamed: D43.1 (K), RN7.4 (R3)
unnamed: D44.1 (K), RN7.3 (R2)
unnamed: D45.1 (K), RN7.2 (R1)
unnamed: D46.1 (K), RN8.5 (R4)
unnamed: D47.1 (K), RN8.4 (R3)
unnamed: D48.1 (K), RN8.3 (R2)
unnamed: D49.1 (K), RN8.2 (R1)
unnamed: J1.1, R49.1, R51.1
unnamed: J2.1, SW2.2 (B)
unnamed: Q1.2 (E), RN15.5 (R4), U3.3 (+)
unnamed: Q2.2 (E), RN15.4 (R3), U3.5 (+)
unnamed: Q3.2 (E), RN15.3 (R2), U4.3 (+)
unnamed: Q4.2 (E), RN15.2 (R1), U4.5 (+)
unnamed: Q5.2 (E), RN13.2 (R1), U8.6 (-)
unnamed: Q6.2 (E), RN13.3 (R2), U8.2 (-)
unnamed: Q7.2 (E), RN13.4 (R3), U7.6 (-)
unnamed: Q8.2 (E), RN13.5 (R4), U7.2 (-)
unnamed: Q9.2 (E), RN16.5 (R4), U6.5 (+)
unnamed: Q10.2 (E), RN16.4 (R3), U6.3 (+)
unnamed: Q11.2 (E), RN16.3 (R2), U5.5 (+)
unnamed: Q12.2 (E), RN16.2 (R1), U5.3 (+)
unnamed: Q13.2 (E), RN14.5 (R4), U1.3 (+)
unnamed: Q14.2 (E), RN14.4 (R3), U1.5 (+)
unnamed: Q15.2 (E), RN14.3 (R2), U2.3 (+)
unnamed: Q16.2 (E), RN14.2 (R1), U2.5 (+)
unnamed: Q17.1 (D), RN1.1 (common), RN2.1 (common), RN3.1 (common), RN4.1 (common), RN5.1 (common), RN6.1 (common), RN7.1 (common), RN8.1 (common)
unnamed: Q17.2 (G), R84.2, R85.2
unnamed: R50.1, R51.2
unnamed: RV4.2, U1.2 (-), U1.6 (-), U2.2 (-), U2.6 (-)
unnamed: RV1.2, U3.2 (-), U3.6 (-), U4.2 (-), U4.6 (-)
unnamed: RV2.2, U5.2 (-), U5.6 (-), U6.2 (-), U6.6 (-)
unnamed: RV3.2, U7.3 (+), U7.5 (+), U8.3 (+), U8.5 (+)
VCC: A1.27 (+5V), C2.2, C3.1, C4.1, C5.1, C6.1, C7.1, C8.1, C9.1, C10.1, C11.1, D17.2 (A), D18.2 (A), D19.2 (A), D20.2 (A), D21.2 (A), D22.2 (A), D23.2 (A), D24.2 (A), D25.2 (A), D26.2 (A), D27.2 (A), D28.2 (A), D29.2 (A), D30.2 (A), D31.2 (A), D32.2 (A), D33.2 (A), D34.2 (A), D35.2 (A), D36.2 (A), D37.2 (A), D38.2 (A), D39.2 (A), D40.2 (A), D41.2 (A), D42.2 (A), D43.2 (A), D44.2 (A), D45.2 (A), D46.2 (A), D47.2 (A), D48.2 (A), D49.2 (A), J1.4, Q1.1 (C), Q2.1 (C), Q3.1 (C), Q4.1 (C), Q5.1 (C), Q6.1 (C), Q7.1 (C), Q8.1 (C), Q9.1 (C), Q10.1 (C), Q11.1 (C), Q12.1 (C), Q13.1 (C), Q14.1 (C), Q15.1 (C), Q16.1 (C), RN9.1 (common), RN10.1 (common), RN11.1 (common), RN12.1 (common), RV1.1, RV2.1, RV3.1, RV4.1, SW2.1 (A), U2.4 (V-), U3.4 (V-), U4.4 (V-), U5.4 (V-), U6.8 (V+), U7.8 (V+), U8.8 (V+), U9.8 (V+)

Board: 2 copper layers, 98 parts (0 on the bottom side), 78 nets, no tracks yet.
