Tellurnoid/25RoboCup/北埼玉ノード/kiCad/TBTMOTOR/TB67H450FNGｘ４/TB67H450FNGｘ４.kicad_pcb

## KiCad design 北埼玉ノード/kiCad/TBTMOTOR/TB67H450FNGｘ４/TB67H450FNGｘ４.kicad_pcb (2025-11-29)

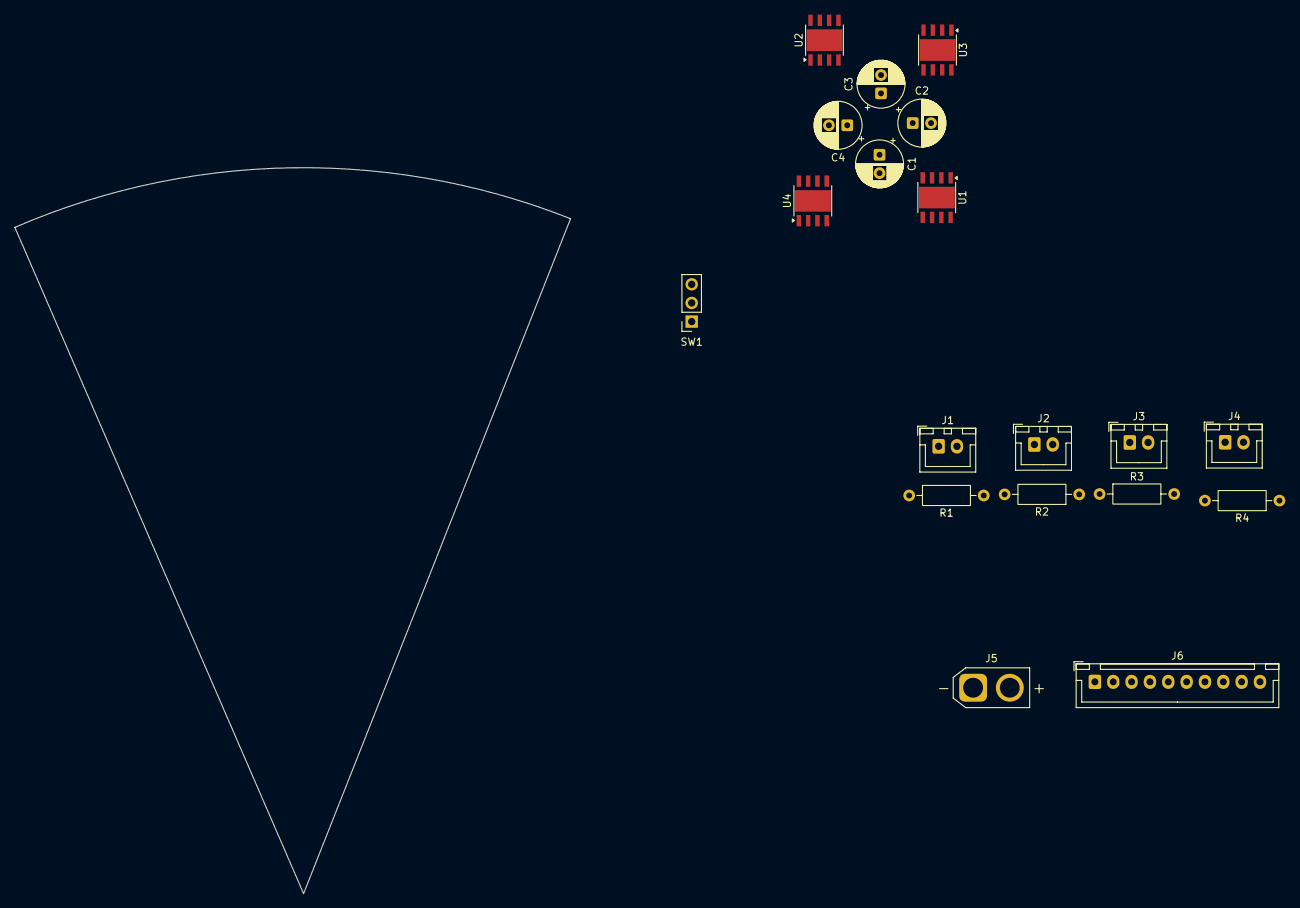
[picture p105: board TB67H450FNGｘ４.kicad_pcb from above]

Board: 2 copper layers, 75.7 x 98.9 mm, 19 parts (0 on the bottom side), 25 nets, no tracks yet.

Parts:
C1, C2, C3, C4: C_Polarized_US; CP_Radial_D6.3mm_P2.50mm
J1, J2, J3, J4: Conn_01x02_Socket; JST_XH_B2B-XH-A_1x02_P2.50mm_Vertical
J5: Conn_01x02_Socket; AMASS_XT30U-M_1x02_P5.0mm_Vertical
J6: Conn_01x10_Socket; JST_XH_B10B-XH-A_1x10_P2.50mm_Vertical
R1, R2, R3, R4: R; R_Axial_DIN0207_L6.3mm_D2.5mm_P10.16mm_Horizontal
SW1: SW_DPST_x2; PinSocket_1x03_P2.54mm_Vertical
U1, U2, U3, U4: Texas_HSOP-8-1EP_3.9x4.9mm_P1.27mm

Connections:
GND: C1.2, C2.2, C3.2, C4.2, J5.2, J6.10, R1.2, R2.2, R3.1, R4.2, U1.1 (GND), U2.1 (GND), U3.1 (GND), U4.1 (GND)
INA1: J6.2, U1.3 (IN1)
INA2: J6.3, U1.2 (IN2)
INB1: J6.4, U2.3 (IN1)
INB2: J6.5, U2.2 (IN2)
INC1: J6.6, U3.3 (IN1)
INC2: J6.7, U3.2 (IN2)
IND1: J6.8, U4.3 (IN1)
IND2: J6.9, U4.2 (IN2)
unnamed: J1.1, U1.6 (OUT1)
unnamed: J1.2, U1.8 (OUT2)
unnamed: J2.1, U2.6 (OUT1)
unnamed: J2.2, U2.8 (OUT2)
unnamed: J3.1, U3.6 (OUT1)
unnamed: J3.2, U3.8 (OUT2)
unnamed: J4.1, U4.6 (OUT1)
unnamed: J4.2, U4.8 (OUT2)
unnamed: J5.1, SW1.2 (B)
unnamed: R1.1, U1.7 (RS)
unnamed: R2.1, U2.7 (RS)
unnamed: R3.2, U3.7 (RS)
unnamed: R4.1, U4.7 (RS)
VCC: C1.1, C2.1, C3.1, C4.1, SW1.1 (A), U1.5 (VM), U2.5 (VM), U3.5 (VM), U4.5 (VM)
VERF: J6.1, U3.4 (VREF), U4.4 (VREF)
VREF: U1.4 (VREF), U2.4 (VREF)
