Tellurnoid/25RoboCup/北埼玉ノード/kiCad/地下鉄/LineSensor(桑子)/LineSensor.kicad_pcb

## KiCad design 北埼玉ノード/kiCad/地下鉄/LineSensor(桑子)/LineSensor.kicad_pcb (2025-10-06)

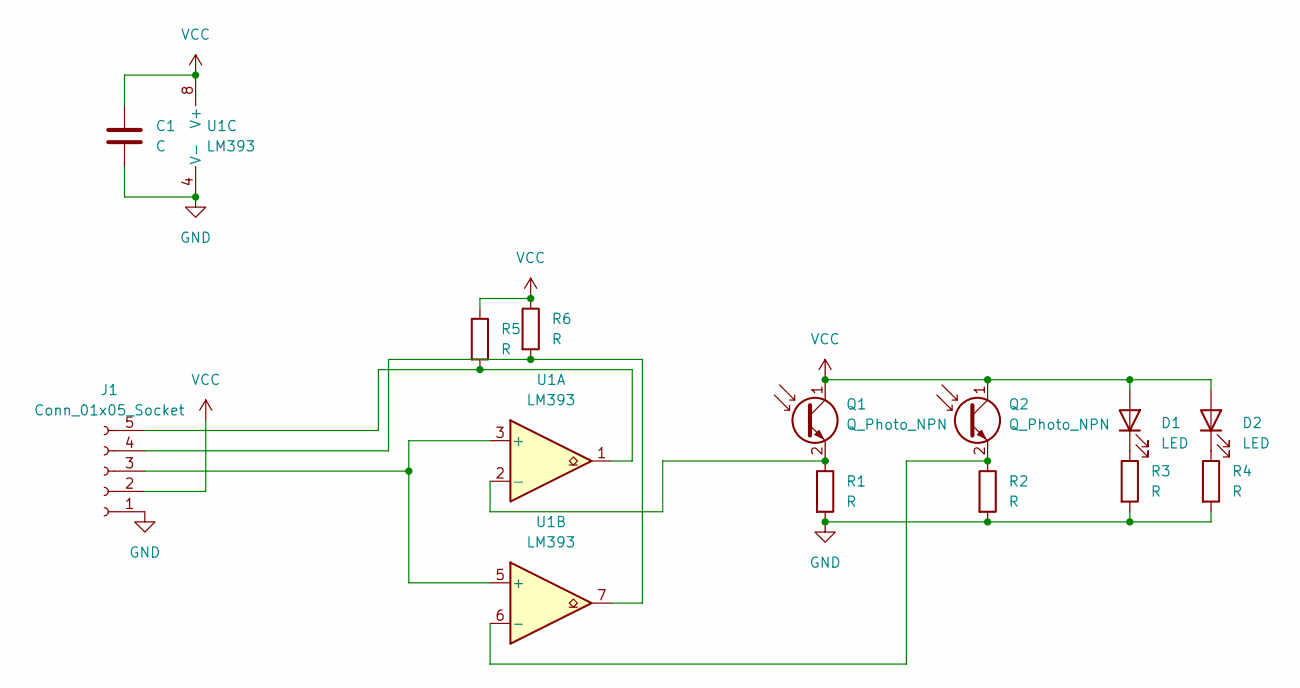
[picture p106: schematic LineSensor.kicad_sch]

Parts:
C1: C; C_Disc_D7.0mm_W2.5mm_P5.00mm
D1, D2: LED; LED_D3.0mm
J1: Conn_01x05_Socket; JST_XH_B5B-XH-AM_1x05_P2.50mm_Vertical
Q1, Q2: Q_Photo_NPN; LED_D3.0mm
R1, R2, R3, R4, R5, R6: R; R_Axial_DIN0207_L6.3mm_D2.5mm_P7.62mm_Horizontal
U1: LM393; DIP-8_W7.62mm_Socket_LongPads

Connections:
GND: C1.2, J1.1, R1.2, R2.2, R3.2, R4.2, U1.4 (V-)
unnamed: D1.1 (K), R3.1
unnamed: D2.1 (K), R4.1
unnamed: J1.3, U1.3 (+), U1.5 (+)
unnamed: J1.4, R6.2, U1.7
unnamed: J1.5, R5.2, U1.1
unnamed: Q1.2 (E), R1.1, U1.2 (-)
unnamed: Q2.2 (E), R2.1, U1.6 (-)
VCC: C1.1, D1.2 (A), D2.2 (A), J1.2, Q1.1 (C), Q2.1 (C), R5.1, R6.1, U1.8 (V+)

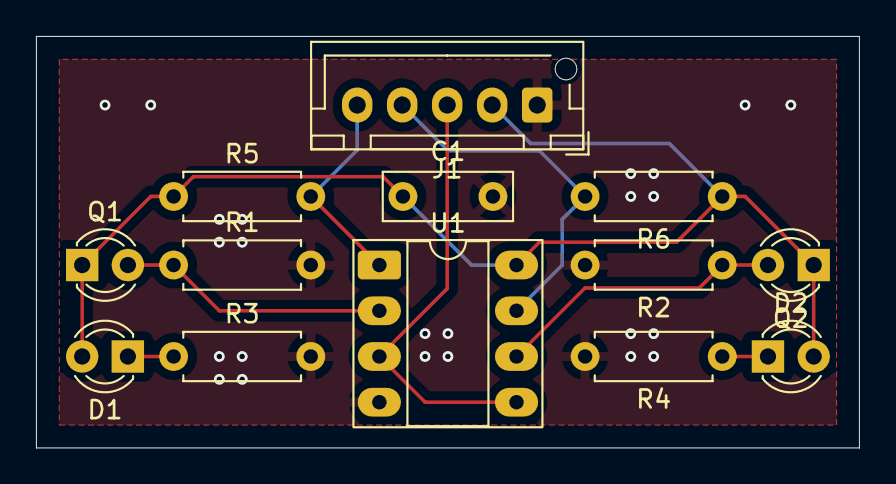
[picture p107: board 北埼玉ノード/kiCad/地下鉄/LineSensor(桑子)/LineSensor.kicad_pcb from above]

Board: 2 copper layers, 45.7 x 22.9 mm, 13 parts (0 on the bottom side), 9 nets.
