Tellurnoid/25RoboCup/北埼玉ノード/kiCad/地下鉄/LINE_sensor_keeper2/practice10.13/practice10.13.kicad_pcb

## KiCad design 北埼玉ノード/kiCad/地下鉄/LINE_sensor_keeper2/practice10.13/practice10.13.kicad_pcb (2025-10-06)

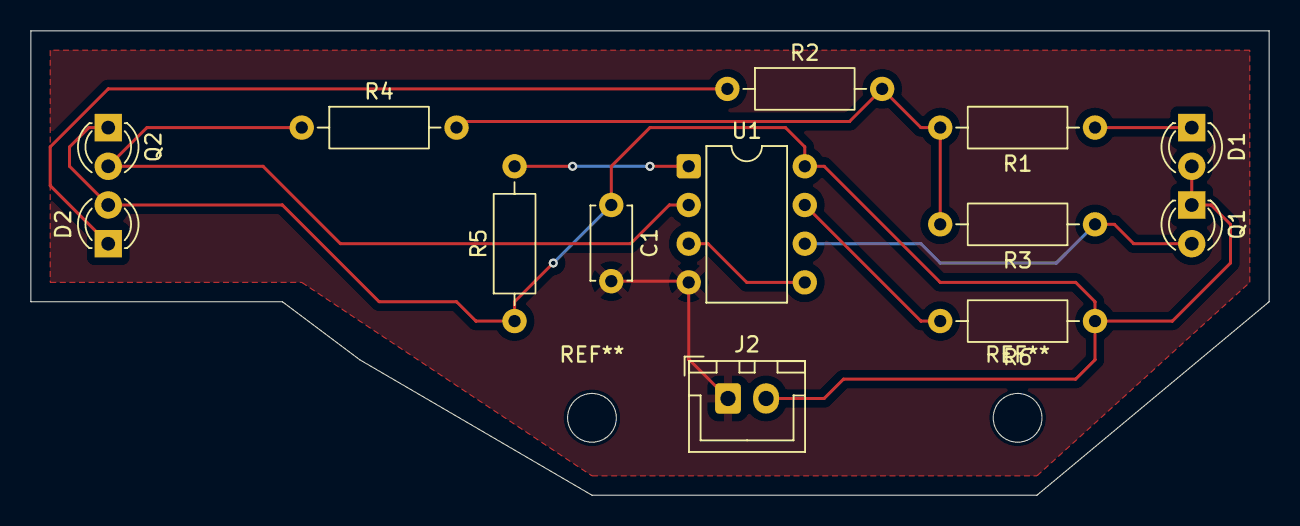
[picture p108: board practice10.13.kicad_pcb from above]

Board: 2 copper layers, 81.3 x 30.5 mm, 13 parts (0 on the bottom side), 10 nets.

Parts:
C1: C; C_Disc_D4.7mm_W2.5mm_P5.00mm
D1, D2: LED; LED_D3.0mm
J2: Conn_01x05_Socket; JST_XH_B2B-XH-A_1x02_P2.50mm_Vertical
Q1, Q2: Q_Photo_NPN; LED_D3.0mm
R1, R2, R3, R4, R5, R6: R; R_Axial_DIN0207_L6.3mm_D2.5mm_P10.16mm_Horizontal
U1: LM393; DIP-8_W7.62mm

Connections:
GND: C1.2, J2.1, U1.4 (V-)
unnamed: D1.1 (K), R1.1
unnamed: D2.1 (K), R2.1
unnamed: U1.3 (+), U1.5 (+)
unnamed: R6.2, U1.7
unnamed: R5.2, U1.1
unnamed: Q1.2 (E), R3.1, U1.6 (-)
unnamed: Q2.2 (E), R4.1, U1.2 (-)
unnamed: R1.2, R2.2, R3.2, R4.2
VCC: C1.1, D1.2 (A), D2.2 (A), J2.2, Q1.1 (C), Q2.1 (C), R5.1, R6.1, U1.8 (V+)
