Tellurnoid/25RoboCup/KiCad/NOT USED/marudachi_IR/IR_Japan_prot1/IR_Japan_prot1.kicad_sch

## KiCad design KiCad/NOT USED/marudachi_IR/IR_Japan_prot1/IR_Japan_prot1.kicad_sch (2026-02-03)

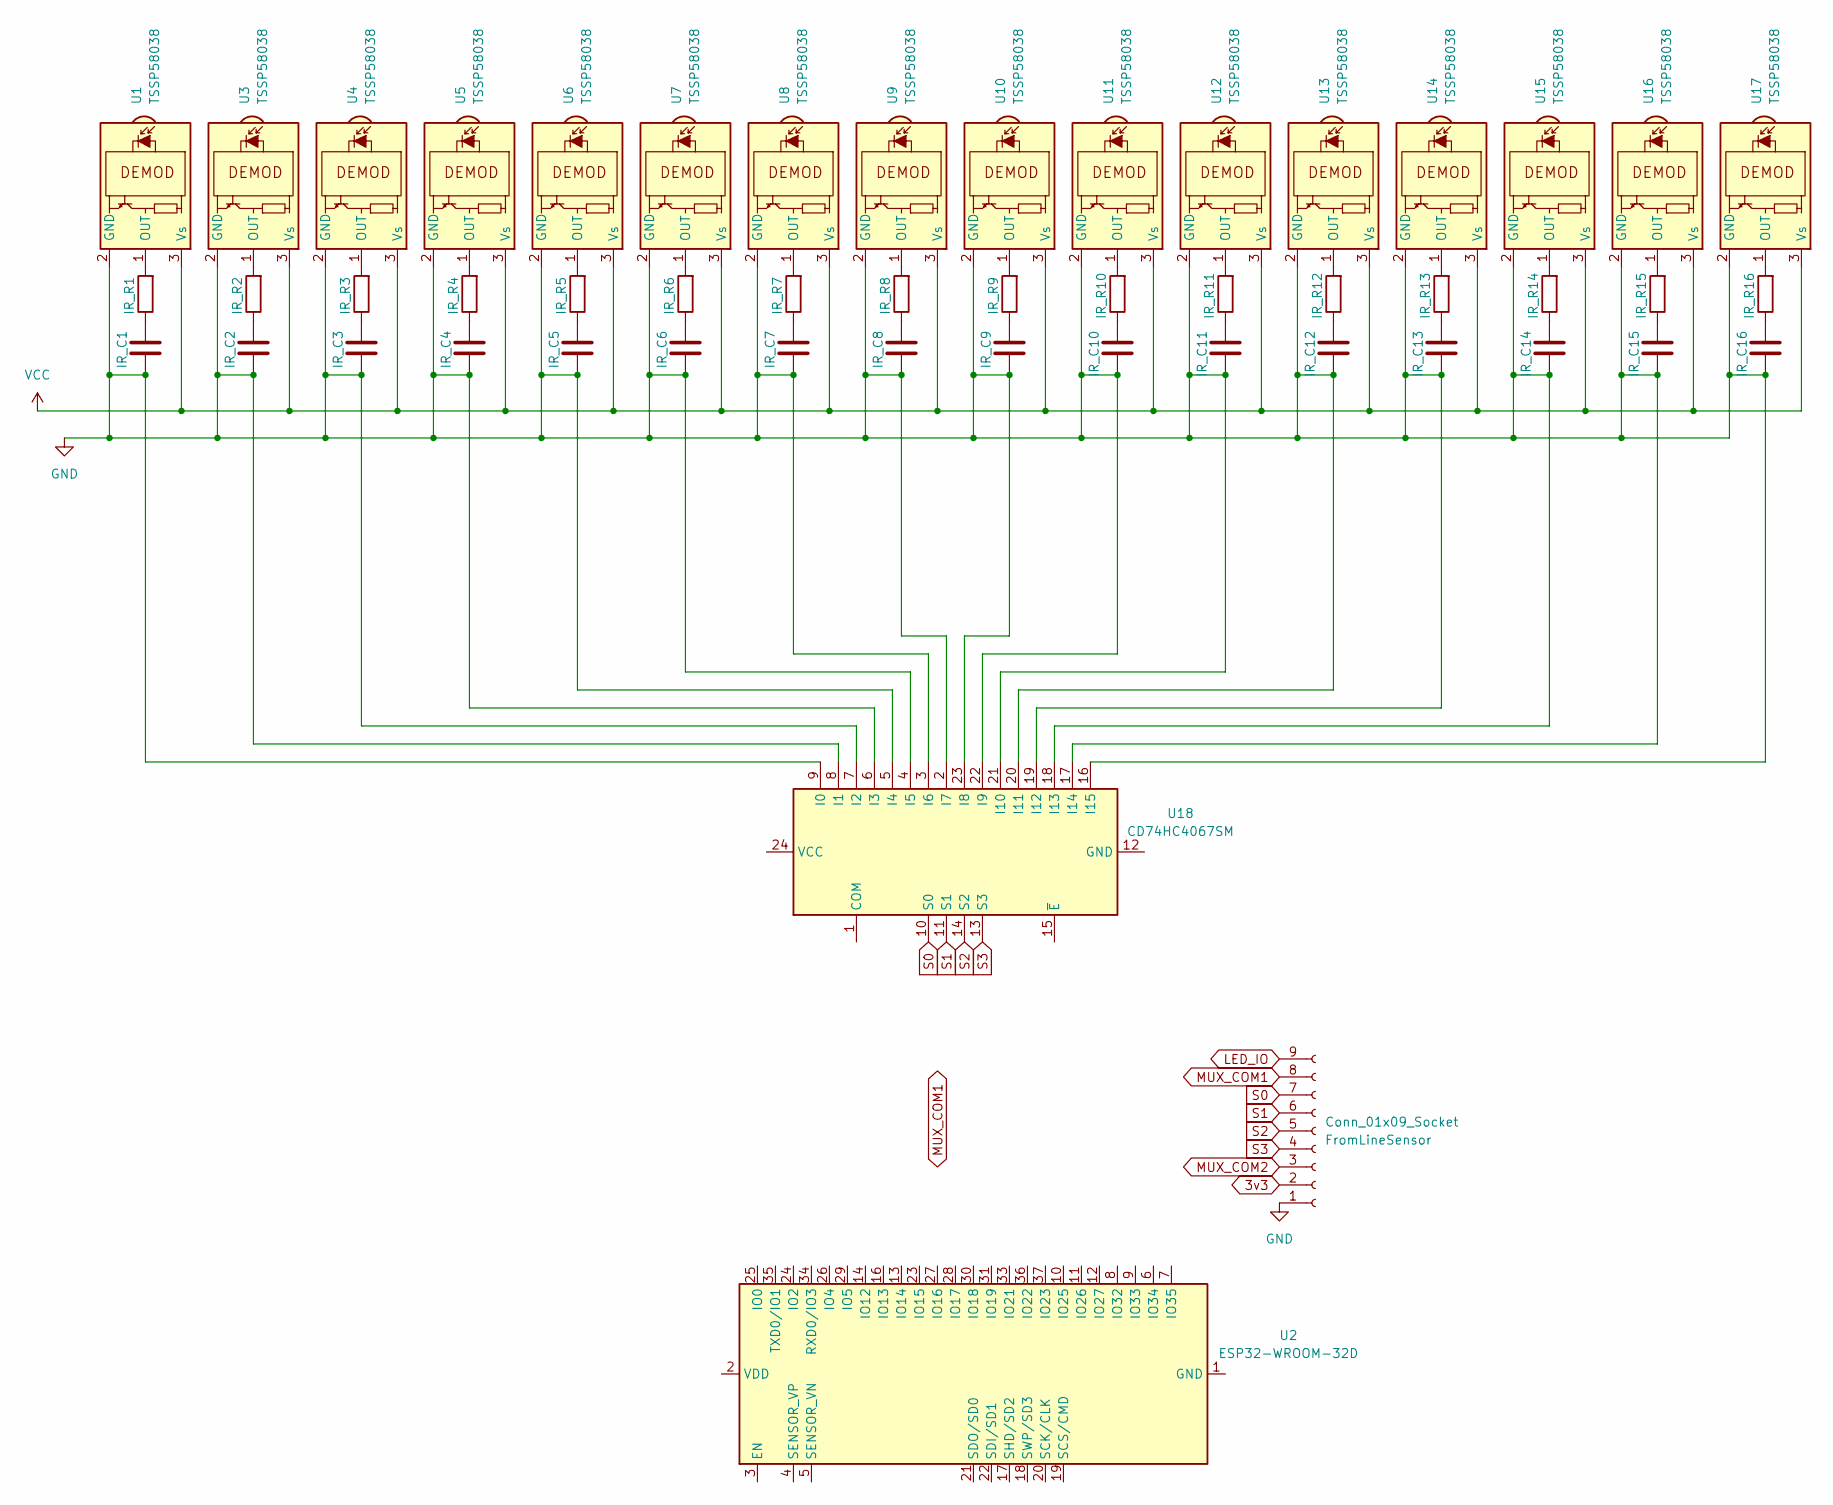
[picture p109: schematic IR_Japan_prot1.kicad_sch]

Parts:
FromLineSensor: Conn_01x09_Socket
IR_C1, IR_C2, IR_C3, IR_C4, IR_C5, IR_C6, IR_C7, IR_C8, IR_C9, IR_C10, IR_C11, IR_C12, IR_C13, IR_C14, IR_C15, IR_C16: C
IR_R1, IR_R2, IR_R3, IR_R4, IR_R5, IR_R6, IR_R7, IR_R8, IR_R9, IR_R10, IR_R11, IR_R12, IR_R13, IR_R14, IR_R15, IR_R16: R
U1, U3, U4, U5, U6, U7, U8, U9, U10, U11, U12, U13, U14, U15, U16, U17: TSSP58038; Vishay_MINICAST-3Pin
U2: ESP32-WROOM-32D
U18: CD74HC4067SM; SSOP-24_5.3x8.2mm_P0.65mm

Connections:
3v3: FromLineSensor.2
GND: FromLineSensor.1, IR_C1.1, IR_C2.1, IR_C3.1, IR_C4.1, IR_C5.1, IR_C6.1, IR_C7.1, IR_C8.1, IR_C9.1, IR_C10.1, IR_C11.1, IR_C12.1, IR_C13.1, IR_C14.1, IR_C15.1, IR_C16.1, U1.2 (GND), U3.2 (GND), U4.2 (GND), U5.2 (GND), U6.2 (GND), U7.2 (GND), U8.2 (GND), U9.2 (GND), U10.2 (GND), U11.2 (GND), U12.2 (GND), U13.2 (GND), U14.2 (GND), U15.2 (GND), U16.2 (GND), U17.2 (GND), U18.2 (I7), U18.3 (I6), U18.4 (I5), U18.5 (I4), U18.6 (I3), U18.7 (I2), U18.8 (I1), U18.9 (I0), U18.16 (I15), U18.17 (I14), U18.18 (I13), U18.19 (I12), U18.20 (I11), U18.21 (I10), U18.22 (I9), U18.23 (I8)
LED_IO: FromLineSensor.9
MUX_COM1: FromLineSensor.8
MUX_COM2: FromLineSensor.3
unnamed: IR_C1.2, IR_R1.1
unnamed: IR_C2.2, IR_R2.1
unnamed: IR_C3.2, IR_R3.1
unnamed: IR_C4.2, IR_R4.1
unnamed: IR_C5.2, IR_R5.1
unnamed: IR_C6.2, IR_R6.1
unnamed: IR_C7.2, IR_R7.1
unnamed: IR_C8.2, IR_R8.1
unnamed: IR_C9.2, IR_R9.1
unnamed: IR_C10.2, IR_R10.1
unnamed: IR_C11.2, IR_R11.1
unnamed: IR_C12.2, IR_R12.1
unnamed: IR_C13.2, IR_R13.1
unnamed: IR_C14.2, IR_R14.1
unnamed: IR_C15.2, IR_R15.1
unnamed: IR_C16.2, IR_R16.1
unnamed: IR_R1.2, U1.1 (OUT)
unnamed: IR_R2.2, U3.1 (OUT)
unnamed: IR_R3.2, U4.1 (OUT)
unnamed: IR_R4.2, U5.1 (OUT)
unnamed: IR_R5.2, U6.1 (OUT)
unnamed: IR_R6.2, U7.1 (OUT)
unnamed: IR_R7.2, U8.1 (OUT)
unnamed: IR_R8.2, U9.1 (OUT)
unnamed: IR_R9.2, U10.1 (OUT)
unnamed: IR_R10.2, U11.1 (OUT)
unnamed: IR_R11.2, U12.1 (OUT)
unnamed: IR_R12.2, U13.1 (OUT)
unnamed: IR_R13.2, U14.1 (OUT)
unnamed: IR_R14.2, U15.1 (OUT)
unnamed: IR_R15.2, U16.1 (OUT)
unnamed: IR_R16.2, U17.1 (OUT)
unnamed: U2.1 (GND), U2.15 (GND), U2.38 (GND), U2.39 (GND)
S0: FromLineSensor.7, U18.10 (S0)
S1: FromLineSensor.6, U18.11 (S1)
S2: FromLineSensor.5, U18.14 (S2)
S3: FromLineSensor.4, U18.13 (S3)
VCC: U1.3 (Vs), U3.3 (Vs), U4.3 (Vs), U5.3 (Vs), U6.3 (Vs), U7.3 (Vs), U8.3 (Vs), U9.3 (Vs), U10.3 (Vs), U11.3 (Vs), U12.3 (Vs), U13.3 (Vs), U14.3 (Vs), U15.3 (Vs), U16.3 (Vs), U17.3 (Vs)
