Tellurnoid/25RoboCup/埼玉ブロック/kiCad/IRsensor小林12.24/IRsensor_prot1/IRsensor_prot1.kicad_sch

## KiCad design 埼玉ブロック/kiCad/IRsensor小林12.24/IRsensor_prot1/IRsensor_prot1.kicad_sch (2025-12-25)

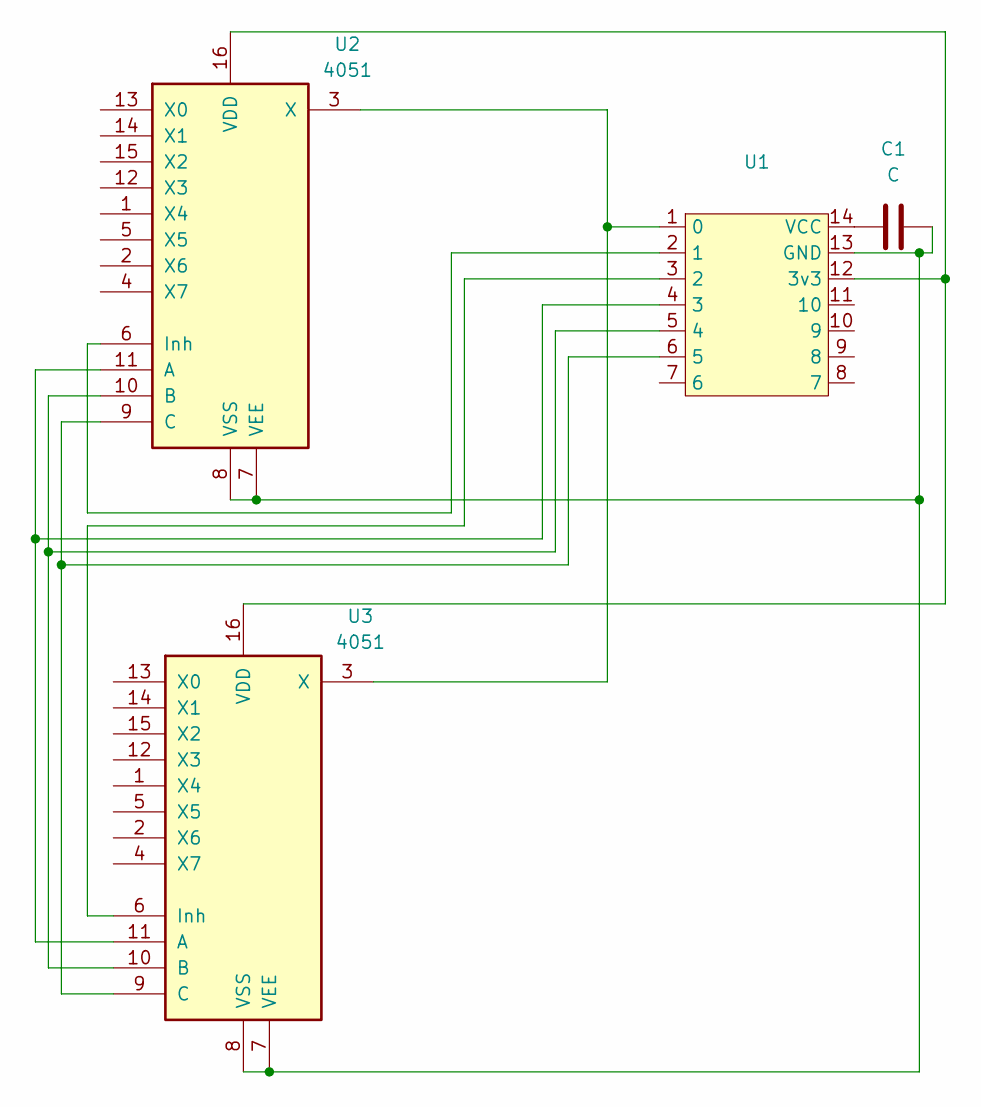
[picture p110: schematic IRsensor_prot1.kicad_sch]

Parts:
C1: C
U1: (no value)
U2, U3: 4051

Connections:
unnamed: C1.1, U1.13 (GND), U2.7 (VEE), U2.8 (VSS), U3.7 (VEE), U3.8 (VSS)
unnamed: C1.2, U1.14 (VCC)
unnamed: U1.1 (0), U2.3 (X), U3.3 (X)
unnamed: U1.2 (1), U2.6 (Inh)
unnamed: U1.3 (2), U3.6 (Inh)
unnamed: U1.4 (3), U2.11 (A), U3.11 (A)
unnamed: U1.5 (4), U2.10 (B), U3.10 (B)
unnamed: U1.6 (5), U2.9 (C), U3.9 (C)
unnamed: U1.12 (3v3), U2.16 (VDD), U3.16 (VDD)
