Tellurnoid/25RoboCup/キーパー/marudachi/3.15atacker/Main/Main/Main.ino

#include "Instance.h"
#include "Attack.h"

void setup() {
  data.initData();
  attack.initAttack();
  uart.initUART();
}

uint8_t ack = 0;

void loop() {
  uart.updateUART();

  data.updateData();

  if (data.dp.id == MAIN && data.dp.ack != ack) {
    int content = data.dp.content;
    switch (data.dp.content_id) {
    case START:
      if (content == 0) attack.setBehavior(Attack::OFF);
      if (content == 1) attack.setBehavior(Attack::BALL_CHASE);
      break;

    case RESET_GYRO:
      if (content == 1) {
        gyro.resetGyro();
        Serial.print("reset");
      }
    }
    ack = data.dp.ack;
  }

  attack.updateAttack();
}
