Tellurnoid/25RoboCup/キーパー/3.28緊急/Main/Defense.cpp

#include <Arduino.h>
#include "Instance.h"
#include "Defense.h"
#include <Adafruit_NeoPixel.h>

//sound
//////////////////////////////////////////////////////////// 超音波基礎関数//////////
    //多分使わない
    void Echo::calibrateW(){
      uint16_t count = 50;
      uint16_t sum = 0;
      for(uint16_t i=0; i<count; i++){
        uart.update();
        update();
        sum += (E + W)/2;
      }
      wall_w = sum/count;
    }

    void Echo::update(){
        //移動平均
        for(int i=0; i<8; i++){
          if(data.dp.echoValues[i] != -1){
          ave[i] = ave[i]*(1 - new_data_ratio) + data.dp.echoValues[i]*new_data_ratio;
          }
        }
        N   = ave[0];
        NE  = ave[1];
        E   = ave[2];
        SE  = ave[3];
        S   = ave[4];
        SW  = ave[5];
        W   = ave[6];
        NW  = ave[7];   

        // N_raw = data.dp.echoValues[0];
        // NE_raw = data.dp.echoValues[1];
        // E_raw = data.dp.echoValues[2];
        // SE_raw = data.dp.echoValues[3];
        // S_raw = data.dp.echoValues[4];
        // SW_raw = data.dp.echoValues[5];
        // W_raw = data.dp.echoValues[6];
        // NW_raw = data.dp.echoValues[7];
        // defense.fronts_ave = (N +NW + NE) /3;
    }

    Vector Echo::backWallBlockV(Vector v){
      //超音波によるT字対策
      if(S < wall_S && v.y < 0 && defense.is_on_yoko)//従来：abs(defense.line_angle)==90
        v.y *= -1.2;
      return v;
    }

    //ラインセンサー故障時用 要調整
    Vector Echo::withoutLineV(){
      Vector v;
        v.x = 0;
        v.y = defense.pwmDomain(goal_area_s - S + 100);
      
        v = addV(v,defense.ballV());
        if(E < wall_side + tolerance){
          v.x = -1 * defense.pwm_max;
        }
        else if(W < wall_side + tolerance){
          v.x = defense.pwm_max;
        }
      return v;
    }


//////////////////////////////////////////////////////////サイドトレース、おしりトレース///////////////////////////////////////////

//おしりトレース、サイドトレース用のangle,dis計算
void Echo::convertLine_sideOrBottom(){
     //おしりトレース用  (lineV()でのlast_lineも要確認)
    if(bottom_trace && defense.is_on_yoko && defense.line_angle != 400){
      //背後に白線あり
      if(abs(defense.line_angle) > 90){
          //しきい値より前
          if(defense.line_dis < bottom_trace_dis){
            defense.line_angle = wrap180(defense.line_angle + 180);
            defense.line_dis = abs(defense.line_dis - bottom_trace_dis);
          }
          //しきい値より後ろ
          else{
            defense.line_dis = bottom_trace_kp * abs(defense.line_dis - bottom_trace_dis);
          } 
      }
      //前に白線あり
      else{
        defense.line_dis = defense.line_dis + bottom_trace_dis;
        if(defense.line_dis > 100){
          defense.line_dis = 100;
        }
      }
    }

     //横端トレース用  (lineV()でのlast_lineも要確認)
    else if(defense.line_angle != 400 && bottom_trace == false && side_trace != 0){
        //壁側に白線
        if((defense.line_angle > 0 && side_trace == 1) || (defense.line_angle < 0 && side_trace == 2)){
            //しきい値より前
            if(defense.line_dis < side_trace_dis){
              defense.line_angle = wrap180(defense.line_angle + 180);
              defense.line_dis = abs(defense.line_dis - side_trace_dis);
            }
            //しきい値より後ろ
            else{
              defense.line_dis = side_trace_kp * abs(defense.line_dis - side_trace_dis);
            } 
        }
        //壁の逆側に白線
        else{
            defense.line_dis = defense.line_dis + side_trace_dis;
            if(defense.line_dis > 100){
              defense.line_dis = 100;
            }
        }
      }
}

void Echo::updateLineOrBottom(){
        //後ろ近ければおしりトレース有効化
        if(S < wall_S){
          bottom_trace = true;
          side_trace   = 0;
          defense.line_kp = bottom_trace_kp;
          convertLine_sideOrBottom();
        }
        //右が近ければサイドトレース有効化
        else if(E < wall_side){
          bottom_trace = false;
          side_trace   = 1;
          defense.line_kp = side_trace_kp;
          convertLine_sideOrBottom();
        }
        //左が近ければサイドトレース有効化
        else if(W < wall_side){
          bottom_trace = false;
          side_trace   = 2;
          defense.line_kp = side_trace_kp;
          convertLine_sideOrBottom();
        }
        else{
          bottom_trace = false;
          side_trace = 0;
          defense.line_kp = defense.line_default_kp;
        }
}


///////////////////////////////////////////////////////////キーパー基礎関数、初期化//////////////////////////

void Defense::off(){
  ledOff();
 // Serial.println(analogRead(28));
}

//アタッカー側で呼び出す用
void Defense::finishKeeperDash() {
  Serial.println("TO DIFFENSE");
  state = back_to_goal_withCAM;
  attack.setBehavior(Attack::OFF);
}


//最大値、最小値の中に留める関数(404で無効化)
int Defense::pwmDomain(int val){
    int max = pwm_max;
    int min = pwm_max * -1;
    if(val < min){
        return min;
    }
    else if(val > max){
        return max;
    }
    else{
        return val;
    }
}

void Defense::setBehavior(State s){
  state = s;
}
// void Defense::setPixels(Adafruit_NeoPixel* p) {
//     this->pixels = p;
// }
void Defense::LED_init(){
    pixel.begin();
    pixel.clear();
    ledOff();
}
void Defense::ledOff(){
  LED_color = pixel.Color(0, 0, 0);
  pixel.setPixelColor(0, LED_color);//G,R,B
  pixel.show();
}
void Defense::init(){
  LED_init();
  Serial.begin(115200);
}

///////////////////////////////////////////////////////// デバッグ ///////////////////////

void Defense::debugSerial(){
    //  Serial.print("flag:");
    //  Serial.print(is_enough_time);
    //  Serial.print(",  time:");
    //  Serial.print(dash_interval_now);
      // Serial.print("is_on_tate:");
      // Serial.print(is_on_tate);
      // Serial.print("ave:");
      // Serial.print(fronts_ave);
      // Serial.print(", State:");
      // Serial.print(state);
      // Serial.print(" (");
      // Serial.print(defense_v.x);
      // Serial.print(",");
      // Serial.print(defense_v.y);
      // Serial.print(")  ");

      Serial.print(", Ball_dis=");
      Serial.print(ball_dis);

      // Serial.print("Line(");
      // Serial.print(line_angle);
      // Serial.print(",");
      // Serial.print(line_dis);

      Serial.print(",   leaveMode:");
      Serial.print(leave_mode);
      // Serial.print(", echo_dif=");
      // Serial.print(echo.echo_dif);

      // Serial.print(", keeper_dash:");
      // Serial.print(keeper_dashing);
      // Serial.print(", ball_speed:");
      // Serial.print(ball_speed);
      // Serial.print("Velocity(");
      // Serial.print(data.dp.velocity_v.x);
      // Serial.print(",");
      // Serial.print(data.dp.velocity_v.y);
      // Serial.print(")");
      Serial.print(", N=");
      Serial.print(echo.N); 
      //Serial.print(" ,NE=");
      // Serial.print(echo.NE); 
      Serial.print(" ,E=");Serial.print(echo.E); 
       //Serial.print(" ,SE=");
      // Serial.print(echo.SE);
       Serial.print(" ,S=");Serial.print(echo.S); 
       //Serial.print(" ,SW=");
      // Serial.print(echo.SW);
      Serial.print(" ,W="); Serial.print(echo.W); 
      // Serial.print(" ,NW=");
      // Serial.print(echo.NW); Serial.print(",");
      // Serial.print(",   powers=");
      // Serial.print(echo.central_power); Serial.print(",");
      // Serial.print(echo.righter_power); Serial.print(",");
      // Serial.print(echo.lefter_power); 
      Serial.print("blue(");
      Serial.print(cam_atack_angle);
      Serial.print(",");
      Serial.print(cam_atack_dis);
      Serial.print(")");
      Serial.print(", yellow(");
      Serial.print(cam_angle);
      Serial.print(",");
      Serial.print(cam_dis);
      Serial.print(")");

      // Serial.print(", leave:");
      // Serial.print(echo.leaveLineV(leave_mode).x);Serial.print(",");Serial.print(echo.leaveLineV(leave_mode).y);
      // Serial.print(")");
       Serial.print(", leave count:");
       Serial.print(leave_count);
  if(line_angle != 400){
    
  }
  Serial.println();
}
void Defense::debugLED(){
  //G,R,B
          switch(state){
              case OFF://0
                LED_color = pixel.Color(0, 0, 0);
                break;
              case line_tracing://1
                //ライントレース中：緑
                LED_color = pixel.Color(255, 0, 0);
                break;
              case lost_line://2
                //ロストライン：黄色
                LED_color = pixel.Color(255, 255, 0);
                break;
                //ダッシュ：青
              case keeper_dash://3
                LED_color = pixel.Color(0, 0, 255);
                break;
                //カメラ復帰：紫
              case back_to_goal_withCAM://4
                LED_color = pixel.Color(0, 255, 255);
                break;
                //超音波復帰:赤
              case back_to_goal_withECHO://5
                LED_color = pixel.Color(0, 255, 0);
                break;
                //脱出：白
              case leave_line://6
                LED_color = pixel.Color(255, 255, 255);
                break;
                //セルフトレース：青緑
              case self_trace://7
                LED_color = pixel.Color(150, 0, 200);
                break;
              //キーパーダッシュ用leave：弱め青
              case leave_dash://8
                LED_color = pixel.Color(0, 0, 150);
                break;
          }
  pixel.setPixelColor(0, LED_color);//G,R,B
  pixel.show();
}

//////////////////////////////////////////////////////////////   アップデート  ///////////////////////////////////////
void Defense::updateVelocity(){
    vel_x = data.dp.velocity_v.x;
    vel_y = data.dp.velocity_v.y;
    vel_power = sqrt(vel_x * vel_x + vel_y * vel_y);
  }


//タテ、ヨコの認識が負安定なとき調整
void Defense::updateLine(){
    line_angle = data.dp.line_angle;
    line_dis   = data.dp.line_distance;
    //  is_on_yoko = (abs(line_angle) < 20 || abs(line_angle)>170);
    //  is_on_tate = (abs(line_angle) > 70 && abs(line_angle) < 110);
     is_on_yoko = (abs(line_angle) < 20 || abs(line_angle)>170);
     is_on_tate = (abs(line_angle) > 60 && abs(line_angle) < 120);
     echo.updateLineOrBottom();
  }

void Defense::updateBall(){
    if(data.dp.ball_angle != 400){
      ball_angle = convertAngle(data.dp.ball_angle);
    }
    else{
      ball_angle = data.dp.ball_angle;
    }
    ball_dis   = data.dp.ball_distance;
    ball_speed = getBallD();
    if(ball_speed > ball_speed_max){
      ball_speed = ball_speed_max;
    }
  }

void Defense::updateCam(){
    //黄色を守り、青に攻める
     if(data.dp.is_attack_to_blue == true){
        cam_angle       = data.dp.yellow_angle;
        cam_dis         = data.dp.yellow_distance;
        cam_atack_angle = data.dp.blue_angle;
        cam_atack_dis   = data.dp.blue_distance;
     }
     //青を守り、黄色に攻める
     else{
        cam_angle       = data.dp.blue_angle;
        cam_dis         = data.dp.blue_distance;
        cam_atack_angle = data.dp.yellow_angle;
        cam_atack_dis   = data.dp.yellow_distance;
     }
      //超音波のみでデバッグするとき用↓
     if(is_off_cam == true){
        cam_angle       = 400;
        cam_atack_angle = 400;
        cam_dis         = 0;
        cam_atack_dis   = 0;
     }
  }

//angleZ更新用
void Defense::updateMPU(){
    angleZ = data.dp.robot_angle;
  }

void Defense::updateAllData(){
      echo.update();
      updateLine();
      updateBall();
      updateCam();    
      updateMPU();
      updateVelocity();
  }

void Defense::update(){
          updateAllData();
          switch(state){
              case OFF:
                off();
                break;
              case line_tracing:
                lineTrace();
                break;
              case lost_line:
                lostLine();
                break;
              case keeper_dash:
                dash();
                break;
              case back_to_goal_withCAM:
                lostGoalCamera();
                break;
              case back_to_goal_withECHO:
                lostGoalEcho();
                break;
              case leave_line:
                leaveLine(leave_mode);
                break;
              case self_trace:
                selfTrace();
                break;
              case leave_dash:
                leaveDash();
                break;
          }
        if(state!=OFF && is_use_debug){
          debugSerial();
          debugLED();
        }
  }




////////////////////////////////////////////////////////////// ボール  /////////////////////////////
  float Defense::getBallD() {
  uint32_t now = millis();
  uint32_t dt_ms = now - last_time;
  if (dt_ms > BALL_D_INTERVAL) {
    float dt = dt_ms / 1000.0f;
    ball_d = (convertAngle(ball_angle) - last_ball_angle) / dt;
    last_time = now;
    last_ball_angle = convertAngle(ball_angle);
  }
  ball_d = ball_d * 0.4 + last_ball_d * 0.6;
  last_ball_d = ball_d;
  return ball_d;
}

Vector Defense::ballV(){
    Vector v = makeV(reverseAngle(0),0);
    if(ball_angle != 400){
      //ボールを最速で追うベクトル
      v = makeV(reverseAngle(ball_angle),pwm_max);
      //その絶対値
      float ball_angle360 = reverseAngle(ball_angle);
      float line_angle360 = reverseAngle(line_angle);
      float ballV_angle;
      
      if(ball_angle > 0){
        ballV_angle = wrap360(line_angle360-90);
      }
      else{
        ballV_angle = wrap360(line_angle360+90);
      }
      float power = lenV(v, ballV_angle); 
      v = makeV(ballV_angle,power);
      if(is_use_ball_speed == true){
        if(v.x < 0){
          v.x -= abs(ball_speed);
        }
        else{
          v.x += abs(ball_speed);
        }
      }
    }
      return v;
  }



////////////////////////////////////////////////////////////// ライントレース ///////////////////////////////
//比例のみ
Vector Defense::lineV_onlyP(){
    Vector v = makeV(reverseAngle(0),0);
    float power = line_dis * line_kp;
    float angle = line_angle;
    v = makeV(reverseAngle(line_angle),power);
    last_line = makeV(reverseAngle(line_angle),lost_line_kp * vel_power);

    //       //おしりトレースで見失ったときの減速対策
    // if(echo.bottom_trace && is_on_yoko && abs(line_angle) > 90){
    //   last_line = makeV(reverseAngle(line_angle),echo.lost_bottom_kp * vel_power);
    // }
    // //サイドトレースで見失ったときの減速対策
    // if(echo.side_trace != 0 && is_on_yoko && abs(line_angle) > 90){
    //   last_line = makeV(reverseAngle(line_angle),echo.lost_side_kp * vel_power);
    // }
      return v;
}

Vector Defense::lineV(){
  //PID制御(tbc)
  // Vector v = makeV(reverseAngle(0),0);
  //   //比例
  //    line_P = line_dis * line_kp;

  //   //微分
  //   unsigned long now = millis();
  //   float dt = (now - prev_time) / 1000.0;
  //   line_D = line_kd * (line_dis - prev_line_dis) / dt;

  //   //積分
  //   line_I += line_ki * line_dis / dt;

  //   float power = line_P + line_I + line_D;
  //   if(power > pwm_max){
  //     power = pwm_max;
  //   }
  //   float angle = line_angle;
  //   v = makeV(reverseAngle(line_angle),power);
  //   lost_v = v;

  //   prev_line_dis = line_dis;
  //   return v;
    Vector v = makeV(reverseAngle(0),0);
    float power = line_dis * line_kp;
    float angle = line_angle;
    v = makeV(reverseAngle(line_angle),power);
    //last_line = makeV(reverseAngle(line_angle),line_kp*100);
    //機体速度に応じるやつ↓
    last_line = makeV(reverseAngle(line_angle),lost_line_kp * 100);

    // //おしりトレースで見失ったときの減速対策
    // if(echo.bottom_trace && is_on_yoko && abs(line_angle) > 90){
    //   last_line = makeV(reverseAngle(line_angle),echo.lost_bottom_kp * vel_power);
    // }
    // //サイドトレースで見失ったときの減速対策
    // if(echo.side_trace != 0 && is_on_yoko && abs(line_angle) > 90){
    //   last_line = makeV(reverseAngle(line_angle),echo.lost_side_kp * vel_power);
    // }
      return v;
}

Vector Defense::TlineV(Vector v){
      if(line_angle == 500){
        v.x = 0;
        if(v.y < 0){
           v.y *= T_line_minus_power;
          }
      }
     return v;
}

Vector Defense::notToOwnGoal(Vector v){
    //ライントレース中ボールが背後にあったら8割の速度にする
    if(line_angle != 400 && abs(ball_angle) > 90){
      v.x *= 0.8;
      v.y *= 0.8;
    }
  return v;
}

void Defense::lineTrace(){
    Vector v = makeV(reverseAngle(0),0);
    //キーパーダッシュ連続作動防止
     is_enough_time = (millis() - start_time > wait_time);
    dash_interval_now = millis() - start_time;
    //ラインが見えない
    if(line_angle == 400){
      state = lost_line;
    }
    //脱出
    else if(isNeedToLeave() == 1){
      state = leave_line;
      v = {0,0};
    }
    // //ボール見えないとき中央に向かう
    // else if(ball_angle == 400){
    //     lost_count = 0;
    //     state = self_trace;
    // }
    //T字
    else if(isNeedToLeave()==500){
        lost_count = 0;
        v = assembleV(lineV(),ballV(),pwm_max);
        v = TlineV(v);
        v = echo.backWallBlockV(v);
    }
    //ラインもボールも認識中   通常のライントレース
    else{
       //キーパーダッシュ
       if(isNeedTo_Dash() == 1 && is_enough_time && on_dash == true){
          attack.startKeeperDash();  
          start_time = millis(); // 開始時間を記録
          v = {0,0};
       }
       else
       {
          v = assembleV(lineV(),ballV(),pwm_max);
          //縦線上で後退するときは減速
          bool is_on_tate = (abs(line_angle) > 45 && abs(line_angle) < 135);
          if(is_on_tate && v.y < 0){
            v.x *= 0.3;
            v.y *= 0.3;
          }
          v = notToOwnGoal(v);
          v = TlineV(v);
          v = echo.backWallBlockV(v); 
       }    
       lost_count = 0;
    }
      defense_v = v;
      data.dp.main_v = defense_v;
      defense_rotate = gyro.controlAngle(0);
      data.dp.main_rotate = defense_rotate;
}

void Defense::lostLine(){
    Vector v = makeV(reverseAngle(0),0);
    keeperDash_count = 0;
    if(line_angle != 400){
          //脱出
     if(isNeedToLeave()==1){
        state = leave_line;
      }
      else{
        state = line_tracing; 
      }
    }
    //ラインを見失って一定時間経過後、カメラで戻る
    else if(lost_count >= 400){
      state = back_to_goal_withCAM;
    }
    //最後の白線へ
    else{
     v = last_line;//lineV()内で更新
    lost_count++;
    //復帰した瞬間の回転待ち
    if(abs(angleZ) > 90){
      v = makeV(reverseAngle(0),0);  
    }
 }
      defense_v = v;
      data.dp.main_v = defense_v;
      defense_rotate = gyro.controlAngle(0);
      data.dp.main_rotate = defense_rotate;
}


//////////////////////////////////////////////////////////////////カメラ復帰//////////////////////

Vector Defense::cameraV(){
  Vector v;
  v.x = makeV(reverseAngle(cam_angle),pwm_max).x;
  v.y = echo.goal_area_s - echo.S;

  //横軸の安全対策
  if(abs(v.x) > 300){
    if(v.x >= 0)
      v.x = 300;
    if(v.x < 0)
      v.x = -300;
  }
  //後退時の最小値
  if(echo.S == -1 || (v.y < 0 && abs(v.y) < 200)){
    v.y = -200;
  }
  //後ろに壁があって、前進するときの最大値
  if(v.y > 0 && abs(v.x) < 200){
    v.y = 200;
  }
  return v;
}

void Defense::lostGoalCamera(){
    Vector v = makeV(reverseAngle(0),0);
    //カメラ認識できなければ超音波
    if(cam_angle == 400){
      state = back_to_goal_withECHO;
    }
    //ライン踏んだら
    else if(line_angle != 400){
        if(isNeedToLeave()==500){
          state = line_tracing;
        }
        else if(isNeedToLeave()==1){
          state = leave_line;
        }
        else{
          state = line_tracing;
        }
    }
    //カメラ適用、後退速度は超音波使用
    else{
       v = cameraV();
    }
    
      defense_v = v;
      data.dp.main_v = defense_v;
      defense_rotate = gyro.controlAngle(0);     
      data.dp.main_rotate = defense_rotate; 
}



//////////////////////////////////////////////////////超音波復帰/////////////////////

Vector Echo::lostGoalEchoV(){
    Vector v;
    float last_vx;
    //v.y = defense.pwmDomain(goal_area_s - S + 200);
    v.y = -1 * abs(speed_back);


  if(E != -1 && W != -1){
      //遮蔽物なしで横幅の計測成功したとき
      if(E + W < 700){
        v.x = 0;
      }
      else if(E < wall_w){
        v.x = (E - wall_w)*lost_goal_echo_kp; 
      }
      else if(W < wall_w){
        v.x = (wall_w - W)*lost_goal_echo_kp;
      }
      else{
        v.x = 0;
      }
      last_vx = v.x;
    }
    else{
      v.x = last_vx;
    }
  //横軸の安全対策
  if(abs(v.x) > 300){
    if(v.x >= 0)
      v.x = 300;
    if(v.x < 0)
      v.x = -300;
  }
  //後退時の最小値
  if(S == -1 || (v.y < 0 && abs(v.y) < 200)){
    v.y = -200;
  }
  //後ろに壁があって、前進するときの最大値
  if(v.y > 0 && abs(v.x) < 200){
    v.y = 200;
  }
    return v;
}
void Defense::lostGoalEcho(){
  Vector v = {0,0};
  //カメラ見えたら切り替える
  if(cam_angle != 400){
    state = back_to_goal_withCAM;
  }
  //ライン踏んだら
  else if(line_angle != 400){
    if(isNeedToLeave()==500){
      state = line_tracing;
    }
    else if(isNeedToLeave()==1){
      state = leave_line;
    }
    else{
      state = line_tracing;
    }
  }
  //超音波適用
  else{
    v = echo.lostGoalEchoV();
  }
    defense_v = v;
    data.dp.main_v = defense_v;
    defense_rotate = gyro.controlAngle(0);
    data.dp.main_rotate = defense_rotate;
}






//////////////////////////////////////////////////////// 脱出 ///////////////////////////////

uint16_t Defense::isNeedToLeave(){
  //攻めるべきゴールに近いか
  //現在：相手ゴール見えて自陣見えない または 相手のゴールのほうが近い
  is_on_atack_goal = (
                       off_front_leave == false &&
                       (cam_dis != 400) &&
                       (cam_dis > 100) 
                     );
                    //(cam_far_from_goal && echo.N < echo.goal_area_n && echo.S > echo.goal_area_s*1.5)
  
  if(line_angle == 500){
    leave_count = 0;
    return 500;
  }
  //横からの脱出判定はカウントが条件なので、白線出るまで動き続ける
  else if(
           state == leave_line                      && 
           (leave_mode == 'W' || leave_mode == 'E') &&
           line_angle != 400
          )
      {
      return 1;
  }
  //ゴールラインのトレースを始めたとき
  else if(
          echo.S < echo.wall_S         
          &&
          echo.N > echo.goal_area_s
          &&
          is_on_yoko
          )
      {
      leave_mode = 'S';
      state = leave_line;
      return 1;
  }
  //相手のゴール前でトレースを始めたとき
  else if(is_on_atack_goal){
    leave_mode = 'N';
    state = leave_line;
    return 1;
  }
  //タッチライン(右)のトレースを始めたとき
  else if(
           off_side_leave == false
           &&
          //  cam_angle != 400
          //  && 
          //  cam_dis > cam_far_from_goal
          //  &&
           echo.E < echo.wall_side
           &&
           echo.W > echo.wall_side  * 1.5
           &&
           echo.S > echo.goal_area_s * 1.5
          )
           {
              leave_count++;
              if(leave_count >  side_leave_timing){
                leave_mode = 'E';
                state = leave_line;
                return 1;
              }
              else{
                return 0;
              }
           }
//タッチライン(左)のトレースを始めたとき
  else if(
            off_side_leave == false
            &&
            // cam_angle != 400
            // &&
            // cam_dis > cam_far_from_goal
            // &&
            echo.W < echo.wall_side
            &&
            echo.E > echo.wall_side *1.5
            &&
            echo.S > echo.goal_area_s * 1.5
          )
           {
            leave_count++;
            if(leave_count > side_leave_timing){
              leave_mode = 'W';
              state = leave_line;
              return 1;
            }
            else{
              return 0;
            }
          }
  //脱出の必要がないと判断
  else{
    leave_count = 0;
    return 0;
  }
}

  Vector Echo::leaveLineV(char direction){
    Vector v;
    if(direction == 'N'){
      //後方３つの超音波を見て動く
      central_power = leave_kp * abs((N  < S) ? echo_dif - N : 0);
      righter_power = leave_kp * abs((NE < SW)? echo_dif - NE: 0);
      lefter_power  = leave_kp * abs((NW < SE)? echo_dif - NW: 0);
      back_wall_power = 0;
      central_angle = 270;
      righter_angle = 225;
      lefter_angle  = 315;
      // central_power = 600;///////////////////////////////要調整
    }
    else if(direction == 'S'){
      central_power = leave_kp * abs((S  < N) ? echo_dif - S : 0);
      righter_power = leave_kp * abs((SW < NE)? echo_dif - SW: 0);
      lefter_power  = leave_kp * abs((SE < NW)? echo_dif - SE: 0);
     righter_power = 0;
     lefter_power = 0;
      central_power = leave_power_S;
      back_wall_power = 0;
      central_angle = 90;
      righter_angle = 45;
      lefter_angle  = 135;
    }
    else if(direction == 'E'){
      central_power = leave_kp * abs((E  < W)  ? echo_dif - E : 0);
      righter_power = leave_kp * abs((SE < NW) ? echo_dif - SE: 0);
      lefter_power  = leave_kp * abs((NE < SW) ? echo_dif - NE: 0);
      back_wall_power = leave_kp * ((S < wall_S)? echo_dif - S: 0);
      central_angle = 180;
      righter_angle = 135;
      lefter_angle  = 225; 
    }
    else if(direction == 'W'){
      central_power = leave_kp * abs((W  < E)  ? echo_dif - W : 0);
      righter_power = leave_kp * abs((NW < SE) ? echo_dif - NW: 0);
      lefter_power  = leave_kp * abs((SW < NE) ? echo_dif - SW: 0);
      back_wall_power = leave_kp * ((S < wall_S)? echo_dif - S: 0);
      central_angle = 0;
      righter_angle = 215;
      lefter_angle  = 45;
    
    }

    central = makeV(central_angle, central_power);
    righter = makeV(righter_angle, righter_power);
    lefter  = makeV(lefter_angle,  lefter_power);
    // righter_angle = wrap360(central_angle + 45);
    // lefter_angle = wrap360(central_angle - 45);
    v = {
          central.x + righter.x + lefter.x,
          central.y + righter.y + lefter.y,
        };
   // v = central;
    return v;
  }

  //directionは進む方向ではなく壁の方向なので注意
  void Defense::leaveLine(char direction){
    Vector v;
    //その他脱出関係の処理
    if(line_angle == 400){
      state = back_to_goal_withCAM;
    }
    else if(isNeedToLeave() == 0){
      state = line_tracing;
    }
    else{
      sound.single();
      v = echo.leaveLineV(direction);
      defense_v = v;
      data.dp.main_v = defense_v;
      defense_rotate = gyro.controlAngle(0);          
      data.dp.main_rotate = defense_rotate;
    }
  }





/////////////////////////////////////////////////////////セルフトレース////////////////

Vector Defense::selfTraceV(float percent){
  Vector v;
  float angle;
  if(ball_angle != 400){
    state = line_tracing;
  }
  //カメラ
  else if(cam_angle != 400){
    if(180 - abs(cam_angle) < 10){
      v = {0,0};
    }
    //ゴールが左側にある
    else if(cam_angle < 0){
      v = makeV(135,3*(180 - abs(cam_angle))+150);
    }
    //ゴールが右側にある
    else{
      v = makeV(45,3*(180 - abs(cam_angle))+150);
    }
  }
  // else if(echo.E == -1 || echo.W == -1){
  //   v = {0,0};
  // }
  else{
    if(echo.E < echo.W){
       //= (abs(line_angle) > 90)? angle = line_angle+90:angle = line_angle-90;
       v = makeV(135,200);
    }
    else{
      v = makeV(45,200);
    }
  }
  return v;
}

void Defense::selfTrace(){
  Vector v;
  //ボールが見えたとき、ライン見えないときは通常のライントレース
      if(isNeedToLeave()==1 && line_angle != 400){
        state = leave_line;
        defense_v = {0,0};
    }

  else if(ball_angle != 400 || line_angle == 400){
    //脱出    else{
      state = line_tracing;
      defense_v = {0,0};
    }
    
  
//T字
  else if(isNeedToLeave()==500){
      lost_count = 0;
      v = assembleV(lineV(),ballV(),pwm_max);
      v = TlineV(v);
      v = echo.backWallBlockV(v);
  }
  //脱出
  else if(isNeedToLeave()==1){
      state = leave_line;
      defense_v = {0,0};
  }
  //selfTraceV適用
  else {
    defense_v = assembleV(lineV(),selfTraceV(40),pwm_max);
  }
    data.dp.main_v = defense_v;
    defense_rotate = gyro.controlAngle(0);          
    data.dp.main_rotate = defense_rotate; 
}







////////////////////////////////////////////////////////キーパーダッシュ////////////////////////
uint8_t Defense::getH_axis(){
  // if(cam_angle != 400){
    
  // }
  // //超音波でヨコを測る
  // else{
  //   // if(echo.E < 330)
  // }
  return 0;
}

uint8_t Defense::isNeedTo_Dash(){
  bool need   = false;
  bool NE_on = false;
  bool NW_on = false;

  bool is_ball_low_speed = (ball_speed < 15);
  bool near_ball = (ball_dis > dash_ball_dis);
  bool angle_ok  = (abs(ball_angle) < 50);
  bool N_ok      = (echo.N  > 400);
  bool NE_ok     = (echo.NE > 250);
  bool NW_ok     = (echo.NW > 250);

  if(on_dash && N_ok && NE_ok && NW_ok && ball_dis > 4 && abs(ball_angle) < 40){
    return 1;
  }
  else{
    return 0;
  }


  // if(near_ball && angle_ok && N_ok){
  //   return 1;
  // }
  // else{
  //   return 0;
  // }


  // //カメラ見えるとき
  // if(cam_angle != 400){
  //   //機体がゴールより右側にあるとき
  //   if(cam_angle < 0 && cam_angle > -1 * echo_off_angle){
  //     NE_on = false;
  //     NW_on = true;
  //   } 
  //   //機体がゴールより左側にあるとき   
  //   else if(cam_angle > 0 && cam_angle < echo_off_angle){
  //     NE_on = true;
  //     NW_on = false;
  //   }
  //   else{
  //     NE_on = true;
  //     NW_on = true;
  //   }
  // }
  // //カメラ見えないとき(同じことを超音波で)
  // else{
  //   if(E < echo_off_dis){
  //     //両方近い
  //     if(W < echo_off_dis){
  //       NE_on = true;
  //       NW_on = true;
  //     }
  //     else{
  //       NE_on = false;
  //       NW_on = true;
  //     }
  //   }
  //   else{
  //     //
  //     if(W < echo_off_dis){
  //       NE_on = true;
  //       NW_on = false;
  //     }
  //     else{
  //       NE_on = true;
  //       NW_on = true;
  //     } 
  //   }
  // }
  // if(!N_ok){
  //   return 0;
  // }
  // else if(NE_on && !NE_ok){
  //   return 0;
  // }
  // else if(NW_on && !NW_ok){
  //   return 0;
  // }
  // else{
  //   return 1;
  // }
}


//キーパーダッシュやめる条件
uint8_t Defense::isNeedTo_BackFromDash(){
  // bool is_too_much_back = (dash_back_count > 100);
  // bool is_too_much_run  = (dash_count > how_much_dash);
  // if(
  //   //  echo.S < int16_t(echo.wall_h * 0.5) 
  //   // ||
  //   // is_too_much_back
  //   // ||
  //      is_too_much_run
  //   ){
  //   return 0;
  // }
  // else{
  //   return 1;
  // }
  return 0;
}
Vector Defense::leaveDashV(){
  Vector v;
  float angle = reverseAngle(ball_angle);
  float power = pwm_max * 0.5;
  v = makeV(angle,power);
  return v;
}
void Defense::leaveDash(){
  // Vector v;
  //     if(line_angle == 400){
  //       state = keeper_dash;
  //       keeper_dashing = true;
  //     }
  //     else{
  //       keeper_dashing = false;
  //       v = makeV(reverseAngle(ball_angle),pwm_max*0.5);
  //     }
  //       v = defense.leaveDashV();
  //       defense_v = v;
  //       data.dp.main_v = defense_v;
  //       defense_rotate = gyro.controlAngle(0);          
  //       data.dp.main_rotate = defense_rotate;
}
Vector Defense::dashV(){
  Vector v = makeV(reverseAngle(ball_angle),pwm_max *0.8);
  return v;
}
void Defense::dash(){
    // Vector v = {0,0};
    // if(keeper_dashing == false){
    //   state = back_to_goal_withCAM;
    // }
    // defense_v = v;
    // data.dp.main_v = defense_v;
    // defense_rotate = gyro.controlAngle(0);          
    // data.dp.main_rotate = defense_rotate;

//以下アタッカーなしでの仮動作
//     Vector v = makeV(reverseAngle(0),0);
//     //アタッカーのコードを
//     //ここで呼び出し　or　変数切り替えてmain.inoで呼び出し

// /////////EXPO時のもの↓

//           //前に白線がある場合は除外、後ろの超音波見てボール追う

//           //大丈夫そうならボールを追う
//           if(isNeedTo_BackFromDash() != 0){
//             v = dashV();
//             dash_count++;
//             if(v.y < 0){
//               dash_back_count++;
//             }
//           }
//           else{
//             dash_count = 0;
//             dash_back_count = 0;
//             //カメラで復帰
//             state = back_to_goal_withCAM;
//           }
          
//           // //タッチライン踏んだときの処理
//           // if(is_on_yoko){
//           //   //右
//           //   if(line_angle > 0){
//           //     v.x = -500;
//           //   }
//           //   //左
//           //   else{
//           //     v.x = 500;
//           //   }
//           // }
//           defense_v = v;
//           data.dp.main_v = defense_v;
//           defense_rotate = gyro.controlAngle(0);          
//           data.dp.main_rotate = defense_rotate;
}
