Tellurnoid/25RoboCup/IR基板/IR_Japan_RCJ_2025/UART.ino

// ========= パケット用データ =========
// struct ReadPacketData0 { int ball_angle; int goal_angle; };
// struct ReadPacketData1 { int ball_angle; int ball_distance; };
// struct ReadPacketData2 { int x; };
#include <Arduino.h>
ReadPacketData0 rp0;//メインESP32と
ReadPacketData1 rp1;//カメラと
ReadPacketData2 rp2;//超音波と

// struct SendPacketData0 { int ball_angle; int ball_distance; };
// struct SendPacketData1 { int ball_angle; int goal_angle; };
// struct SendPacketData2 { int x; };

SendPacketData0 sp0;
SendPacketData1 sp1;
SendPacketData2 sp2;

// ========= ユーティリティ =========
uint8_t calcChecksum(uint8_t* data, uint8_t len) {
  uint8_t sum = 0;
  for (int i = 0; i < len; i++) sum ^= data[i];
  return sum;
}

template <typename readT>
bool readPacket(int num_serial, readT &d) {

  HardwareSerial *seri;
  if (num_serial == 0)      seri = &Serial;
  else if (num_serial == 1) seri = &Serial1;
  else                      seri = &Serial2;

  uint8_t header;

  // ========= ヘッダー検索（ブロッキングしない） =========
  while (seri->available()) {
    header = seri->read();
    if (header == 0xAA) break;
  }

  // ヘッダが来ていないなら終了
  if (header != 0xAA) return false;

  // ========= 長さ取得 =========
  if (!seri->available()) return false;
  uint8_t len = seri->read();

  // サイズ不一致は即破棄
  if (len != sizeof(readT)) {
    while (seri->available()) seri->read();  // ✅ バッファ全消去
    return false;
  }

  // ========= 受信バッファが多すぎたら古いのを捨てる =========
  int expected = len + 1;  // data + checksum

  if (seri->available() > expected) {
    int trash = seri->available() - expected;
    while (trash--) seri->read();   // ✅ 古いデータ破棄
  }

  // ========= 必要分が揃っていなければ待たずに終了 =========
  if (seri->available() < expected) return false;

  // ========= データ受信 =========
  uint8_t buf[64];
  for (int i = 0; i < len; i++) {
    buf[i] = seri->read();
  }

  uint8_t checksum = seri->read();

  // ========= チェックサム検証 =========
  uint8_t sum = calcChecksum(buf, len);
  if (checksum != sum) return false;

  // ========= struct にコピー =========
  memcpy(&d, buf, len);
  return true;
}


// ========= パケット送信 =========
template <typename sendT>
void sendPacket(int num_serial, sendT &d) {

    HardwareSerial *seri;
    if (num_serial == 0) seri = &Serial;
    else if (num_serial == 1) seri = &Serial1;
    else seri = &Serial2;

    uint8_t* p = (uint8_t*)&d;
    uint8_t len = sizeof(sendT);
    uint8_t cs = calcChecksum(p, len);

    seri->write(0xAA);
    seri->write(len);
    seri->write(p, len);
    seri->write(cs);
}

// ========= UART 初期化 =========
void initUART() {
  Serial.begin(230400);//toMAIN ESP32
  Serial1.begin(115200, SERIAL_8N1, 19, 18);  //TX, RX // to カメラ !!ピン注意！
  Serial2.begin(115200, SERIAL_8N1, 17, 16);  // to Echo_ArduinoNano
}


//int16_t serial_date;　

// ========= UART 読み取り =========
void UART() {
  sp0.ball_angle = ball_angle;
  sp0.ball_distance = ball_distance;
  sp0.ball_max = ball_max;

  readPacket(2, rp2);
  sp0.dis1 = rp2.dis1;
  sp0.dis2 = rp2.dis2;
  sp0.dis3 = rp2.dis3;
  sp0.dis4 = rp2.dis4;
  
  readPacket(1, rp1);
  sp0.c_x = rp1.c_x;
  sp0.c_y = rp1.c_y;
  sp0.c_s = rp1.c_s;
  sendPacket(0, sp0);

  //UI作るならここ書いて
  //sp2.serial_date = ball_angle;
  //sendPacket(2, sp2);
}
