Tellurnoid/25RoboCup/キーパー/3.28緊急/Main/Sound.cpp

#include "Instance.h"
#include "Sound.h"

void Sound::init(){
    pinMode(beep, OUTPUT);
}

void Sound::success() {
  digitalWrite(beep, HIGH);
  delay(50);
  digitalWrite(beep, LOW);
  delay(50);
  digitalWrite(beep, HIGH);
  delay(30);
  digitalWrite(beep, LOW);      
}

void Sound::single() {
  digitalWrite(beep, HIGH);
  delay(50);
  digitalWrite(beep, LOW);
}

void Sound::update() {
  if (state.sp.gyro_calibration == 1) {
    digitalWrite(beep, HIGH);
  }
  else {
    digitalWrite(beep, LOW);

    if (state.sp.near_wall == 1) {
      digitalWrite(beep, HIGH);
    }
    else digitalWrite(beep, LOW);
  }
}
