Tellurnoid/25RoboCup/キーパー/3.28緊急/Main/functions.h

#pragma once

struct Vector {
  float x;
  float y;
};

inline Vector makeV(float deg, float speed) {  //角度と速さからベクトルを作る
  Vector v;
  float rad = deg * M_PI / 180.0;
  v.x = cos(rad) * speed;
  v.y = sin(rad) * speed;
  return v;
}

// float getCom(Vector v, float deg) {
//   float rad = deg * PI / 180.0f;
//   return v.x * cos(rad) + v.y * sin(rad);
// }


inline Vector addV(Vector a, Vector b) {  //ベクトルの足し算
  Vector result;
  result.x = a.x + b.x;
  result.y = a.y + b.y;
  return result;
}

inline Vector assembleV(Vector a, Vector b, float max_len) {
  float len_a = sqrt(a.x*a.x + a.y*a.y);

  if (len_a >= max_len) return a;

  float remain = max_len - len_a;

  float len_b = sqrt(b.x*b.x + b.y*b.y);

  if (len_b <= remain) return addV(a, b);

  float scale = remain / len_b;

  Vector result;
  result.x = a.x + b.x * scale;
  result.y = a.y + b.y * scale;

  return result;
}

inline Vector normalizeV(Vector v) { // 正規化（単位ベクトル化）
  float len = sqrt(v.x * v.x + v.y * v.y);
  if (len == 0) return {0, 0};
  return { v.x / len, v.y / len };
}

inline Vector changeLenV(Vector v, int len_v) {
  float len = sqrt(v.x * v.x + v.y * v.y);
  if (len == 0) return {0, 0};
  return { v.x / len * len_v, v.y / len * len_v };
}

inline float lenV(Vector v, int deg) { // vのdeg方向のベクトルの大きさを調べる
  float rad = deg * PI / 180.0f;
  float dir_x = cos(rad);
  float dir_y = sin(rad);

  float result = v.x * dir_x + v.y * dir_y;
  return result;
}

inline int angleDiff(int a, int b) {
  int d = a - b;
  while (d > 180) d -= 360;
  while (d < -180) d += 360;
  return d;
}

// -180〜180 に正規化
inline float wrap180(float angle) {
  angle = fmod(angle + 180.0, 360.0);
  if (angle < 0) angle += 360.0;
  return angle - 180.0;
}

// 0〜360 に正規化
inline float wrap360(float angle) {
  angle = fmod(angle, 360.0);
  if (angle < 0) angle += 360.0;
  return angle;
}

// 元 → 変換後
inline float convertAngle(float theta) {
  return wrap180(90.0 - theta);
}

// 逆変換
inline float reverseAngle(float theta_p) {
  return wrap360(90.0 - theta_p);
}
