Tellurnoid/25RoboCup/キーパー/marudachi/attacker/Main 2/Main/UART.ino

#include "UART.h"

ToHub to_hub;

FromHub from_hub;
FromHub data_hub;

FromSub from_sub;
FromSub data_sub;

void initUART() {
  Serial.begin(115200);
  Serial1.begin(115200, SERIAL_8N1, 16, 17);
  Serial2.begin(115200, SERIAL_8N1, 18, 19);
}

void updateUART() {
  if (readPacket(Serial2, from_sub) == READ_OK) {
    data_sub = from_sub;
  }

  if (readPacket(Serial1, from_hub) == READ_OK) {
    data_hub = from_hub;
  }

  

  // to_hub.vx = main_v.x;
  // to_hub.vy = main_v.y;
  // to_hub.omega = rotatePID(0, 0);
  to_hub.content = from_sub.line_angle;
  sendPacket(Serial1, to_hub);
}
