Tellurnoid/25RoboCup/埼玉ブロック/0_LINE_RCJ/1_UART.ino

#include <Arduino.h>
// ========= パケット用データ =========
struct ReadPacketData0 { int ball_angle; int goal_angle; };
ReadPacketData0 rp0;

struct SendPacketData0 { int16_t line_angle; int16_t line_dis; };
SendPacketData0 sp0;
// ========= ユーティリティ =========
uint8_t calcChecksum(uint8_t* data, uint8_t len) {
  uint8_t sum = 0;
  for (int i = 0; i < len; i++) sum ^= data[i];
  return sum;
}

// ========= パケット読み取り =========
template <typename readT>
bool readPacket(int num_serial, readT &d) {

    Stream* seri;
    if (num_serial == 0) seri = &Serial;

    uint32_t start = millis();
    uint8_t header;

    // --- ヘッダー検索（タイムアウト 30ms） ---
    while (true) {
      if (seri->available()) {
        header = seri->read();
        if (header == 0xAA) break;  // 見つかった
      }
      if (millis() - start > 30) return false; // タイムアウト
    }

    // --- 長さ取得 ---
    while (!seri->available()) {
      if (millis() - start > 30) return false;
    }
    uint8_t len = seri->read();
    if (len != sizeof(readT)) return false;

    // --- データ + チェックサムが来るまで待つ ---
    while (seri->available() < len + 1) {
      if (millis() - start > 30) return false;
    }

    // --- 読み込み ---
    uint8_t buf[64];
    for (int i = 0; i < len; i++) buf[i] = seri->read();
    uint8_t checksum = seri->read();

    // --- チェックサム検証 ---
    uint8_t sum = calcChecksum(buf, len);
    if (checksum != sum) return false;

    // --- struct にコピー ---
    memcpy(&d, buf, len);

    return true;
}

// ========= パケット送信 =========HardwareSerial
template <typename sendT>
void sendPacket(int num_serial, sendT &d) {

//    HardwareSerial *seri;
Stream* seri;
    if (num_serial == 0) seri = &Serial;

    uint8_t* p = (uint8_t*)&d;
    uint8_t len = sizeof(sendT);
    uint8_t cs = calcChecksum(p, len);

    seri->write(0xAA);
    seri->write(len);
    seri->write(p, len);
    seri->write(cs);
}

// ========= UART 初期化 =========
void initUART() {
  Serial.begin(115200);
}

// ========= UART 読み取り =========
void UART() {
  sp0.line_angle = line_angle;
  sp0.line_dis = line_dis;
  sendPacket(0, sp0);
  // Serial.println(dis);
}
