Tellurnoid/25RoboCup/Echo_UI/UI3.27(画面OFFまで)/Echo_UI/Instance.cpp

#include "Instance.h"

// #include "UART.h"
// #include "command.h"
// #include "echo.h"
// #include "button.h"
// #include "UI.h"
// #include "sound.h"

UI ui;
Echo echo;
Button button;    
Sound sound;

UART uart;
Data data;
Command command;
