Tellurnoid/25RoboCup/埼玉ブロック/ssdUI/E_prot2/C_draw.cpp

#include<Arduino.h>
#include <U8x8lib.h>
#include "A_system.h"
#include "C_draw.h"
//#include "app.h"
U8X8_SSD1306_128X64_NONAME_HW_I2C u8x8;
Draw drawObj;

//Draw::draw(){}
void Draw::drawLine(uint8_t x1,uint8_t y1,uint8_t x2,uint8_t y2,bool color){}
void Draw::fillRect(uint8_t x,uint8_t y, uint8_t w, uint8_t t, bool color){}
void Draw::triangle(uint8_t x1,uint8_t y1,uint8_t x2,uint8_t y2,uint8_t x3,uint8_t y3,bool color){}
void Draw::fillTriangle(uint8_t x1,uint8_t y1,uint8_t x2,uint8_t y2,uint8_t x3,uint8_t y3,bool color){}


void Draw::startupShow(){
  u8x8.setCursor(1,10);
  u8x8.setFont(u8x8_font_inr21_2x4_r);
  u8x8.print("BEOLSAE");//https://lang-ship.com/blog/work/grove-beginner-kit-08-oled/
}

void Draw::homeMenu(){
  u8x8.clear();
  u8x8.setCursor(0,10);
  u8x8.setFont(u8x8_font_inr21_2x4_r);
  u8x8.print("-----------------------------------------");//https://lang-ship.com/blog/work/grove-beginner-kit-08-oled/

}
void Draw::preview_homemenu(){

}

void Draw::draw_LEDBrightness(){}
void Draw::draw_serialMonitor(){}
