Tellurnoid/25RoboCup/北埼玉ノード/ssdUI/prot3/draws.cpp

#include "draws.h"
#include <Arduino.h>
 
/*

int stickX = 0;
int stickY = 0;


#include "MyMotor.h"
#include <Arduino.h>

MyMotor::MyMotor(int pin) {
    pin_ = pin;
    pinMode(pin_, OUTPUT);
}

void MyMotor::drive(int pwm) {
    analogWrite(pin_, pwm);
}


*/
