Tellurnoid/25RoboCup/北埼玉ノード/ssdUI/prot3/draws.h

#ifndef DRAWS_H
#define DRAWS_H
/*
#ifndef MYMOTOR_H
#define MYMOTOR_H

class MyMotor {
public:
    MyMotor(int pin);
    void drive(int pwm);

private:
    int pin_;
};

extern int stickX;
extern int stickY;

#endif
*/


#endif
