Tellurnoid/25RoboCup/(commit log)

2025-10-06 10.6 kicad追加
    [LineSensor.kicad_pcb, LineSensor.kicad_sch, Line_sensor_prot1.kicad_pcb, Line_sensor_prot1.kicad_sch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]
2025-10-06 10.6 kicad追加2
    [LineSensor.kicad_pcb, LineSensor.kicad_sch, Line_sensor_prot1.kicad_pcb, Line_sensor_prot1.kicad_sch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]
2025-10-25 カメラの青色検出のテストコード.25.9.25
2025-10-25 すこしラインセンサーの回路を進めた.25.9.25
    [LineSensor.kicad_pcb, LineSensor.kicad_sch]
2025-10-26 withYata.9.26(＋ファイル整理)
2025-10-26 withYata.9.26(＋コメント整理)
2025-10-26 ロゴ追加
    [LineSensor.kicad_pcb, LineSensor.kicad_sch, Line_sensor_prot1.kicad_pcb, Line_sensor_prot1.kicad_sch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]
2025-11-03 フットプリント割あて.25.11.3
    [LineSensor.kicad_pcb, LineSensor.kicad_sch]
2025-11-04 外形の図形10.5
    [LineSensor.kicad_pcb]
2025-11-08 kicadのprot3作ってフットプリントwith桑子.11.8
    [LineSensor.kicad_pcb, LineSensor.kicad_sch]
2025-11-09 円とセンサーの配置ずれるな..11/9
    [LineSensor.kicad_pcb]
2025-11-09 センサーフットプリント調整.11.9
    [LineSensor.kicad_pcb]
2025-11-11 修学旅行行き新幹線
    [LineSensor.kicad_pcb, LineSensor.kicad_sch]
2025-11-11 11/1夜_LED配置まで
    [LineSensor.kicad_pcb, LineSensor.kicad_sch]
2025-11-13 企画別行き
    [LineSensor.kicad_pcb]
2025-11-13 LM393円形1
    [LineSensor.kicad_pcb]
2025-11-15 円形最低限
    [LineSensor.kicad_pcb]
2025-11-17 円形配置 抵抗を平行に
    [LineSensor.kicad_pcb, LineSensor.kicad_sch]
2025-11-19 prot4作成
    [LineSensor.kicad_pcb, LineSensor.kicad_sch]
2025-11-19 prot4のdrc警告なし
    [LineSensor.kicad_pcb, LineSensor.kicad_sch]
2025-11-19 11/19バケモンスケジュール
    [LineSensor.kicad_pcb]
2025-11-22 配置変更1
    [LineSensor.kicad_pcb, LineSensor.kicad_sch, Line_sensor_prot1.kicad_pcb, Line_sensor_prot1.kicad_sch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]
2025-11-23 11.24朝desktop
    [LineSensor.kicad_pcb]
2025-11-24 11.24桑子チェック1
    [LineSensor.kicad_pcb, LineSensor.kicad_sch]
2025-11-24 完成？(GPIO照らし合わせ)
    [LineSensor.kicad_pcb, LineSensor.kicad_sch]
2025-11-24 完成？(月曜帰宅)
2025-11-25 11.25チーム名印字など
    [LineSensor.kicad_pcb]
2025-11-25 ガーバー作成1
    [LineSensor-B_Adhesive.gbr, LineSensor-B_Courtyard.gbr, LineSensor-B_Cu.gbr, LineSensor-B_Fab.gbr, LineSensor-B_Mask.gbr, LineSensor-B_Paste.gbr, LineSensor-B_Silkscreen.gbr, LineSensor-Edge_Cuts.gbr]
2025-11-26 ssd1306UIスケッチファイル作成
2025-11-26 UI基板カーソル完成
2025-11-27 ガーバー再アップロード
    [LineSensor-B_Cu.gbl, LineSensor-B_Mask.gbs, LineSensor-B_Paste.gbp, LineSensor-B_Silkscreen.gbo, LineSensor-Edge_Cuts.gm1, LineSensor-F_Cu.gtl, LineSensor-F_Mask.gts, LineSensor-F_Paste.gtp]
2025-11-28 モタドラ趣味開始
    [TB67H450FNGｘ４.kicad_pcb, TB67H450FNGｘ４.kicad_sch]
2025-11-29 EEPROM試験完了
    [TB67H450FNGｘ４.kicad_pcb, TB67H450FNGｘ４.kicad_sch]
2025-11-29 UI基板基礎関数完成
2025-12-01 UI基板フォント調整まで完成
2025-12-01 boolセットアプリ実装
2025-12-03 prot2作成
2025-12-03 prot2基本関数配置
2025-12-04 ラインセンサーlm393短足
2025-12-05 12.5バスケ行く前
2025-12-11 UI基板シリアルのみ完成
2025-12-12 金曜バッテリーなし
2025-12-12 たつきのコード
2025-12-12 12.12帰る前
2025-12-14 北埼玉ノード終了
    [LineSensor-B_Adhesive.gbr, LineSensor-B_Courtyard.gbr, LineSensor-B_Cu.gbl, LineSensor-B_Cu.gbr, LineSensor-B_Fab.gbr, LineSensor-B_Mask.gbr, LineSensor-B_Mask.gbs, LineSensor-B_Paste.gbp]
2025-12-16 esc最初の実験
    [LineSensor-B_Adhesive.gbr, LineSensor-B_Courtyard.gbr, LineSensor-B_Cu.gbl, LineSensor-B_Cu.gbr, LineSensor-B_Fab.gbr, LineSensor-B_Mask.gbr, LineSensor-B_Mask.gbs, LineSensor-B_Paste.gbp]
2025-12-17 ラインセンサー部品ほぼ決定
    [LineSensor-B_Adhesive.gbr, LineSensor-B_Courtyard.gbr, LineSensor-B_Cu.gbl, LineSensor-B_Cu.gbr, LineSensor-B_Fab.gbr, LineSensor-B_Mask.gbr, LineSensor-B_Mask.gbs, LineSensor-B_Paste.gbp]
2025-12-17 注文書消した
2025-12-18 ラインセンサー素子部回路配置まで、IC割当トラブル中
    [LineSensor_Block_prot1.kicad_pcb, LineSensor_Block_prot1.kicad_sch]
2025-12-19 ラインセンサー外側の配置と配線
    [LineSensor_Block_prot1.kicad_pcb, LineSensor_Block_prot1.kicad_sch]
2025-12-22 マルチプレクソ16chにするくそ
    [LineSensor_Block_prot1.kicad_pcb, LineSensor_Block_prot1.kicad_sch]
2025-12-23 ラインセンサー再配置開始
    [LineSensor_Block_prot2.kicad_pcb, LineSensor_Block_prot2.kicad_sch]
2025-12-25 24夜まで
    [IRsensor_prot1.kicad_pcb, IRsensor_prot1.kicad_sch, LineSensor_Block_prot2.kicad_pcb]
2025-12-25 マルツ行く前
    [LineSensor_Block_prot2.kicad_pcb, LineSensor_Block_prot2.kicad_sch]
2025-12-25 あきはばら
    [LineSensor_Block_prot2.kicad_pcb, LineSensor_Block_prot2.kicad_sch]
2025-12-25 マイコン基板円形わお
    [LineSensor_Block_prot2.kicad_pcb, LineSensor_Block_prot2.kicad_sch]
2025-12-26 kicad欄センサーエラー0まで
    [LineSensor_Block_prot2.kicad_pcb, LineSensor_Block_prot2.kicad_sch, bom.csv, designators.csv, positions.csv]
2025-12-26 ガーバー作成後1
    [LineSensor_Block_prot2.kicad_pcb, LineSensor_Block_prot2.kicad_sch, bom.csv, designators.csv, positions.csv]
2025-12-26 PCB3基板発注後
    [LineSensor_Block_prot2.kicad_pcb]
2025-12-28 ふぉるだ
    [LineSensor_Block_prot2.kicad_pcb]
2025-12-28 あ.txt
2025-12-28 キーパーソフト開始
2025-12-30 rp2040PIO試験成功、キーパー機全角度対応開始
2025-12-31 とち狂い極座標を使用開始
2026-01-01 打ち消しプログラム仮完成、動作確認はまだ
2026-01-01 キーパーソフト基礎完成、超音波なし
2026-01-02 ラインセンサー基本読み込みコード完成、UARTとキャリブレーションはまだ
2026-01-06 スキー帰り
2026-01-07 rp2040メイン基板シリアル問題解消
2026-01-08 UI基板ライブラリ依存関係問題解消
2026-01-08 UIと通信開発
2026-01-08 ラインセンサーlm393はずれてくそ
2026-01-09 ラインセンサー復活！？
2026-01-09 超音波少し実装、カメラやれ
2026-01-24 雑用ファイル追加fromDesktop
    [Robocupmtd.kicad_pcb, Robocupmtd.kicad_sch]
2026-01-29 鬼円形配置爆完了
    [IRsensor_prot1.kicad_pcb, IRsensor_prot1.kicad_sch, LineSensor_Block_prot1.kicad_pcb, LineSensor_Block_prot1.kicad_sch, LineSensor_Block_prot2.kicad_pcb, LineSensor_Block_prot2.kicad_sch, Linesensor_Japan_prot1.kicad_pcb, Linesensor_Japan_prot1.kicad_sch]
2026-01-30 ラインセンサーprot1ほぼ完成
    [Kiban_deka_right.dxf, Linesensor_Japan_prot1.kicad_pcb, Linesensor_Japan_prot1.kicad_sch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]
2026-01-31 prot2ほぼ完成
    [Linesensor_Japan_prot2.kicad_pcb, Linesensor_Japan_prot2.kicad_sch, RCJ_Power.kicad_pcb, bom.csv, designators.csv, positions.csv, v2_MotorDriver.kicad_pcb]
2026-02-01 ああああああああああああああああああ
    [Linesensor_Japan_prot2.kicad_pcb, Linesensor_Japan_prot2.kicad_sch, bom.csv, designators.csv, positions.csv]
2026-02-03 IR配置ほぼ完了
    [IR_Japan_prot1.kicad_pcb, IR_Japan_prot1.kicad_sch, Kiban_deka_right.dxf, Linesensor_Japan_prot1.kicad_pcb, Linesensor_Japan_prot1.kicad_sch, Linesensor_Japan_prot2.kicad_pcb, Linesensor_Japan_prot2.kicad_sch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]
2026-02-03 すこしひらいた
2026-02-04 IR配線仕上げ前
    [IR_Japan_prot1.kicad_sch, メインの穴付き.kicad_pcb]
2026-02-04 IR完成
    [IR_Japan_prot1.kicad_pcb, IR_Japan_prot1.kicad_sch]
2026-02-05 IRあと文字
    [CIWS_main.kicad_pcb, CIWS_main.kicad_sch, IR_Japan_prot1.kicad_pcb, IR_Japan_prot1.kicad_sch, RCJ_main.kicad_pcb, RCJ_main.kicad_sch, bom.csv, designators.csv]
2026-02-05 IRシルク書き込みまで完成
    [IR_Japan_prot1.kicad_pcb]
2026-02-07 ラインセンサーベタ削除
    [bom.csv, designators.csv, positions.csv]
2026-02-08 キーパー触れ始め
2026-02-09 IRのXH4修正、発注
    [IR_Japan_prot1.kicad_pcb, bom.csv, designators.csv, positions.csv]
2026-02-10 パーカー注文
2026-02-14 リンクページ完成
2026-02-15 HP，CAD設計担当修正
2026-02-15 ライントレース7割
2026-02-16 カメラ通信成功
2026-02-16 かめらくど
2026-02-17 ラインセンサーSMDはんだ付け完了1
    [Linesensor_Japan_prot2.kicad_sch]
2026-02-18 センサーCH対応書いた
2026-02-18 打ち消し未完成
2026-02-21 ラインセンサーIRセンサーハード完成
2026-02-23 EXPO出発前
    [IR_Japan_prot1.kicad_sch]
2026-02-23 EXPO後
2026-02-25 新構文キーパーソフト開始
    [Main_RCJ_Japan_prot2.kicad_pcb, Main_RCJ_Japan_prot2.kicad_sch]
2026-02-27 MPU動作確認
2026-02-28 新メイン仮配置完了
    [Main_RCJ_Japan_prot2.kicad_pcb, Main_RCJ_Japan_prot2.kicad_sch]
2026-03-01 新メイン完成
    [IR_Japan_prot2.kicad_pcb, IR_Japan_prot2.kicad_sch, Main_RCJ_Japan_prot2.kicad_pcb, Main_RCJ_Japan_prot2.kicad_sch, bom.csv, designators.csv, positions.csv, メインの穴付き.kicad_pcb]
2026-03-02 ハードやないかい
2026-03-03 ポスターぎりちこ
2026-03-04 マルツ秋月大量発注
    [IR_Japan_prot3.kicad_pcb, IR_Japan_prot3.kicad_sch, Main_RCJ_Japan_prot2.kicad_pcb, メインの穴付き.kicad_pcb]
2026-03-04 画像インポートクラッシュくそ
    [Keyholder1.kicad_pcb, Keyholder1.kicad_sch, KickBoard.kicad_pcb, KickBoard.kicad_sch, Main_RCJ_Japan_prot2.kicad_pcb, Main_RCJ_Japan_prot2.kicad_sch, bom.csv, designators.csv]
2026-03-05 キックボードメインに結合
    [KickBoard.dxf, Main_RCJ_Japan_prot2_with_kickBoard.kicad_pcb, Main_RCJ_Japan_prot2_with_kickBoard.kicad_sch, bom.csv, designators.csv, positions.csv]
2026-03-05 vscode不穏な復帰
2026-03-06 すこしキーパー
2026-03-07 明日はラインセンサー簡易キャリブレーション
    [Linesensor_Japan_prot2.kicad_sch]
2026-03-08 テスト前日
2026-03-09 コンパイルエラー治らず
2026-03-10 UI基礎完成
2026-03-11 UIフォント追加まで
2026-03-14 [悲報]103と101間違える
    [Linesensor_Japan_prot2.kicad_sch]
2026-03-15 最低限ドッキング成功
2026-03-16 T字対策
2026-03-18 UI in_view関数削除
2026-03-18 UIカメラ仮実装
2026-03-20 leaveV()追加
2026-03-21 おしりトレースなし！ selfTrace完成
2026-03-22 復帰まだ不安定
2026-03-23 ボール速度実装まで
2026-03-24 キーパーダッシュ最低限実装
2026-03-25 川高帰宅前
2026-03-27 コマンドまで実装
2026-04-06 大会終了
